carthage-space-sciences/slant/prev/D_R4.jpg

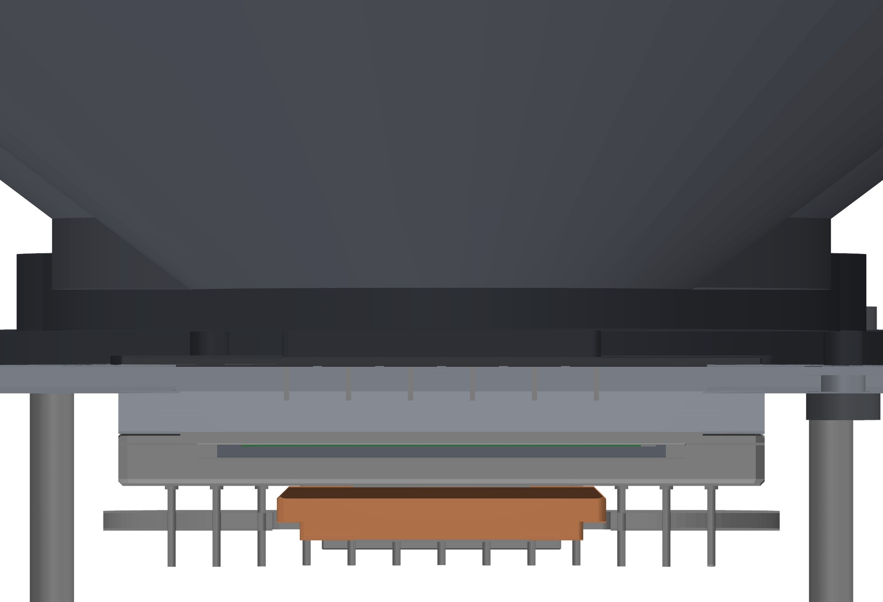
prev/D_R4.jpg
