carthage-space-sciences/slant/prev/M07.jpg

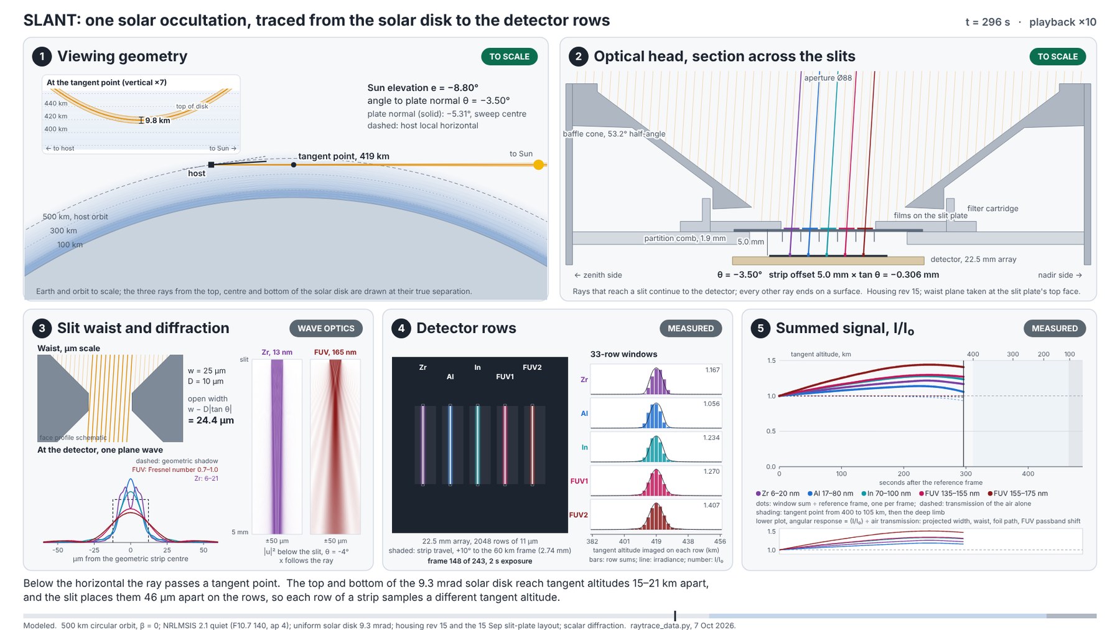
prev/M07.jpg
