carthage-space-sciences/slant/files/D_H03/SLANT-H03.pdf

## VIEW FROM OUTSIDE

## FEATURE TABLE

S1 | dia 2.80 thru (M2.5 clearance) H 76.68 V 4.01 (centre, from datum)
S2 | dia 2.80 thru (M2.5 clearance) H 76.68 V 101.49 (centre, from datum)

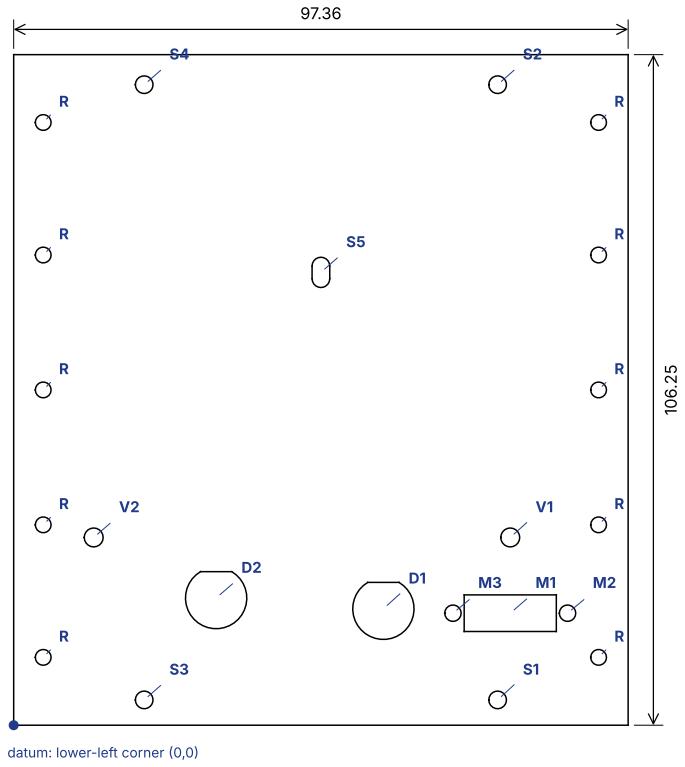
[picture p7: figure]
datum: lower-left corner (0,0)

S3 | dia 2.80 thru (M2.5 clearance) H 20.68 V 4.01 (centre, from datum)
S4 | dia 2.80 thru (M2.5 clearance) H 20.68 V 101.49 (centre, from datum)
S5 | Slot 2.80 wide x 4.80 long, vertical (bulkhead clip screw, +-1.0 travel); centre given H 48.68 V 71.75 (centre, from datum)
D1 | D-hole: dia 9.72 +-0.06, flat 9.04 +-0.05 from opposite side, flat toward the top edge (power receptacle, Glenair Series 801, shell 5) H 58.58 V 18.45 (centre, from datum)
D2 | D-hole: same as D1 (JTAG port) H 32.08 V 20.15 (centre, from datum)
M1 | Rectangle 14.60 x 5.80, corners R0.5 max (micro-D 15), long side horizontal H 78.68 V 17.75 (centre, from datum)
M2 | dia 2.60 thru (jackpost) H 87.76 V 17.75 (centre, from datum)
M3 | dia 2.60 thru (jackpost) H 69.60 V 17.75 (centre, from datum)
V1 | dia 3.00 thru (vent) H 78.68 V 29.75 (centre, from datum)
V2 | dia 3.00 thru (vent) H 12.68 V 29.75 (centre, from datum)

R 10x dia 2.50 thru (3/32 blind rivets to the corner angles):
| H 4.68 and 92.68; V 10.75, 31.75, 53.125, 74.5, 95.5
| Sheet 0.050 in (1.27 mm) 6061-T6. Laser, waterjet or router cut acceptable; hole positions +-0.1.

## NOTES

Units: millimetres. Third-angle projection. Tolerances unless stated: features and hole positions +-0.1; outline +-0.2.

Threads: ISO metric coarse, 6H. Holes marked INSERT are tapped for stainless free-running helical coil inserts,

length 1.5D, supplied and installed by the shop; drill and tap to the insert maker's data. Inserts flush to 0.25 below. Every drilled and tapped hole runs through to an open volume (venting). Break sharp edges 0.1-0.3; deburr all holes.

Finish: as machined for this unit. Please also quote: clear anodize MIL-A-8625 Type II Class 1, with the H01 host face

and the panel/angle faces under rivets masked and conversion coated MIL-DTL-5541 Type II Class 3 (electrical bonding).

Assembly is by Carthage: fasteners locked and torqued per the SLANT assembly procedure (to be issued).

Fit-check unit built to the flight layout. Material certs appreciated; no inspection report required.

Model: the STEP file of the same part number governs any dimension not shown here.

PART | SLANT-H03 panel -X (connectors)
MATERIAL | 6061-T6 sheet, 0.050 in (1.27 mm)
QTY | 1
MASS (model) | 34 g
PROJECT | SLANT 1U housing, assembly rev 16
OWNER | Carthage College, Space Sciences
DRAWN / CHECKED | from model 2026-10-08 / ________
SHEET REV | D
