carthage-space-sciences/slant/files/D_H05/SLANT-H05.pdf

### VIEW FROM OUTSIDE

## FEATURE TABLE

S1 | dia 2.80 thru (M2.5 clearance) H 78.00 V 4.01 (centre, from datum)
S2 | dia 2.80 thru (M2.5 clearance) H 78.00 V 101.49 (centre, from datum)

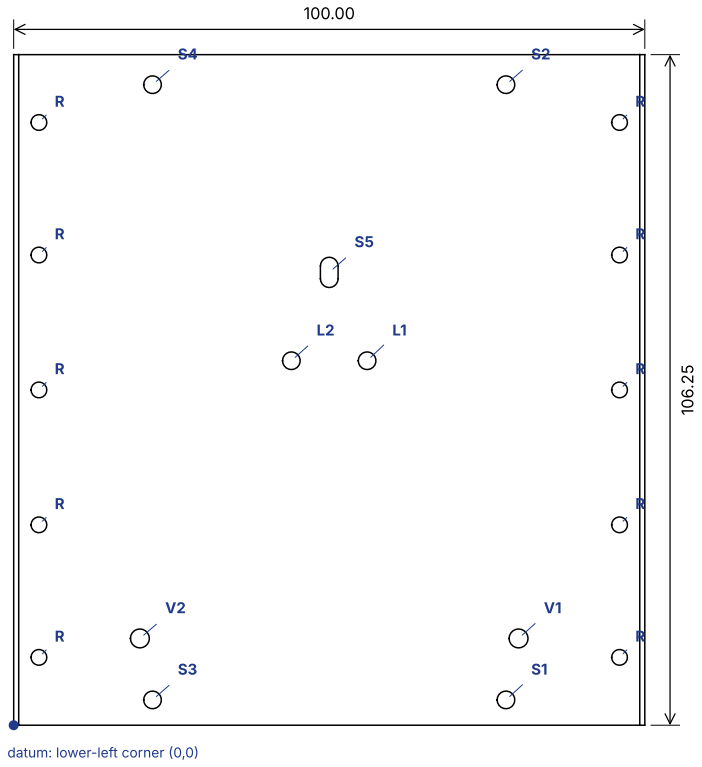
[picture p8: figure]
datum: lower-left corner (0,0)

S3 | dia 2.80 thru (M2.5 clearance) H 22.00 V 4.01 (centre, from datum)
S4 | dia 2.80 thru (M2.5 clearance) H 22.00 V 101.49 (centre, from datum)
S5 | Slot 2.80 wide x 4.80 long, vertical (bulkhead clip screw, +-1.0 travel); centre given H 50.00 V 71.75 (centre, from datum)
L1 | dia 2.80 thru (wall lug screws) H 56.00 V 57.75 (centre, from datum)
L2 | dia 2.80 thru (wall lug screws) H 44.00 V 57.75 (centre, from datum)
V1 | dia 3.00 thru (vent) H 80.00 V 13.75 (centre, from datum)
V2 | dia 3.00 thru (vent) H 20.00 V 13.75 (centre, from datum)

R 10x dia 2.50 thru (3/32 blind rivets to the corner angles):
| H 4.00 and 96.00; V 10.75, 31.75, 53.125, 74.5, 95.5
| Sheet 0.050 in (1.27 mm) 6061-T6. Laser, waterjet or router cut acceptable; hole positions +-0.1.

### NOTES

Units: millimetres. Third-angle projection. Tolerances unless stated: features and hole positions +-0.1; outline +-0.2.

Threads: ISO metric coarse, 6H. Holes marked INSERT are tapped for stainless free-running helical coil inserts,

length 1.5D, supplied and installed by the shop; drill and tap to the insert maker's data. Inserts flush to 0.25 below. Every drilled and tapped hole runs through to an open volume (venting). Break sharp edges 0.1-0.3; deburr all holes.

Finish: as machined for this unit. Please also quote: clear anodize MIL-A-8625 Type II Class 1, with the H01 host face

and the panel/angle faces under rivets masked and conversion coated MIL-DTL-5541 Type II Class 3 (electrical bonding).

Assembly is by Carthage: fasteners locked and torqued per the SLANT assembly procedure (to be issued).

Fit-check unit built to the flight layout. Material certs appreciated; no inspection report required.

Model: the STEP file of the same part number governs any dimension not shown here.
Both vertical end edges on the OUTER face: chamfer 0.8 x 45 deg (clears the corner angle's root radius).
PART | SLANT-H05 panel +Y (lug holes)
MATERIAL | 6061-T6 sheet, 0.050 in (1.27 mm)
QTY | 1
MASS (model) | 36 g
PROJECT | SLANT 1U housing, assembly rev 16
OWNER | Carthage College, Space Sciences
DRAWN / CHECKED | from model 2026-10-08 / ________
SHEET REV | D
