carthage-space-sciences/slant/files/D_H07/SLANT-H07.pdf

LEG A (lies on a +-Y panel) | LEG B (lies on a +-X panel) 106.25

END VIEW

## FEATURE TABLE

A Leg A: 5x dia 2.50 thru, centres 5.59 from the heel (outside corner), V 10.75, 31.75, 53.125, 74.5, 95.5 from the bottom end

B Leg B: 5x dia 2.50 thru, centres 7.59 from the heel,
V 10.75, 31.75, 53.125, 74.5, 95.5 from the bottom end

S Stock: 6061-T6 angle 1/2 x 1/2 x 1/16 in (12.70 x 12.70 x 1.59), cut to 106.25 +0/-0.2,
ends square. Root radius inside the angle 1.0 max. If not stocked, machine from bar.

E Hole pattern is symmetric about mid-length: the part may be installed either end up.

### NOTES

Units: millimetres. Third-angle projection. Tolerances unless stated: features and hole positions +-0.1; outline +-0.2.

Threads: ISO metric coarse, 6H. Holes marked INSERT are tapped for stainless free-running helical coil inserts,

length 1.5D, supplied and installed by the shop; drill and tap to the insert maker's data. Inserts flush to 0.25 below.

Every drilled and tapped hole runs through to an open volume (venting). Break sharp edges 0.1-0.3; deburr all holes. Finish: as machined for this unit. Please also quote: clear anodize MIL-A-8625 Type II Class 1, with the H01 host face

and the panel/angle faces under rivets masked and conversion coated MIL-DTL-5541 Type II Class 3 (electrical bonding). Assembly is by Carthage: fasteners locked and torqued per the SLANT assembly procedure (to be issued).

Fit-check unit built to the flight layout. Material certs appreciated; no inspection report required.

Model: the STEP file of the same part number governs any dimension not shown here.

PART | SLANT-H07 Corner angle
MATERIAL | 6061-T6 angle, 1/2 x 1/2 x 1/16 in
QTY | 3
MASS (model) | 10.6 g
PROJECT | SLANT 1U housing, assembly rev 16
OWNER | Carthage College, Space Sciences
DRAWN / CHECKED | from model 2026-10-08 / ________
SHEET REV | D
