carthage-space-sciences/slant/files/D_SET/SLANT-Housing-revD-Drawings.pdf

TOP VIEW (inner face) | BOTTOM VIEW (host face)

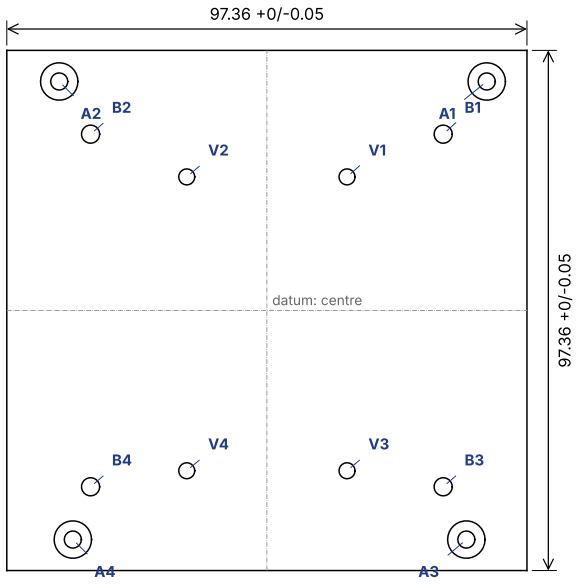
[picture p10: figure]
B1 A1 V1 datum: centre

### FRONT VIEW (from -Y), hidden lines dashed

8.52

## 12.97 +-0.05 (boss tops)

C C

## FEATURE TABLE

A1 | M3x0.5 INSERT thru boss and plate; boss dia 7.0, top 12.97 above host face. X 41.15 Y 42.86 (+-0.05, PC/104 pattern)
A2 | M3x0.5 INSERT thru boss and plate; boss dia 7.0, top 12.97 above host face. X -38.87 Y 42.86 (+-0.05, PC/104 pattern)

POCKET depth 6.02 from host face (web 2.50)

A3 | M3x0.5 INSERT thru boss and plate; boss dia 7.0, top 12.97 above host face. X 37.33 Y -42.88 (+-0.05, PC/104 pattern)
A4 | M3x0.5 INSERT thru boss and plate; boss dia 7.0, top 12.97 above host face. X -36.32 Y -42.88 (+-0.05, PC/104 pattern)
B1 | dia 3.40 thru (M3 host screw). X 33.00 Y 33.00
B2 | dia 3.40 thru (M3 host screw). X -33.00 Y 33.00
B3 | dia 3.40 thru (M3 host screw). X 33.00 Y -33.00
B4 | dia 3.40 thru (M3 host screw). X -33.00 Y -33.00
V1 | dia 3.00 thru web (vents the pocket). X 15.00 Y 25.00
V2 | dia 3.00 thru web (vents the pocket). X -15.00 Y 25.00
V3 | dia 3.00 thru web (vents the pocket). X 15.00 Y -30.00
V4 | dia 3.00 thru web (vents the pocket). X -15.00 Y -30.00

C 8x M2.5x0.45 INSERT into the four edges, 2 per edge at +-28.0 from
| centre, 4.26 above host face, 6.5 deep (breaks into pocket)

P Underside pocket, depth 6.02, R3.0 corners. Leaves: perimeter band 6.0 wide; 4x pads 14 sq at B1-B4; 4x round pads dia 9.0 under A1-A4.

F Host face (bottom) flat within 0.05. Inner face flat within 0.05 (carries the converter thermal block).

R Pocket inside corners: where a round pad meets a square pad or the band, R1.30 (the shape a dia 2.6 cutter leaves; the 2.68 channels between pads and band stay open). Corners between the pocket walls and the web underside: R1.5 max.

### NOTES

Units: millimetres. Third-angle projection. Tolerances unless stated: features and hole positions +-0.1; outline +-0.2.

Threads: ISO metric coarse, 6H. Holes marked INSERT are tapped for stainless free-running helical coil inserts,

length 1.5D, supplied and installed by the shop; drill and tap to the insert maker's data. Inserts flush to 0.25 below. Every drilled and tapped hole runs through to an open volume (venting). Break sharp edges 0.1-0.3; deburr all holes.

Finish: as machined for this unit. Please also quote: clear anodize MIL-A-8625 Type II Class 1, with the H01 host face
and the panel/angle faces under rivets masked and conversion coated MIL-DTL-5541 Type II Class 3 (electrical bonding).

Assembly is by Carthage: fasteners locked and torqued per the SLANT assembly procedure (to be issued).

Fit-check unit built to the flight layout. Material certs appreciated; no inspection report required.

Model: the STEP file of the same part number governs any dimension not shown here.

Bottom face meets the host bracket; inner face carries the board stack and the converter block.

PART | SLANT-H01 Base plate
MATERIAL | 6061-T6 plate, 5/8 in stock
QTY | 1
MASS (model) | 113 g
PROJECT | SLANT 1U housing, assembly rev 16
OWNER | Carthage College, Space Sciences
DRAWN / CHECKED | from model 2026-10-08 / ________
SHEET REV | D

TOP VIEW (outer face = aperture plane) | BOTTOM VIEW

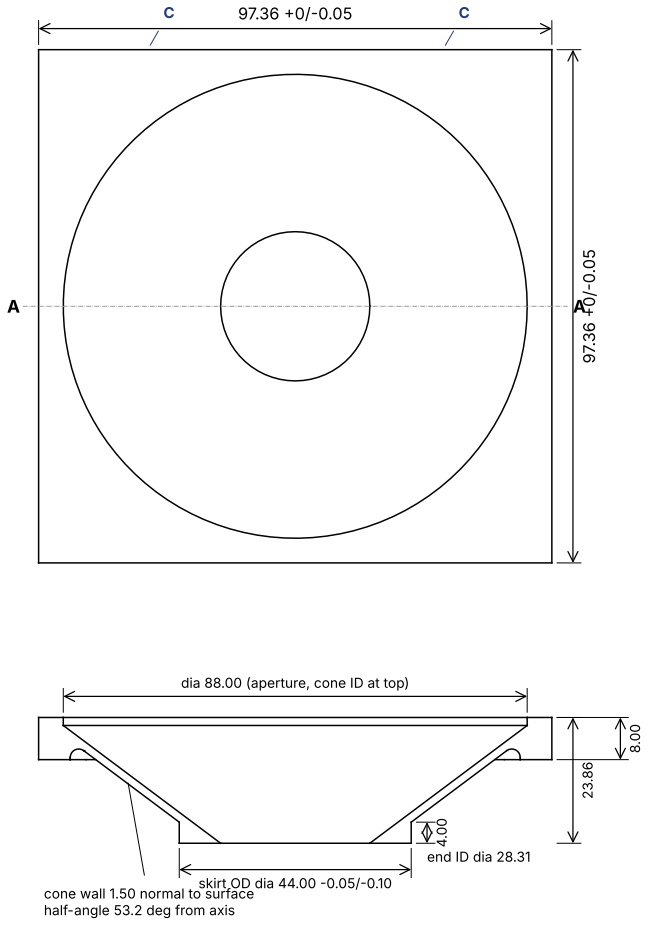
[picture p11: figure]
dia 88.00 (aperture, cone ID at top); skirt OD dia 44.00 -0.05/-0.10; end ID dia 28.31; half-angle 53.2 deg from axis

### SECTION A-A (through the axis, seen from -Y)

cone wall 1.50 normal to surface

underside pocket: square 85.36, R3.0,

to 1.52 below the outer face

A Aperture and cone ID: dia 88.00 +-0.10 at the plane 1.52 below the outer face, straight through the 1.52 web; the cone ID narrows at 53.19 deg half-angle to dia 28.31 at the skirt end face. Concentric with outline within 0.1.

W Cone wall 1.50 +-0.10 measured normal to the surface (OD is the ID offset 2.50 radially).

K Skirt at the small end: cylindrical OD dia 44.00 -0.05/-0.10, concentric with the cone ID within 0.05, running 4.00 up from the end face to where it meets the cone OD. End face flat and square to the axis within 0.05, 23.86 +-0.05 below the outer face. The skirt runs inside the H09 collar with 0.5 radial clearance and must not touch it.

P Underside pocket around the cone: square 85.36 with R3.0 corners, 6.48 deep from the inner rim face, leaving a 6.0 rim and a 1.52 web.

C 8x M2.5x0.45 INSERT into the four edges, 2 per edge at +-28.0 from centre, 4.76 below the outer face, thru the rim into the pocket

F Outer face flat within 0.05 (aperture plane). CONE ID FINISH: after turning, bead blast or etch to a matte texture of 0.1 rad rms facet slope or more; turning marks alone do not satisfy this. Black anodize or low-outgassing black coating follows for flight; as-blasted is acceptable for this unit.

M Suggested process: mill square, pocket corners and edge holes; turn cone ID from the aperture side, and the cone OD, skirt OD and end face from below, in a 4-jaw chuck. 3D-contoured cone OD also acceptable.

R Inside corners: R1.6 fillet along the four junctions of the cone OD with the flat pocket walls, blended into the web. Other pocket corners R1.5 max (R3.0 vertical corners as drawn). Where the skirt OD meets the cone OD: tool nose R1.0 max.

### NOTES

Units: millimetres. Third-angle projection. Tolerances unless stated: features and hole positions +-0.1; outline +-0.2.

Threads: ISO metric coarse, 6H. Holes marked INSERT are tapped for stainless free-running helical coil inserts,

length 1.5D, supplied and installed by the shop; drill and tap to the insert maker's data. Inserts flush to 0.25 below. Every drilled and tapped hole runs through to an open volume (venting). Break sharp edges 0.1-0.3; deburr all holes.

Finish: as machined for this unit. Please also quote: clear anodize MIL-A-8625 Type II Class 1, with the H01 host face
and the panel/angle faces under rivets masked and conversion coated MIL-DTL-5541 Type II Class 3 (electrical bonding).

Assembly is by Carthage: fasteners locked and torqued per the SLANT assembly procedure (to be issued).

Fit-check unit built to the flight layout. Material certs appreciated; no inspection report required.

Model: the STEP file of the same part number governs any dimension not shown here.

The cone is optical: no dents or tool marks on its inside surface. Protect it in packing.

PART | SLANT-H02 Top plate with integral baffle
MATERIAL | 6061-T6 plate, 1 in stock (finished 23.86)
QTY | 1
MASS (model) | 84 g
PROJECT | SLANT 1U housing, assembly rev 16
OWNER | Carthage College, Space Sciences

### VIEW FROM OUTSIDE

S1 | dia 2.80 thru (M2.5 clearance) H 76.68 V 4.01 (centre, from datum)
S2 | dia 2.80 thru (M2.5 clearance) H 76.68 V 101.49 (centre, from datum)

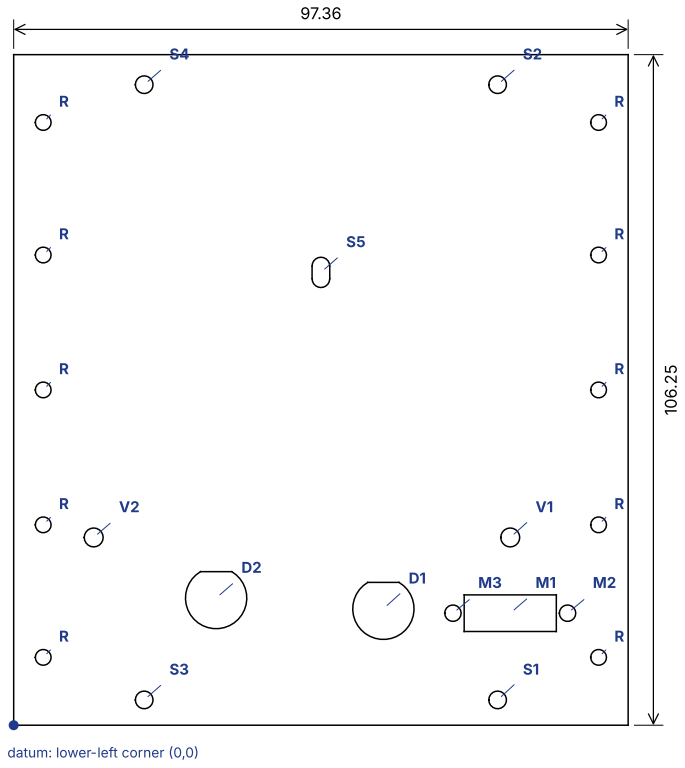
[picture p12: figure]
datum: lower-left corner (0,0)

S3 | dia 2.80 thru (M2.5 clearance) H 20.68 V 4.01 (centre, from datum)
S4 | dia 2.80 thru (M2.5 clearance) H 20.68 V 101.49 (centre, from datum)
S5 | Slot 2.80 wide x 4.80 long, vertical (bulkhead clip screw, +-1.0 travel); centre given H 48.68 V 71.75 (centre, from datum)
D1 | D-hole: dia 9.72 +-0.06, flat 9.04 +-0.05 from opposite side, flat toward the top edge (power receptacle, Glenair Series 801, shell 5) H 58.58 V 18.45 (centre, from datum)
D2 | D-hole: same as D1 (JTAG port) H 32.08 V 20.15 (centre, from datum)
M1 | Rectangle 14.60 x 5.80, corners R0.5 max (micro-D 15), long side horizontal H 78.68 V 17.75 (centre, from datum)
M2 | dia 2.60 thru (jackpost) H 87.76 V 17.75 (centre, from datum)
M3 | dia 2.60 thru (jackpost) H 69.60 V 17.75 (centre, from datum)
V1 | dia 3.00 thru (vent) H 78.68 V 29.75 (centre, from datum)
V2 | dia 3.00 thru (vent) H 12.68 V 29.75 (centre, from datum)

R 10x dia 2.50 thru (3/32 blind rivets to the corner angles):
| H 4.68 and 92.68; V 10.75, 31.75, 53.125, 74.5, 95.5
| Sheet 0.050 in (1.27 mm) 6061-T6. Laser, waterjet or router cut acceptable; hole positions +-0.1.

### NOTES

Units: millimetres. Third-angle projection. Tolerances unless stated: features and hole positions +-0.1; outline +-0.2.

Threads: ISO metric coarse, 6H. Holes marked INSERT are tapped for stainless free-running helical coil inserts,

length 1.5D, supplied and installed by the shop; drill and tap to the insert maker's data. Inserts flush to 0.25 below. Every drilled and tapped hole runs through to an open volume (venting). Break sharp edges 0.1-0.3; deburr all holes.

Finish: as machined for this unit. Please also quote: clear anodize MIL-A-8625 Type II Class 1, with the H01 host face
and the panel/angle faces under rivets masked and conversion coated MIL-DTL-5541 Type II Class 3 (electrical bonding).

Assembly is by Carthage: fasteners locked and torqued per the SLANT assembly procedure (to be issued).

Fit-check unit built to the flight layout. Material certs appreciated; no inspection report required.

Model: the STEP file of the same part number governs any dimension not shown here.

PART | SLANT-H03 panel -X (connectors)
MATERIAL | 6061-T6 sheet, 0.050 in (1.27 mm)
QTY | 1
MASS (model) | 34 g
PROJECT | SLANT 1U housing, assembly rev 16
OWNER | Carthage College, Space Sciences

### VIEW FROM OUTSIDE

H 20.68 V 4.01 (centre, from datum)

S2 | dia 2.80 thru (M2.5 clearance) H 20.68 V 101.49 (centre, from datum)

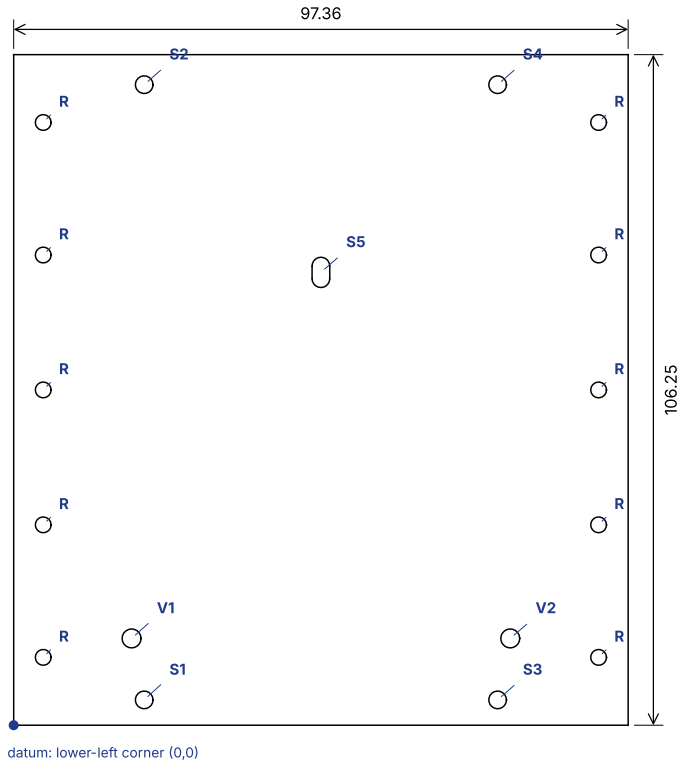
[picture p13: figure]
datum: lower-left corner (0,0)

S3 | dia 2.80 thru (M2.5 clearance) H 76.68 V 4.01 (centre, from datum)
S4 | dia 2.80 thru (M2.5 clearance) H 76.68 V 101.49 (centre, from datum)
S5 | Slot 2.80 wide x 4.80 long, vertical (bulkhead clip screw, +-1.0 travel); centre given H 48.68 V 71.75 (centre, from datum)
V1 | dia 3.00 thru (vent) H 18.68 V 13.75 (centre, from datum)
V2 | dia 3.00 thru (vent) H 78.68 V 13.75 (centre, from datum)

R 10x dia 2.50 thru (3/32 blind rivets to the corner angles):
| H 4.68 and 92.68; V 10.75, 31.75, 53.125, 74.5, 95.5
| Sheet 0.050 in (1.27 mm) 6061-T6. Laser, waterjet or router cut acceptable; hole positions +-0.1.

### NOTES

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

Assembly is by Carthage: fasteners locked and torqued per the SLANT assembly procedure (to be issued).

Fit-check unit built to the flight layout. Material certs appreciated; no inspection report required.

Model: the STEP file of the same part number governs any dimension not shown here.

PART | SLANT-H04 panel +X
MATERIAL | 6061-T6 sheet, 0.050 in (1.27 mm)
QTY | 1
MASS (model) | 35 g
PROJECT | SLANT 1U housing, assembly rev 16
OWNER | Carthage College, Space Sciences

### VIEW FROM OUTSIDE

H 78.00 V 4.01 (centre, from datum)

S2 | dia 2.80 thru (M2.5 clearance) H 78.00 V 101.49 (centre, from datum)

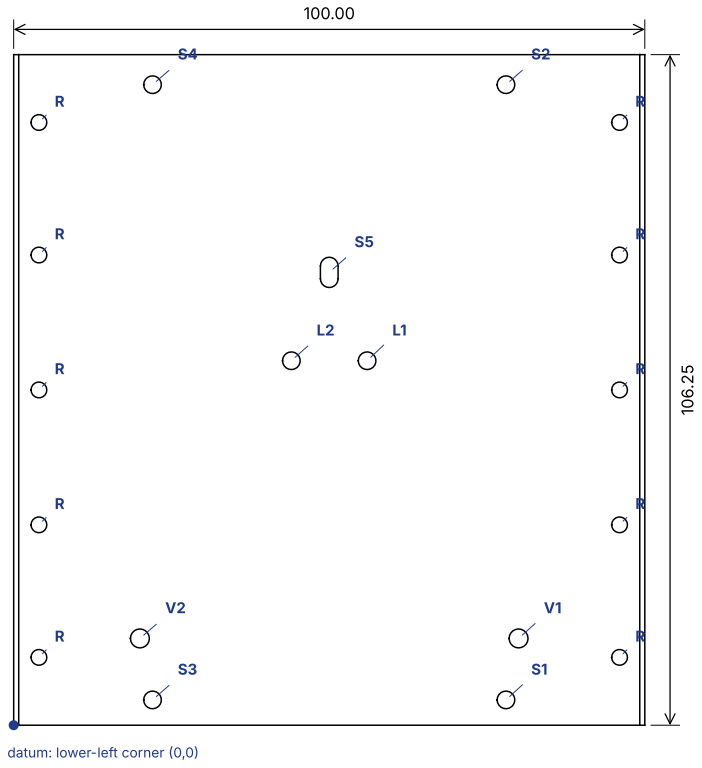
[picture p14: figure]
datum: lower-left corner (0,0)

S3 | dia 2.80 thru (M2.5 clearance) H 22.00 V 4.01 (centre, from datum)
S4 | dia 2.80 thru (M2.5 clearance) H 22.00 V 101.49 (centre, from datum)
S5 | Slot 2.80 wide x 4.80 long, vertical (bulkhead clip screw, +-1.0 travel); centre given H 50.00 V 71.75 (centre, from datum)
L1 | dia 2.80 thru (wall lug screws) H 56.00 V 57.75 (centre, from datum)
L2 | dia 2.80 thru (wall lug screws) H 44.00 V 57.75 (centre, from datum)
V1 | dia 3.00 thru (vent) H 80.00 V 13.75 (centre, from datum)
V2 | dia 3.00 thru (vent) H 20.00 V 13.75 (centre, from datum)

R 10x dia 2.50 thru (3/32 blind rivets to the corner angles):
| H 4.00 and 96.00; V 10.75, 31.75, 53.125, 74.5, 95.5
| Sheet 0.050 in (1.27 mm) 6061-T6. Laser, waterjet or router cut acceptable; hole positions +-0.1.

### NOTES

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

Assembly is by Carthage: fasteners locked and torqued per the SLANT assembly procedure (to be issued).

Fit-check unit built to the flight layout. Material certs appreciated; no inspection report required.

Model: the STEP file of the same part number governs any dimension not shown here.
Both vertical end edges on the OUTER face: chamfer 0.8 x 45 deg (clears the corner angle's root radius).
PART | SLANT-H05 panel +Y (lug holes)
MATERIAL | 6061-T6 sheet, 0.050 in (1.27 mm)
QTY | 1
MASS (model) | 36 g
PROJECT | SLANT 1U housing, assembly rev 16
OWNER | Carthage College, Space Sciences

### VIEW FROM OUTSIDE

H 22.00 V 4.01 (centre, from datum)

S2 | dia 2.80 thru (M2.5 clearance) H 22.00 V 101.49 (centre, from datum)

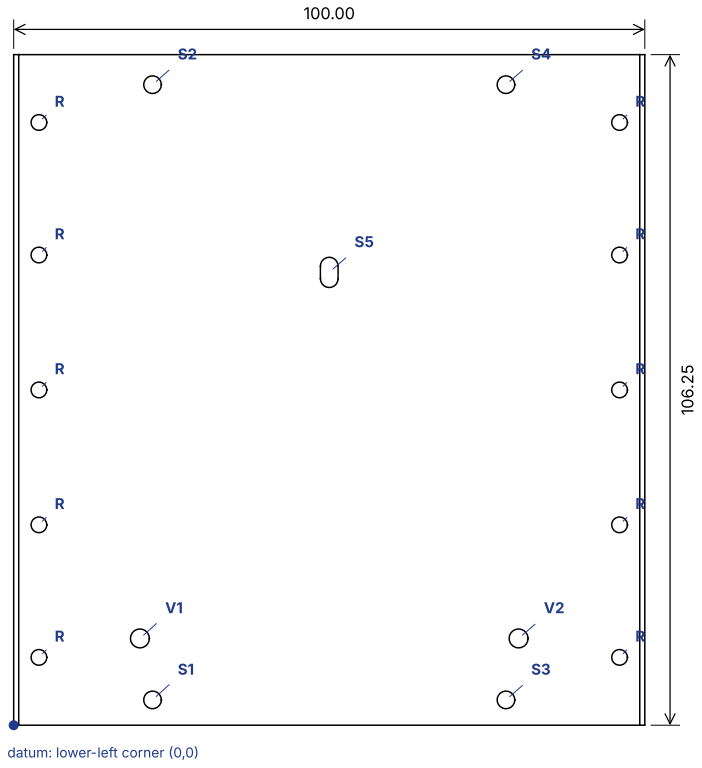
[picture p15: figure]
datum: lower-left corner (0,0)

S3 | dia 2.80 thru (M2.5 clearance) H 78.00 V 4.01 (centre, from datum)
S4 | dia 2.80 thru (M2.5 clearance) H 78.00 V 101.49 (centre, from datum)
S5 | Slot 2.80 wide x 4.80 long, vertical (bulkhead clip screw, +-1.0 travel); centre given H 50.00 V 71.75 (centre, from datum)
V1 | dia 3.00 thru (vent) H 20.00 V 13.75 (centre, from datum)
V2 | dia 3.00 thru (vent) H 80.00 V 13.75 (centre, from datum)

R 10x dia 2.50 thru (3/32 blind rivets to the corner angles):
| H 4.00 and 96.00; V 10.75, 31.75, 53.125, 74.5, 95.5
| Sheet 0.050 in (1.27 mm) 6061-T6. Laser, waterjet or router cut acceptable; hole positions +-0.1.

### NOTES

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

Assembly is by Carthage: fasteners locked and torqued per the SLANT assembly procedure (to be issued).

Fit-check unit built to the flight layout. Material certs appreciated; no inspection report required.

Model: the STEP file of the same part number governs any dimension not shown here.
Both vertical end edges on the OUTER face: chamfer 0.8 x 45 deg (clears the corner angle's root radius).
PART | SLANT-H06 panel -Y
MATERIAL | 6061-T6 sheet, 0.050 in (1.27 mm)
QTY | 1
MASS (model) | 36 g
PROJECT | SLANT 1U housing, assembly rev 16
OWNER | Carthage College, Space Sciences

LEG A (lies on a +-Y panel) | LEG B (lies on a +-X panel) 106.25

END VIEW

A Leg A: 5x dia 2.50 thru, centres 5.59 from the heel (outside corner), V 10.75, 31.75, 53.125, 74.5, 95.5 from the bottom end

B Leg B: 5x dia 2.50 thru, centres 7.59 from the heel,
V 10.75, 31.75, 53.125, 74.5, 95.5 from the bottom end

S Stock: 6061-T6 angle 1/2 x 1/2 x 1/16 in (12.70 x 12.70 x 1.59), cut to 106.25 +0/-0.2,
ends square. Root radius inside the angle 1.0 max. If not stocked, machine from bar.

E Hole pattern is symmetric about mid-length: the part may be installed either end up.

### NOTES

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

Assembly is by Carthage: fasteners locked and torqued per the SLANT assembly procedure (to be issued).

Fit-check unit built to the flight layout. Material certs appreciated; no inspection report required.

Model: the STEP file of the same part number governs any dimension not shown here.

PART | SLANT-H07 Corner angle
MATERIAL | 6061-T6 angle, 1/2 x 1/2 x 1/16 in
QTY | 3
MASS (model) | 10.6 g
PROJECT | SLANT 1U housing, assembly rev 16
OWNER | Carthage College, Space Sciences

LEG A (lies on a +-Y panel) | LEG B (lies on a +-X panel) 106.25

END VIEW

A Leg A: 5x dia 2.50 thru, centres 5.59 from the heel (outside corner), V 10.75, 31.75, 53.125, 74.5, 95.5 from the bottom end

B Leg B: 5x dia 2.50 thru, centres 7.59 from the heel,
V 10.75, 31.75, 53.125, 74.5, 95.5 from the bottom end

S Stock: 6061-T6 angle 1/2 x 1/2 x 1/16 in (12.70 x 12.70 x 1.59), cut to 106.25 +0/-0.2,
ends square. Root radius inside the angle 1.0 max. If not stocked, machine from bar.

E Hole pattern is symmetric about mid-length: the part may be installed either end up.

N Notch in leg B, from the free edge: 4.61 deep, V 13.35 to 22.25
from the bottom end, inside corners R1.5 max (clears the micro-D jackposts).
This end is the BOTTOM: mark it.

### NOTES

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

Assembly is by Carthage: fasteners locked and torqued per the SLANT assembly procedure (to be issued).

Fit-check unit built to the flight layout. Material certs appreciated; no inspection report required.

Model: the STEP file of the same part number governs any dimension not shown here.

PART | SLANT-H08 Corner angle, notched
MATERIAL | 6061-T6 angle, 1/2 x 1/2 x 1/16 in
QTY | 1
MASS (model) | 10.5 g
PROJECT | SLANT 1U housing, assembly rev 16
OWNER | Carthage College, Space Sciences

### TOP VIEW (looking down the baffle axis)

dia 56.40; collar ID dia 45.00 +0.10/0; pocket 36.20 sq

### SECTION A-A (through the axis, seen from -Y)

O Flange dia 56.40, 2.00 thick; lower face is the mounting face, flat within 0.02.

C Collar: ID dia 45.00 +0.10/0, OD dia 48.00, top 6.36 above the mounting face; concentric with the window centre within 0.05.

P Pocket in the mounting face for the slit plate: 36.20 x 36.20, with 4x corner reliefs dia 3.175 (1/8 in tool), centres at X +-17.10 Y
+-17.10, same depth as the pocket, so a square-cornered plate seats. Depth equal to the measured thickness of the slit plate (0.50 nominal), so the plate's lower face is flush with the mounting face within 0.01. Carthage bonds the plate into the pocket.

W Window over the film field: 18.00 x 15.00 thru the flange, corners R0.5 to R1.6 (shop's choice), long side along X. Assumes films 3.0 x 14.0 per slit (1.5 beyond each side of a slit, 2.0 beyond each end); revise when Luxel gives the film margin.

S1 | dia 2.20 thru (M2 screw). X 22.69 Y 13.10
S2 | dia 2.20 thru (M2 screw). X -13.10 Y 22.69
S3 | dia 2.20 thru (M2 screw). X -22.69 Y -13.10
S4 | dia 2.20 thru (M2 screw). X 13.10 Y -22.69
D1 | dia 2.00 +0.012/0 thru (dowel, slip fit). X 6.78 Y 25.31
D2 | dia 2.00 +0.012/0 thru (dowel, slip fit). X -6.78 Y -25.31

F All surfaces visible from the window and the collar bore: matte, then
| black for flight (as the H02 cone). As machined is acceptable for
| this unit.

### NOTES

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

Assembly is by Carthage: fasteners locked and torqued per the SLANT assembly procedure (to be issued).

Fit-check unit built to the flight layout. Material certs appreciated; no inspection report required.

Model: the STEP file of the same part number governs any dimension not shown here.
Mounts to the optical bulkhead with 4 M2 screws into self-clinching nuts and 2 dowels; removable from above.
PART | SLANT-H09 Filter cartridge
MATERIAL | 6061-T6 plate, 3/8 in stock
QTY | 1
MASS (model) | 13.1 g
PROJECT | SLANT 1U housing, assembly rev 16
OWNER | Carthage College, Space Sciences
