carthage-space-sciences/slant/files/D_SP2/SLANT-SP2-revC.pdf

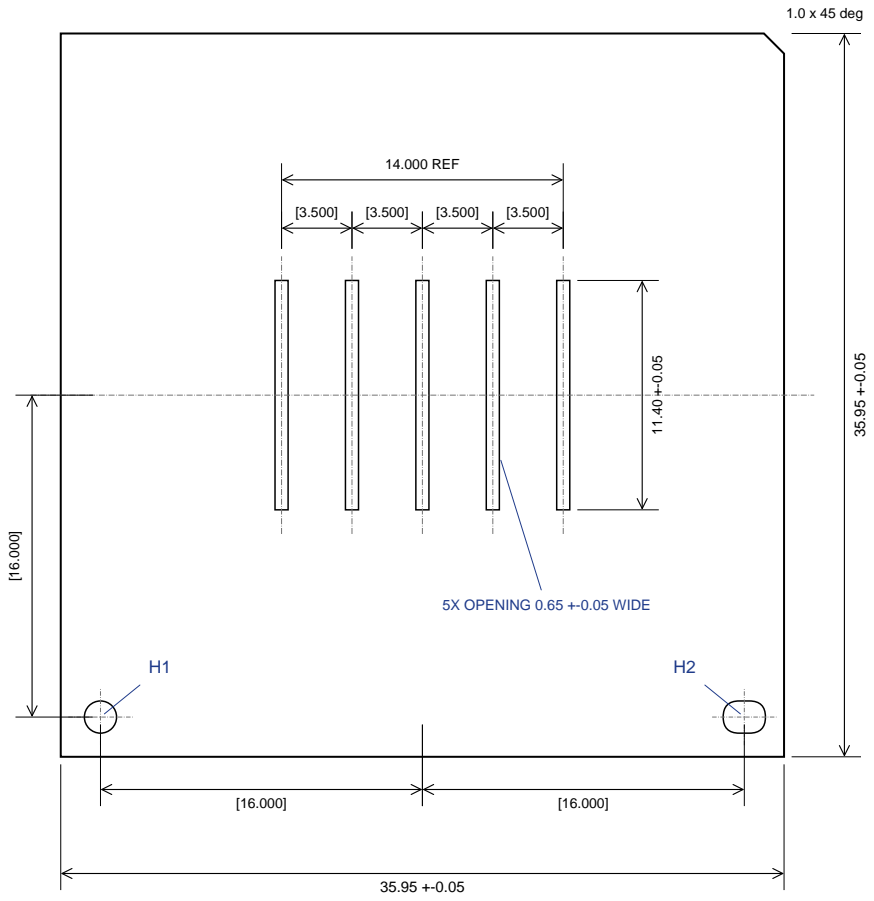
[picture p20: figure]
14.000 REF; 5X OPENING 0.65 +-0.05 WIDE; 1.0 x 45 deg

[ ] = basic, from the pattern center (the mean of the five opening centers).

### SP2 PLAN, VIEW OF FACE F

## FEATURE TABLE

STOCK | 304 stainless 0.254 (0.010 in) +-0.013, annealed.
OUTLINE | 35.95 square +-0.05, centered on the pattern within +-0.05; chamfer 1.0 x 45 deg at +X+Y.
OPENINGS | 5X, through. Width 0.65 +-0.05 at the narrowest point of the section. Length 11.40 +-0.05. Ends: any radius up to full.
POSITION | Centerlines at X = -7.000, -3.500, 0.000, +3.500, +7.000 from the pattern center; Y centered. Each within +-0.010 in X over its full length and +-0.025 in Y.
FACE F | Shown in the plan view.
FACE S | Opposite face.
H1 | Round hole dia 1.60 +-0.05 at X -16.000, Y -16.000, within +-0.025.
H2 | Slot 1.60 +-0.05 x 2.10 +-0.05, long axis along X, at X +16.000, Y -16.000, within +-0.025.
FLATNESS | 0.10, free state.
REPORT | Per part, by serial: width of each opening at 2, 5.7 and 9.4 mm along it; the five centerline positions; flatness.

### NOTES

1. Units: millimeters. Dimensions apply to the finished part at 20 C. Tolerances unless stated: +-0.05.
2. The plan view looks at face F. The 1.0 x 45 deg chamfer at the upper right sets orientation.
3. AISI 304 stainless, by photochemical machining (double-sided etch). The DXF of the same part number is the geometry for the photo-tool; this drawing sets the tolerances. Material certificate requested.
4. No burrs, oxide or etch residue at any aperture edge. Clean and oil-free. No coating, plating or marking on the part; identify each part by serial number on its package.
5. No oils or silicone-bearing materials in handling or packaging. Pack flat, separated by lint-free tissue.
PART | SLANT-SP2 Carrier plate
MATERIAL | AISI 304 stainless, 0.254
QTY | per PO
MASS (model) | 2.52 g
PROJECT | SLANT slit-plate assembly
OWNER | Carthage College, Space Sciences
STATUS | Issued for quote
DRAWN / CHECKED | from parameters 2026-10-28 / ________
SHEET REV | C
