carthage-space-sciences/slant/files/S_p1/SLANT-Visual-p1-2026-11-04.pdf

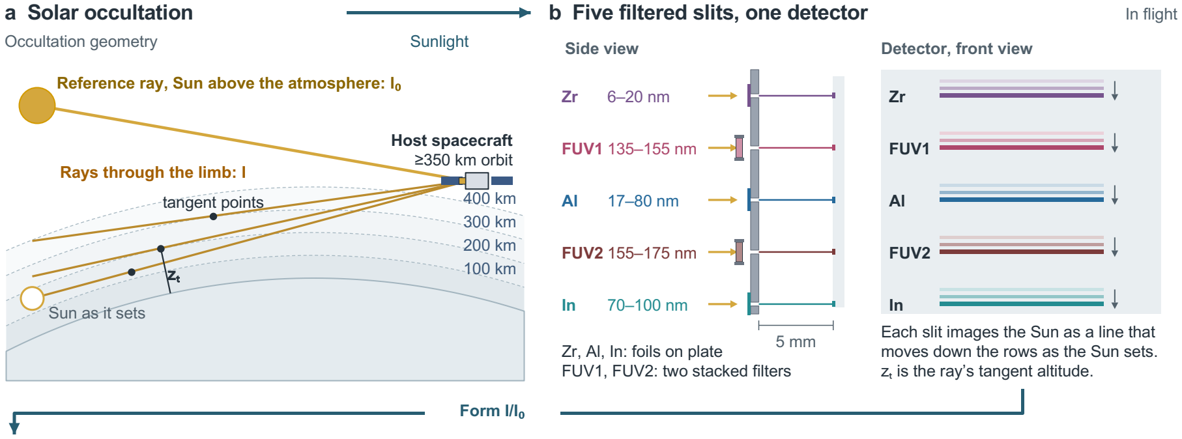
[picture p21: figure]
Sun as it sets; Rays through the limb: I; tangent points; Host spacecraft ≥350 km orbit; Side view; Detector, front view; FUV1 135–155 nm; FUV2 155–175 nm; 5 mm Zr, Al, In: foils on plate; FUV1, FUV2: two stacked filters; FUV1; FUV2; Sunlight; Form I/I₀; Occultation geometry; In flight; Each slit images the Sun as a line that moves down the rows as the Sun sets. zₜ is the ray’s tangent altitude.

Reference ray, Sun above the atmosphere: I₀

# How SLANT measures thermospheric composition

SLANT: Solar Limb Absorption of Neutrals in the Thermosphere

a Solar occultation | b Five filtered slits, one detector
c Transmission I/I₀ | d Slant columns

## e Profiles n(z), T(z)

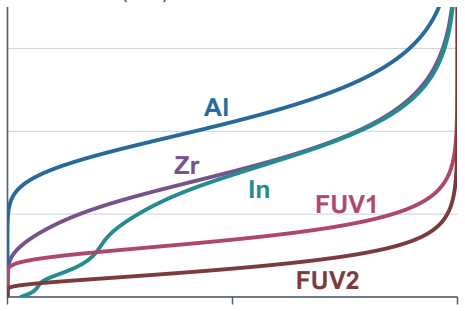
[picture p22: figure]

0 | 1000

T

T (K)

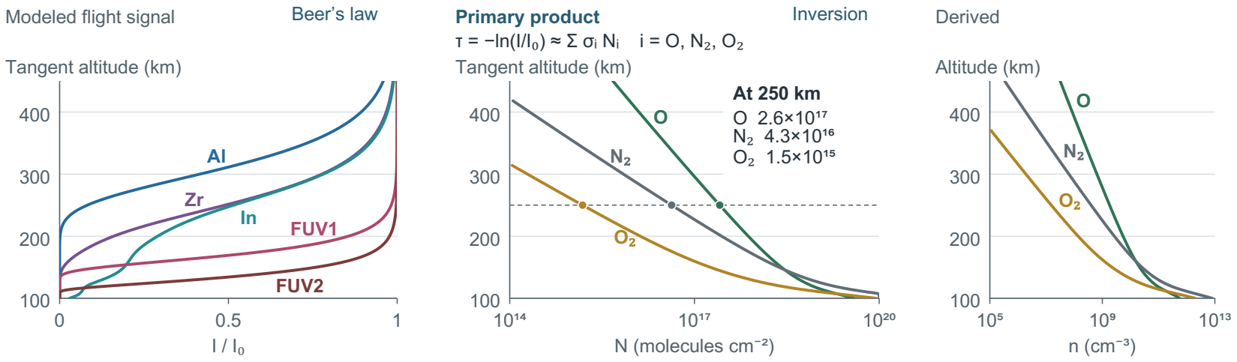
[picture p23: figure]
Primary product; Derived; N (molecules cm⁻²); Tangent altitude (km); Altitude (km); FUV1; FUV2; Beer’s law; Inversion; Modeled flight signal

Figure 1. I/I₀ gives optical depth; Beer’s law converts it to O, N₂ and O₂ slant columns, the primary product.
Inversion gives density and temperature. Curves in (c–e) model a quiet NRLMSIS 2.1 atmosphere; Zr and In use measured filter curves.
