carthage-space-sciences/slant/files/T_A5/SLANT-Bench-A5-Optical-Depth-2026-10-18.csv

calibrated_optical_depth | measured_error | limit_low | limit_high
0.6 | 0.0038119632699485455 | -0.02 | 0.02
0.8 | -0.002962109775879841 | -0.02 | 0.02
1.01 | -0.0009225700955409544 | -0.02 | 0.02
1.22 | 0.009593010251767155 | -0.02 | 0.02
1.42 | 0.000550571896416903 | -0.02 | 0.02
1.63 | 0.004558350279137868 | -0.02 | 0.02
1.84 | 0.006224331464080449 | -0.02 | 0.02
2.04 | -0.002152399575844222 | -0.02 | 0.02
2.25 | 0.0008288445338998122 | -0.02 | 0.02
