carthage-space-sciences/slant/files/D_R5/top-plate-baffle.png

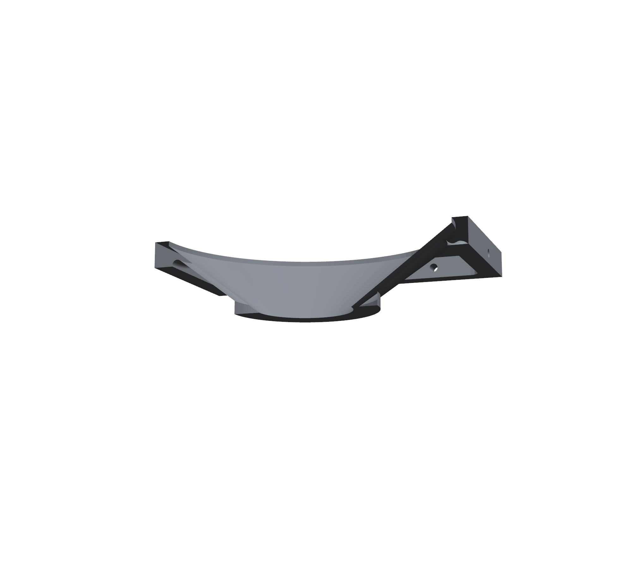
files/D_R5/top-plate-baffle.png
