carthage-space-sciences/slant/files/T_BENCH/bench-1-light-source.jpg

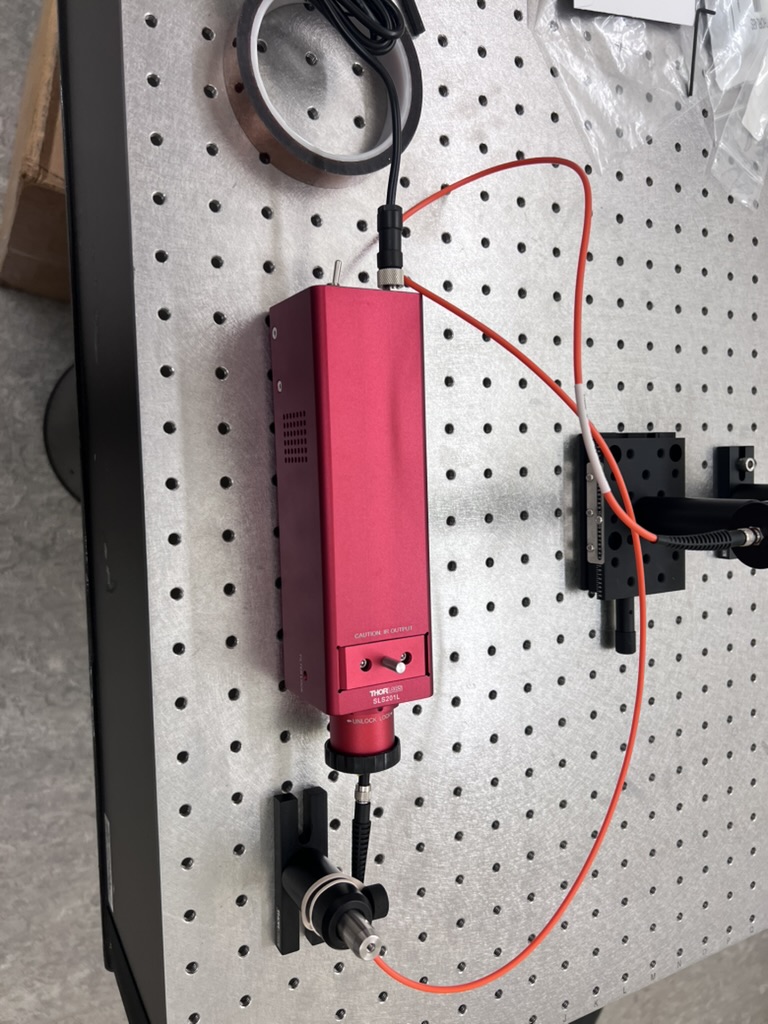
files/T_BENCH/bench-1-light-source.jpg
