carthage-space-sciences/slant/files/T_BENCH/bench-2-diffusers-pinhole-filter.jpg

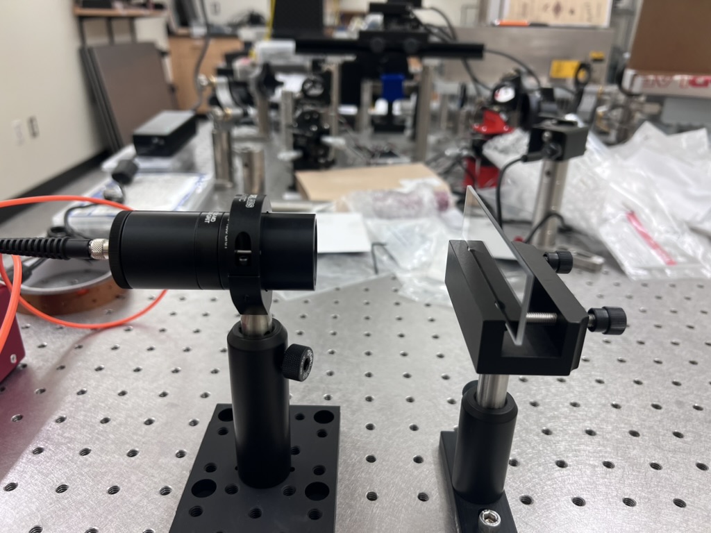
files/T_BENCH/bench-2-diffusers-pinhole-filter.jpg
