carthage-space-sciences/slant/files/T_BENCH/bench-3-camera-slit-baffle.jpg

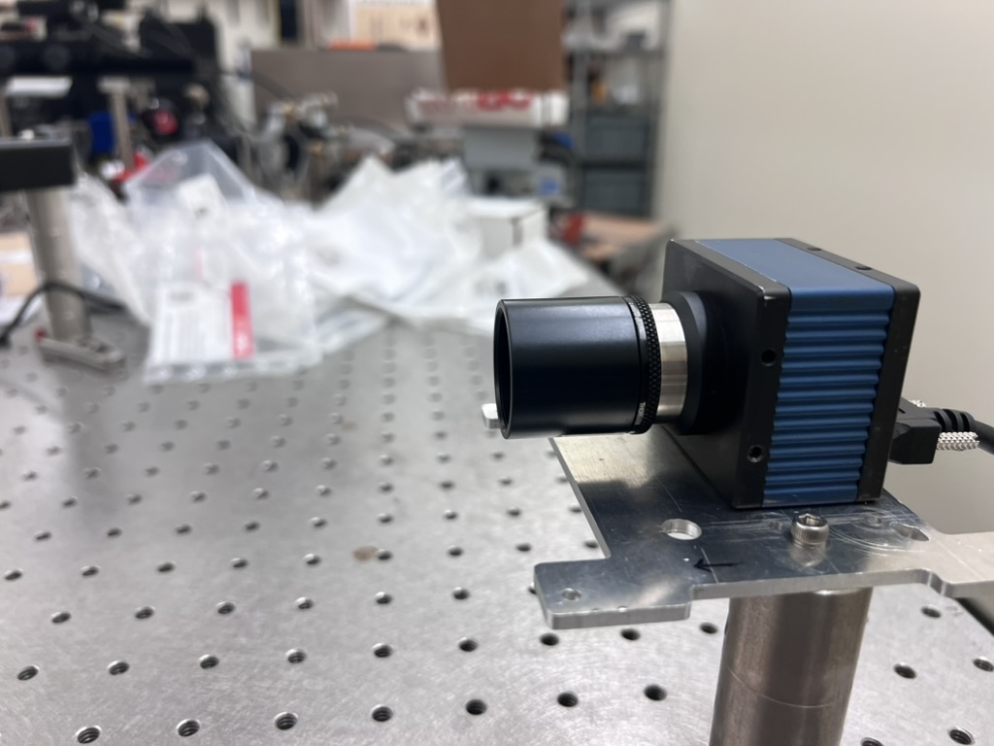
files/T_BENCH/bench-3-camera-slit-baffle.jpg
