carthage-space-sciences/slant/files/T_BENCH/SLANT-Bench-Photo-2026-10-15.png

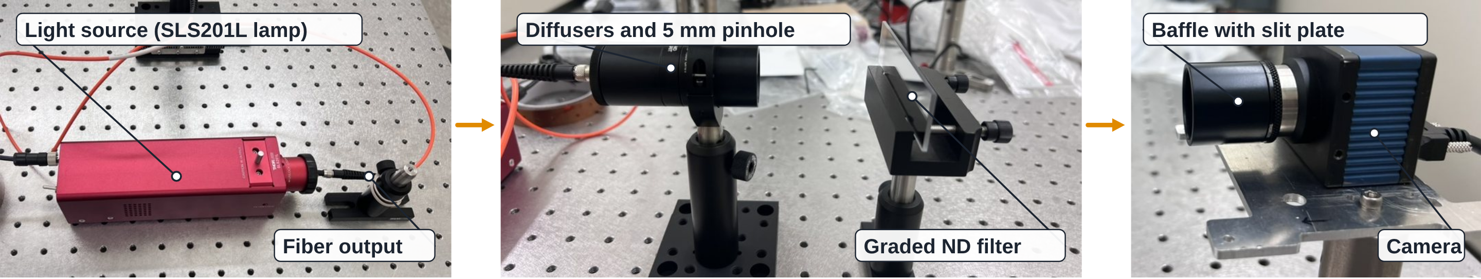
files/T_BENCH/SLANT-Bench-Photo-2026-10-15.png
