carthage-space-sciences/slant/prev/C_AVG.jpg

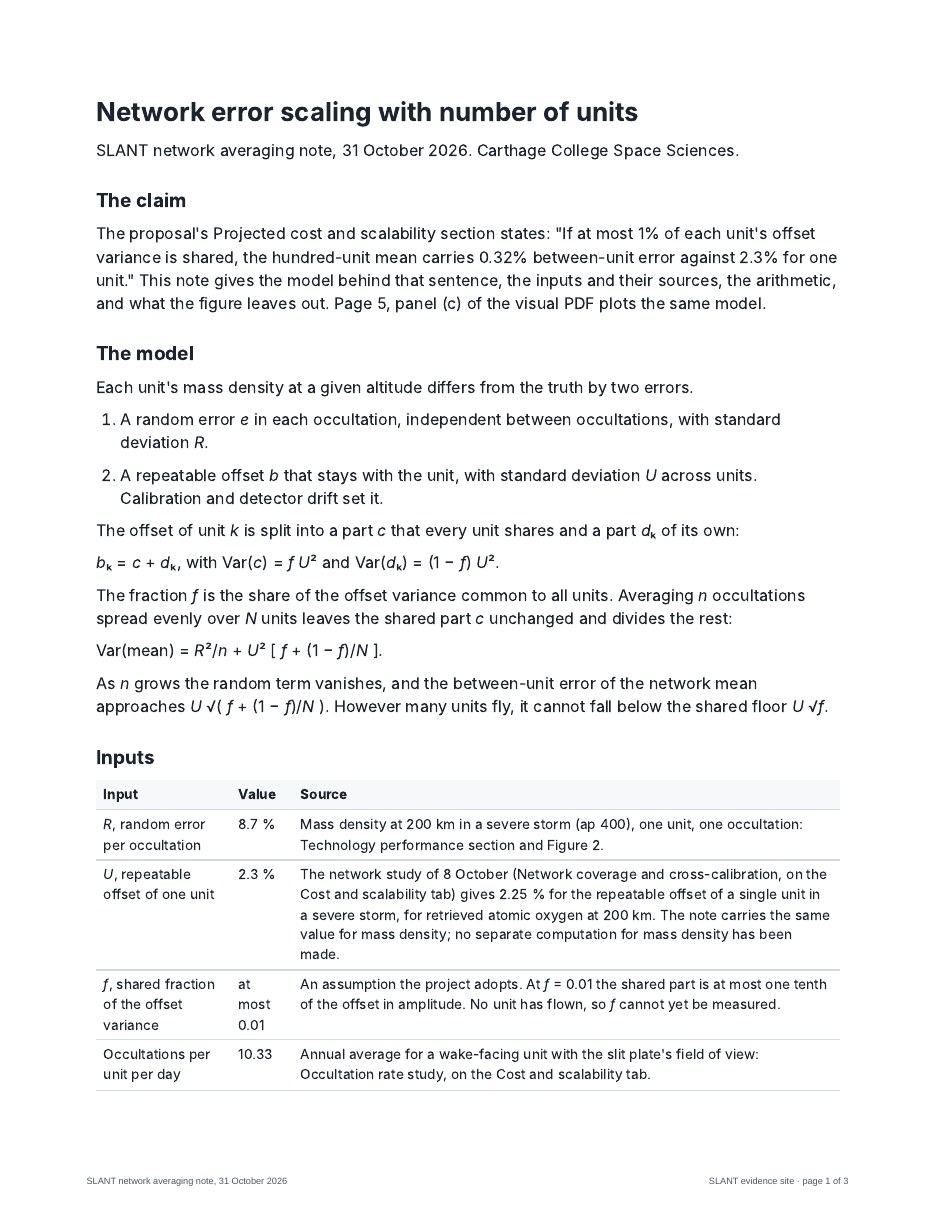
prev/C_AVG.jpg
