carthage-space-sciences/slant/prev/C_NET.jpg

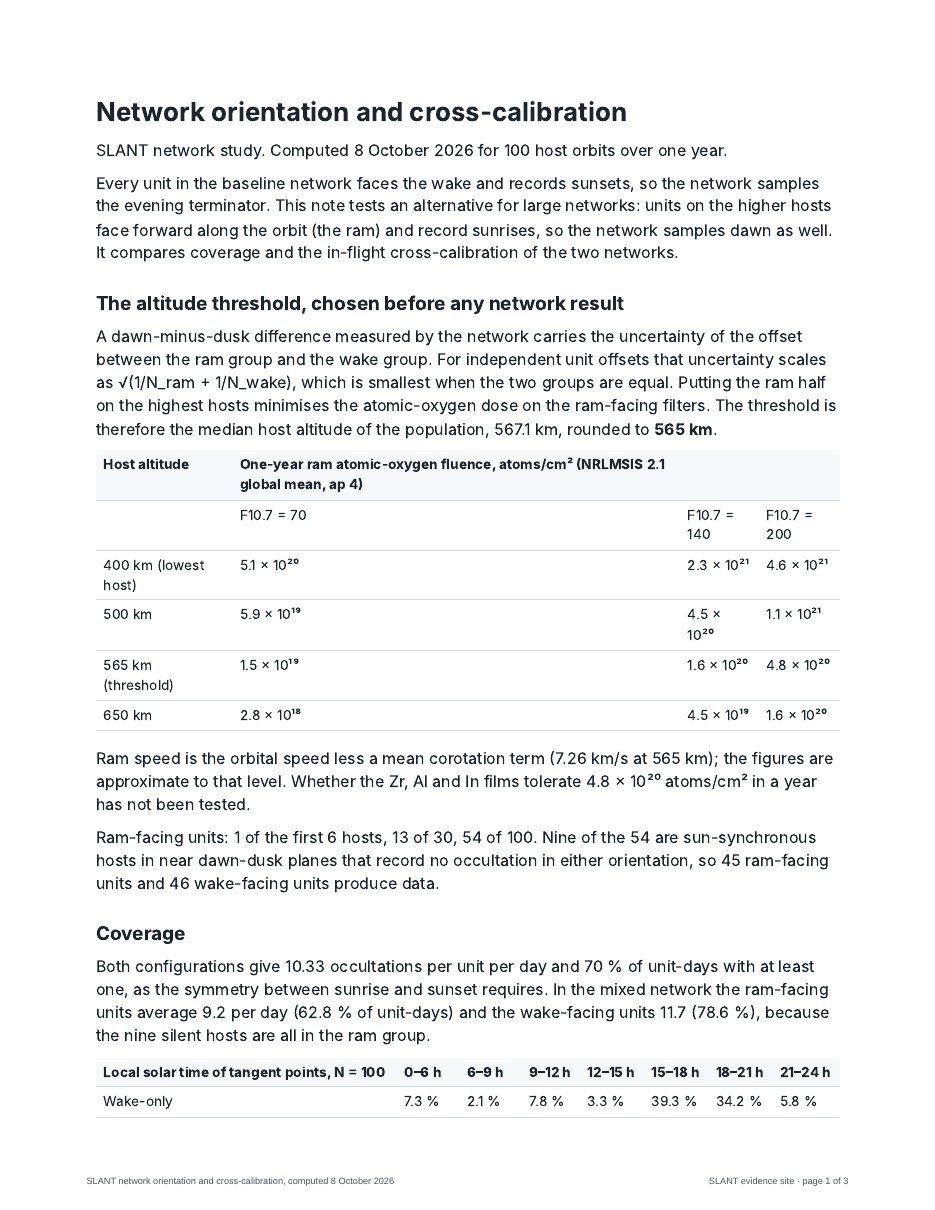
prev/C_NET.jpg
