carthage-space-sciences/slant/prev/C_RATE.jpg

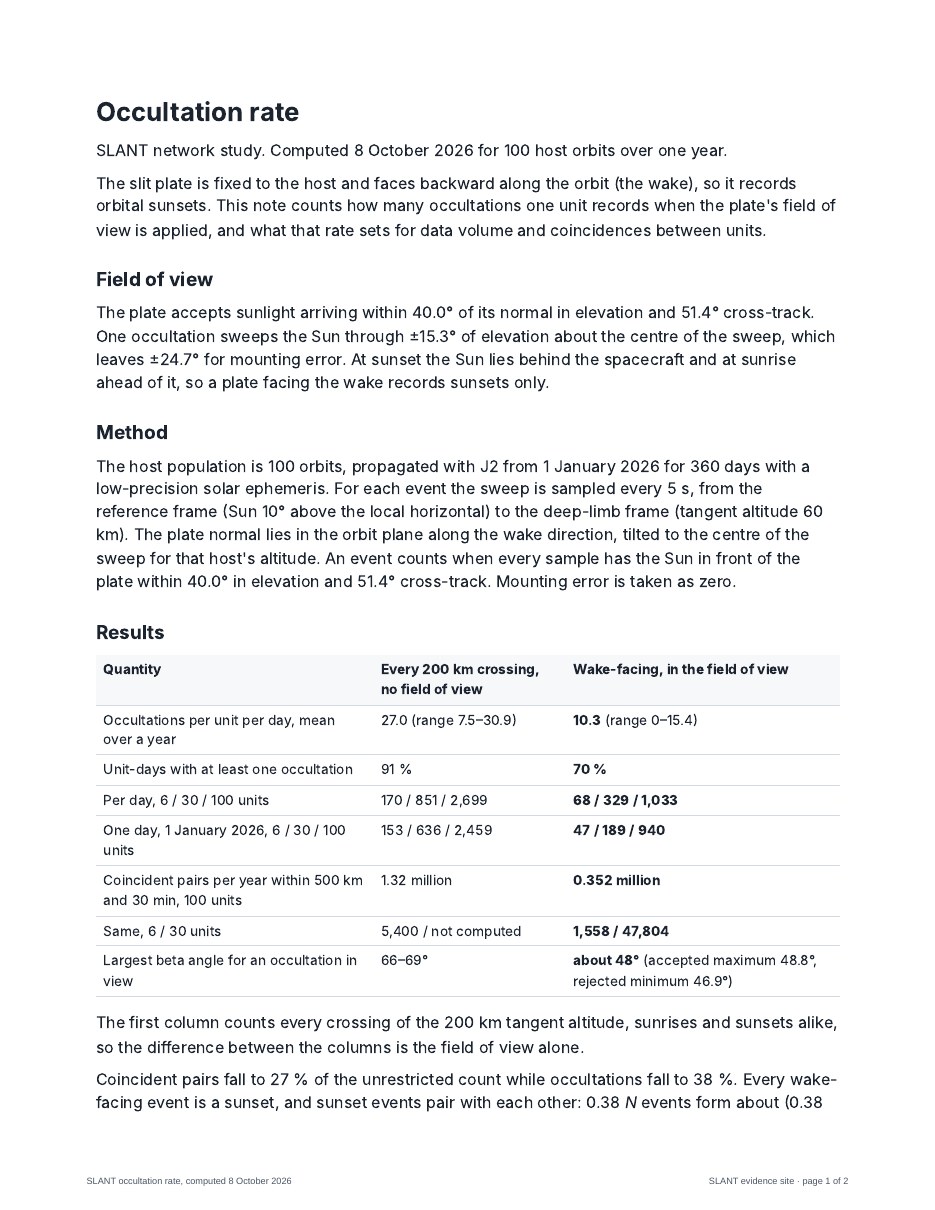
prev/C_RATE.jpg
