carthage-space-sciences/slant/prev/D_3D.jpg

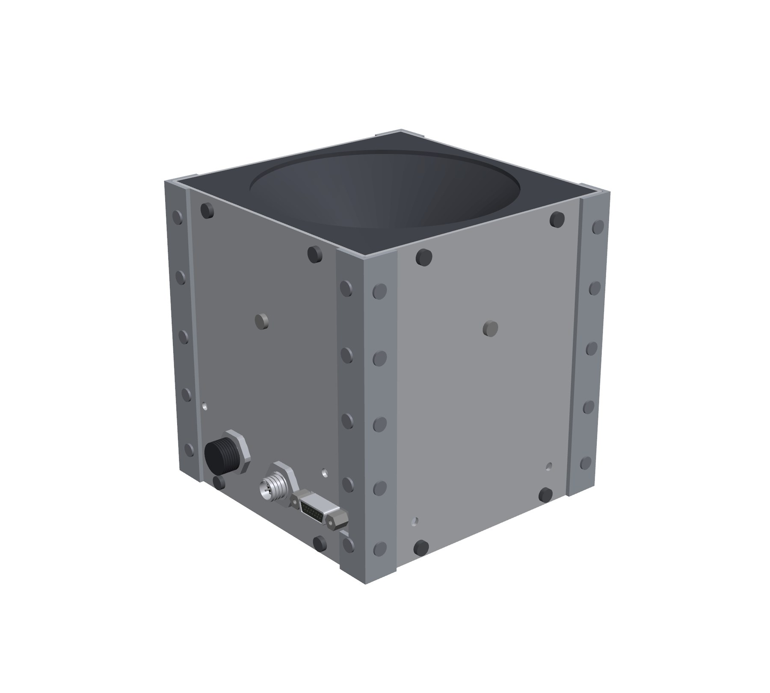
prev/D_3D.jpg
