carthage-space-sciences/slant/prev/D_ASM.jpg

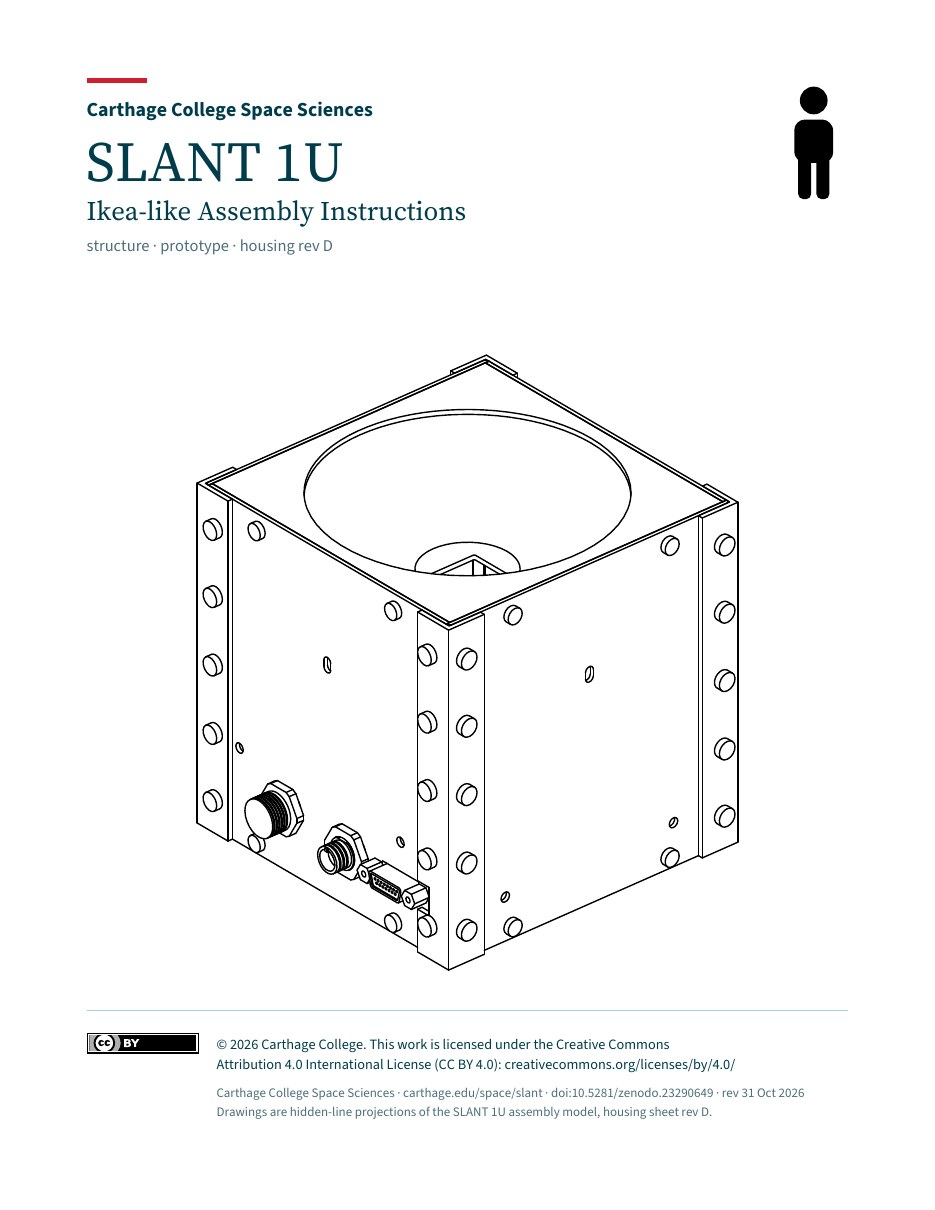
prev/D_ASM.jpg
