carthage-space-sciences/slant/prev/D_H01.jpg

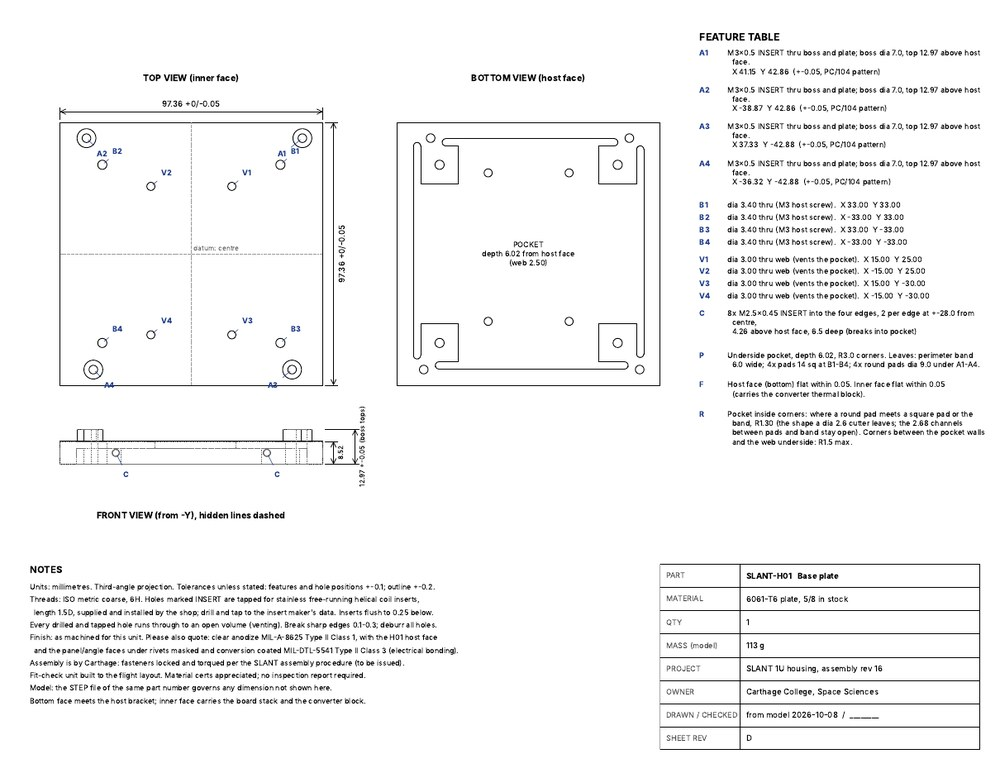
prev/D_H01.jpg
