carthage-space-sciences/slant/prev/D_H02.jpg

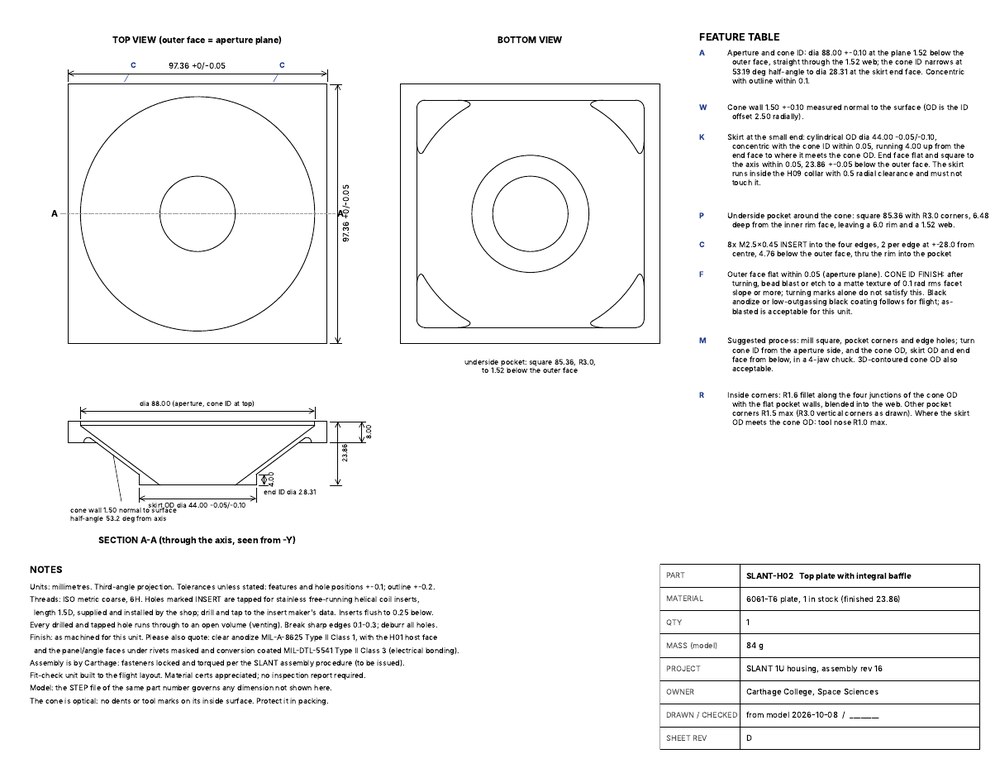
prev/D_H02.jpg
