carthage-space-sciences/slant/prev/D_H03.jpg

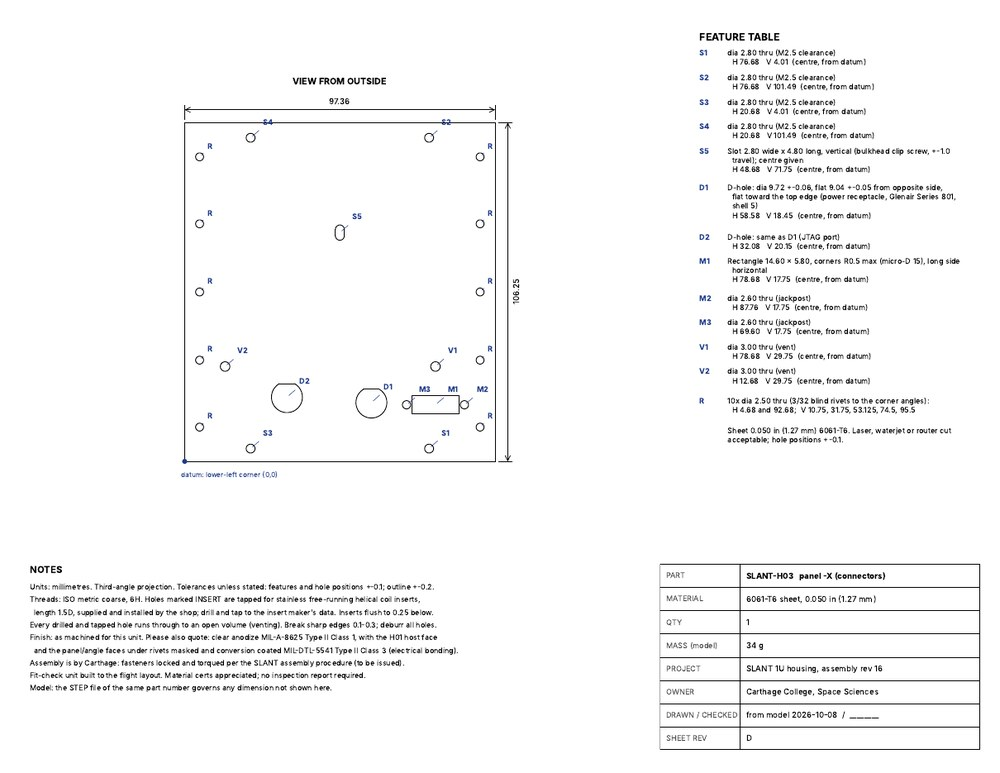
prev/D_H03.jpg
