carthage-space-sciences/slant/prev/D_H04.jpg

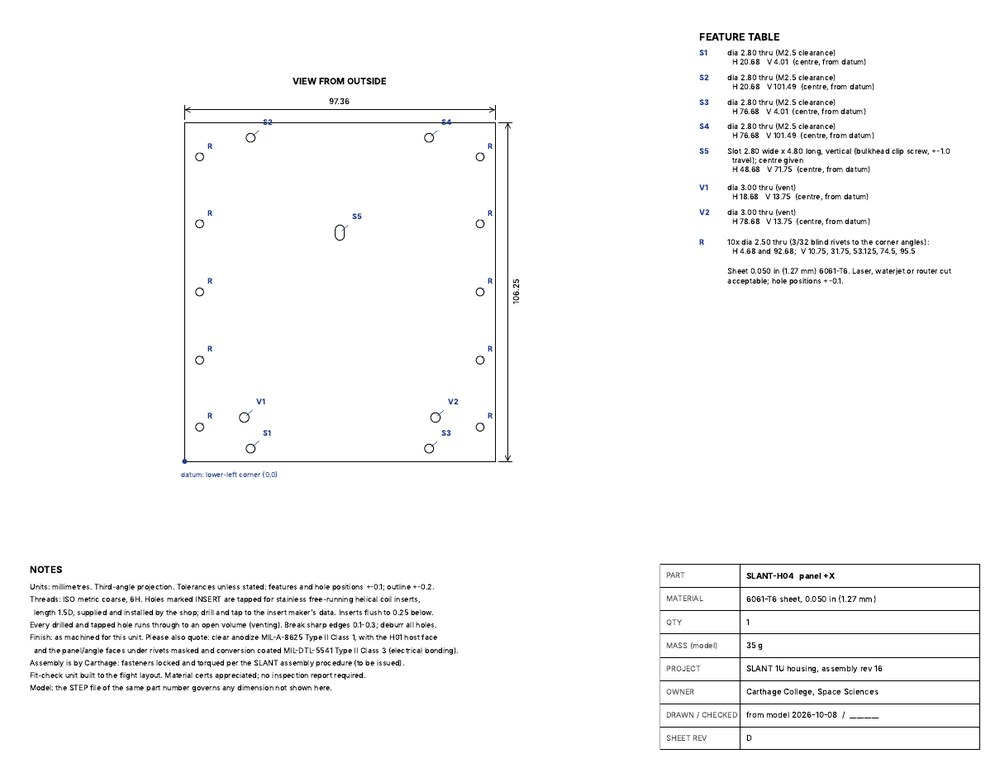
prev/D_H04.jpg
