carthage-space-sciences/slant/prev/D_H07.jpg

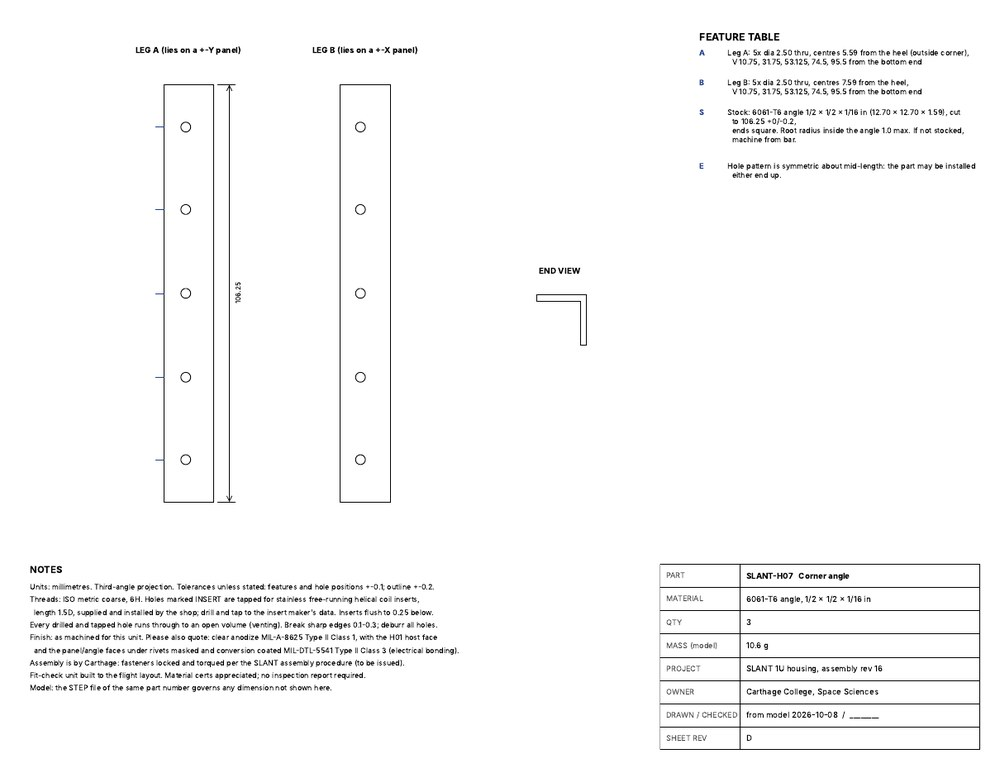
prev/D_H07.jpg
