carthage-space-sciences/slant/prev/D_H09.jpg

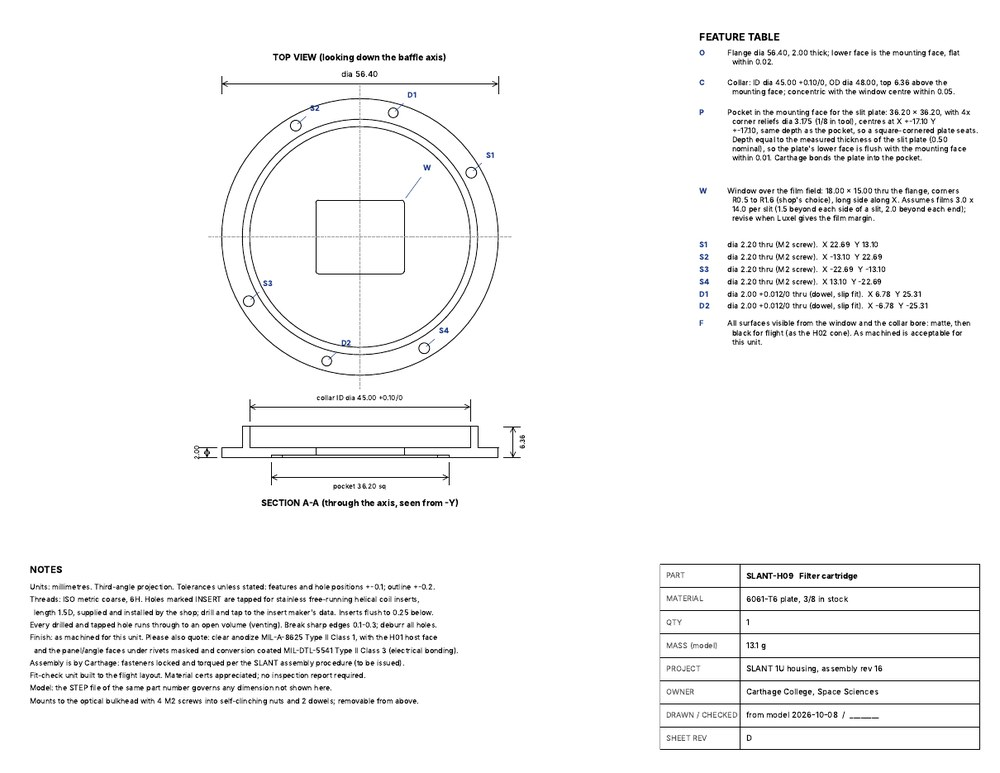
prev/D_H09.jpg
