carthage-space-sciences/slant/prev/D_P1.jpg

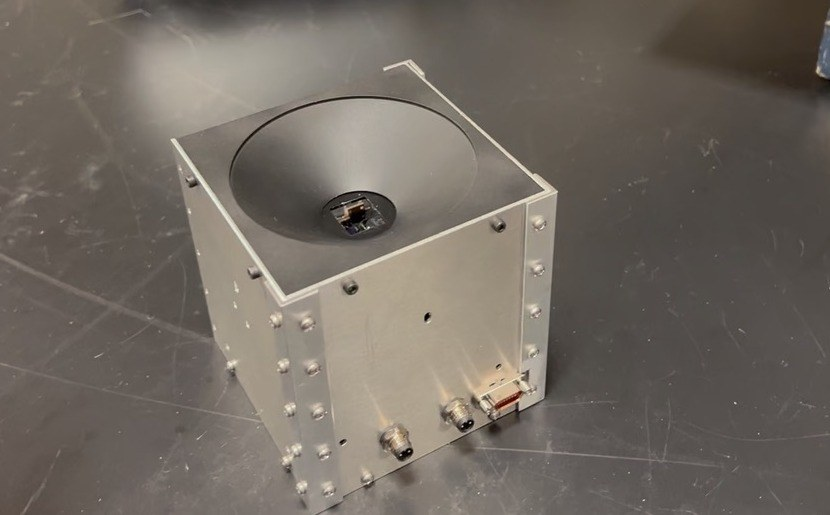
prev/D_P1.jpg
