carthage-space-sciences/slant/prev/D_P2.jpg

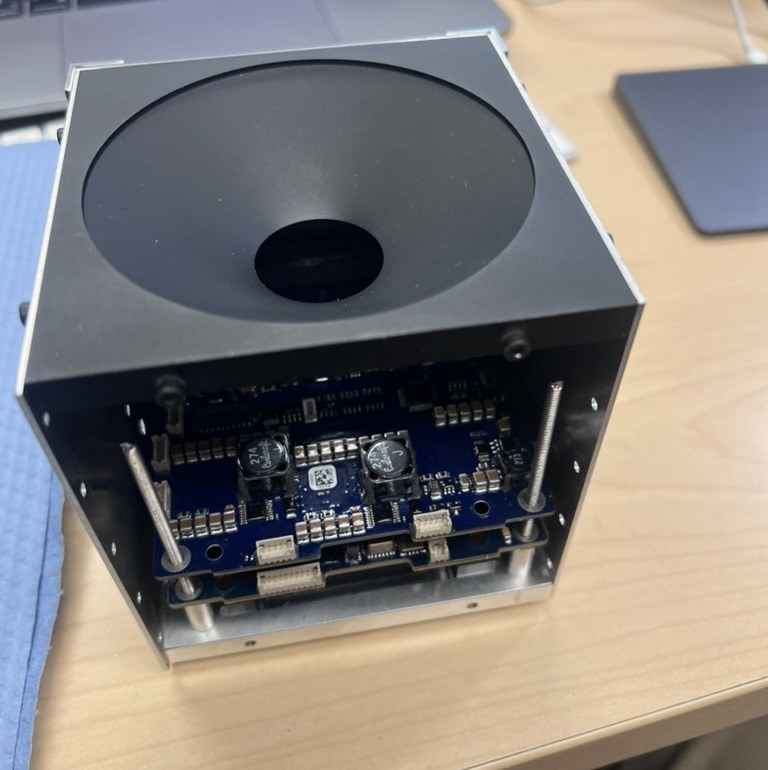
prev/D_P2.jpg
