carthage-space-sciences/slant/prev/D_P3.jpg

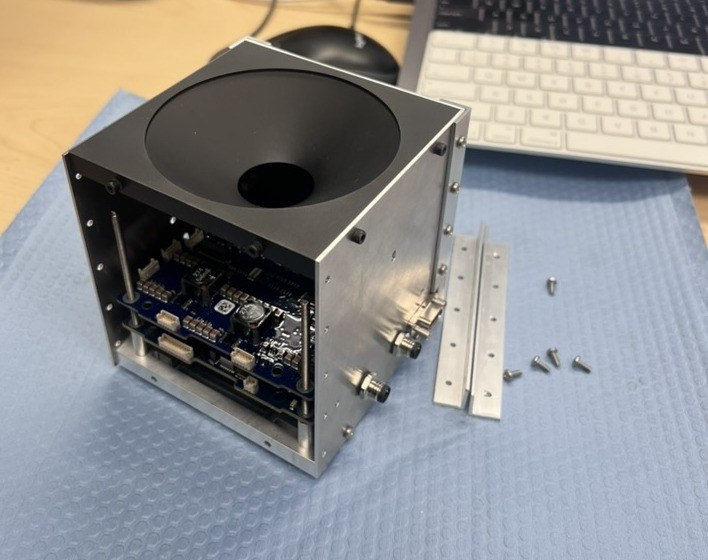
prev/D_P3.jpg
