carthage-space-sciences/slant/prev/D_R2.jpg

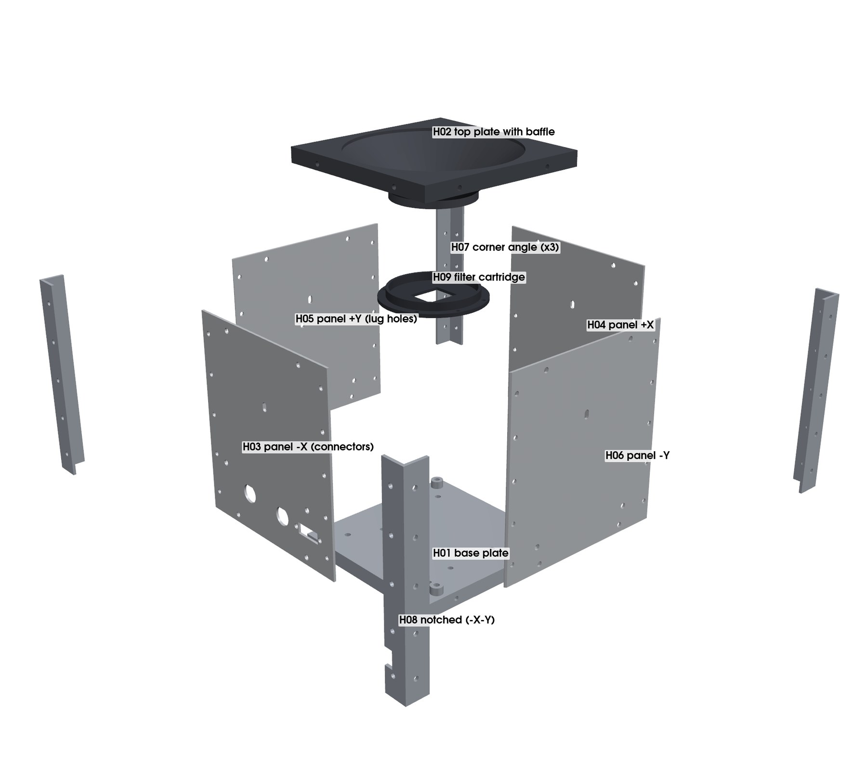
prev/D_R2.jpg
