carthage-space-sciences/slant/prev/D_R3.jpg

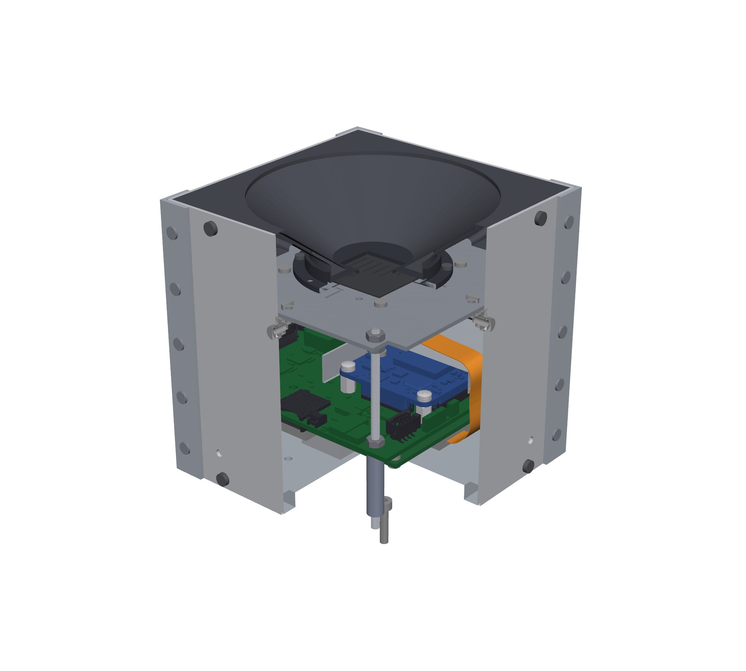
prev/D_R3.jpg
