carthage-space-sciences/slant/prev/D_SP2.jpg

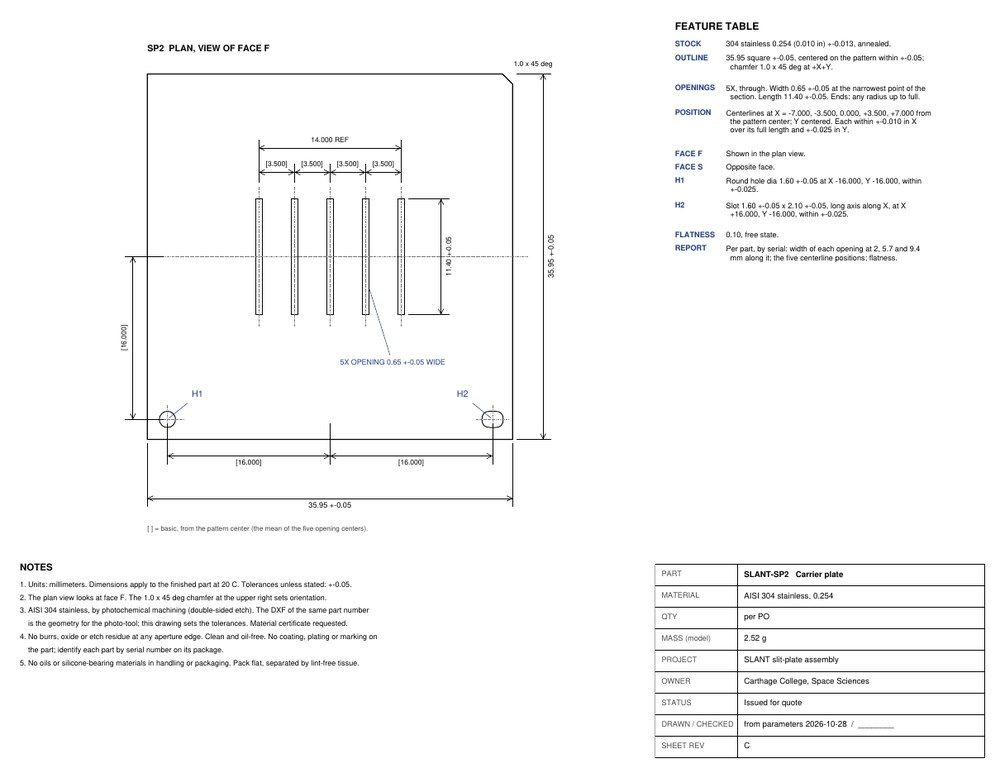
prev/D_SP2.jpg
