carthage-space-sciences/slant/prev/D_SP.jpg

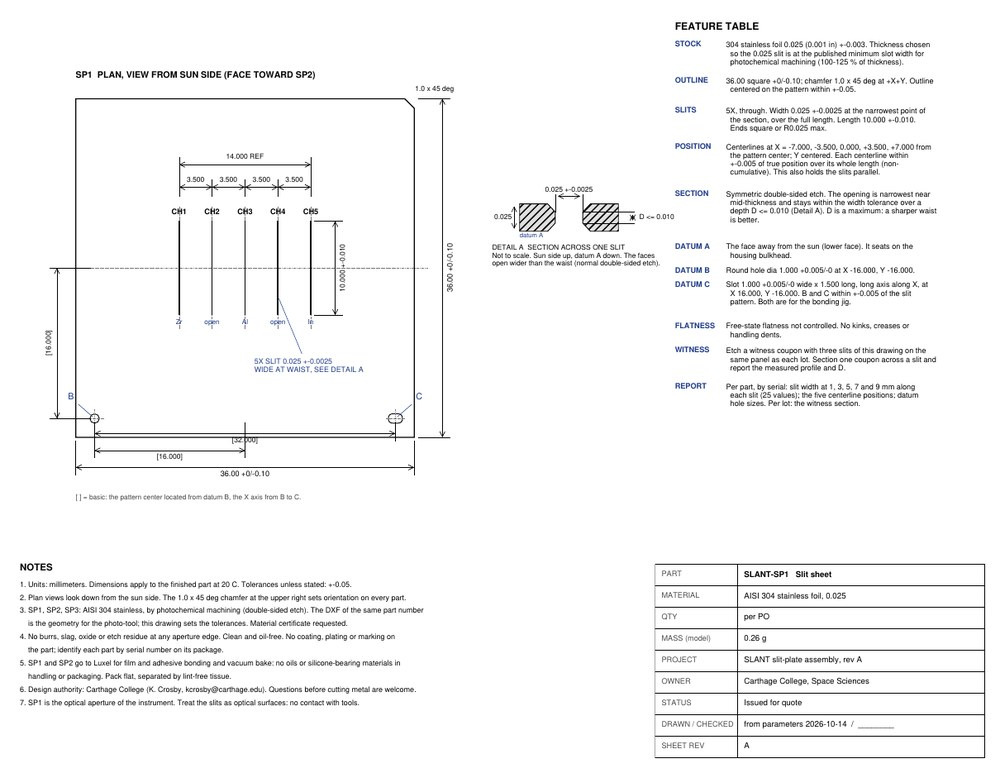
prev/D_SP.jpg
