carthage-space-sciences/slant/prev/D_TT.jpg

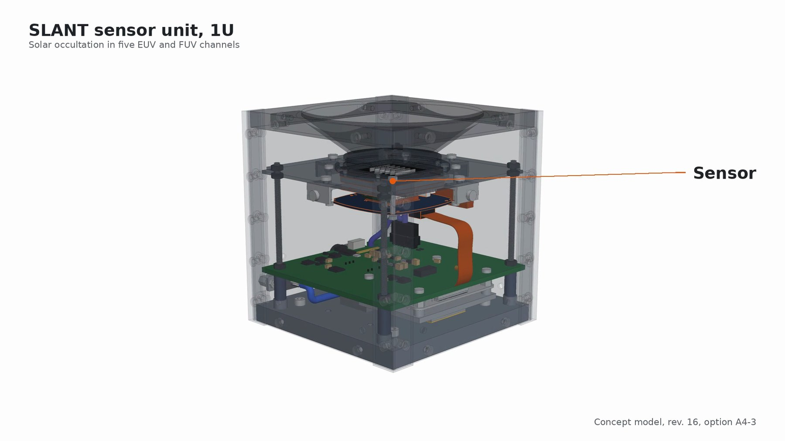
prev/D_TT.jpg
