carthage-space-sciences/slant/prev/H_CANOP.jpg

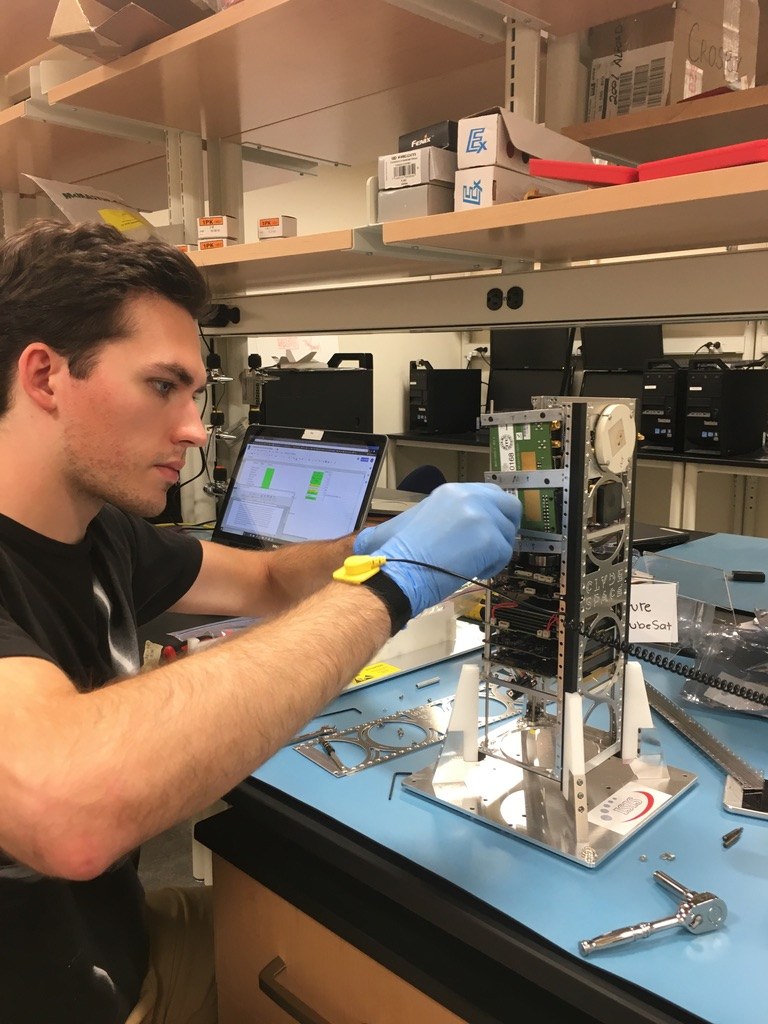
prev/H_CANOP.jpg
