carthage-space-sciences/slant/prev/H_MUTT.jpg

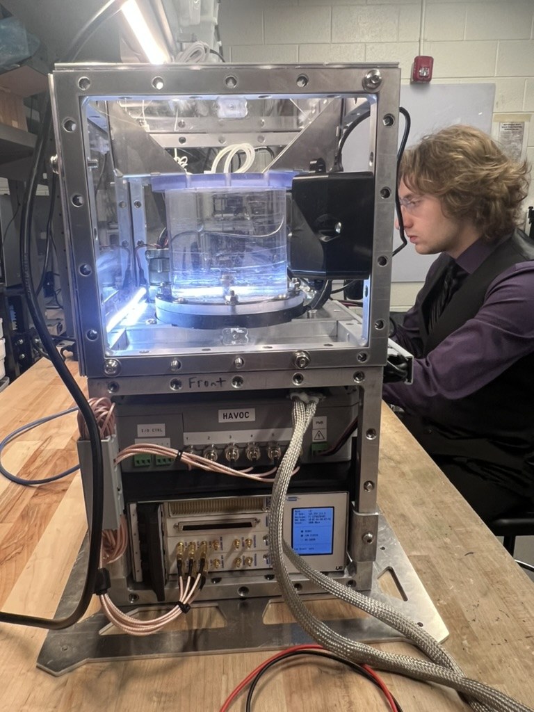
prev/H_MUTT.jpg
