carthage-space-sciences/slant/prev/H_UPI.jpg

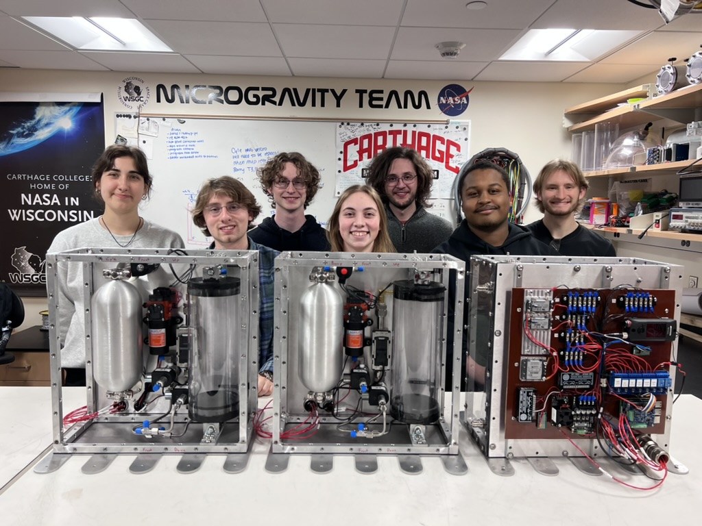
prev/H_UPI.jpg
