carthage-space-sciences/slant/prev/M01.jpg

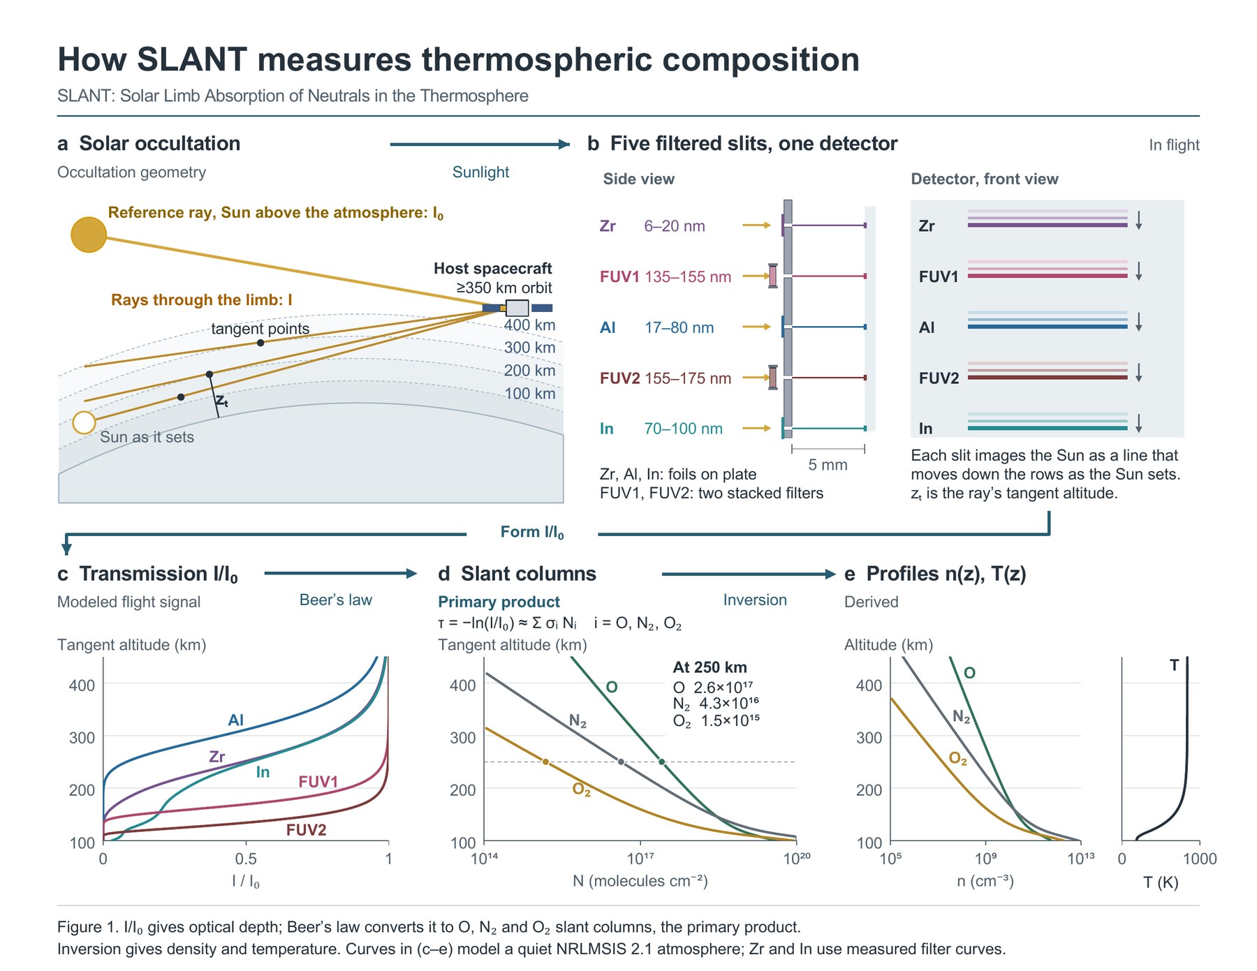
prev/M01.jpg
