carthage-space-sciences/slant/prev/M02.jpg

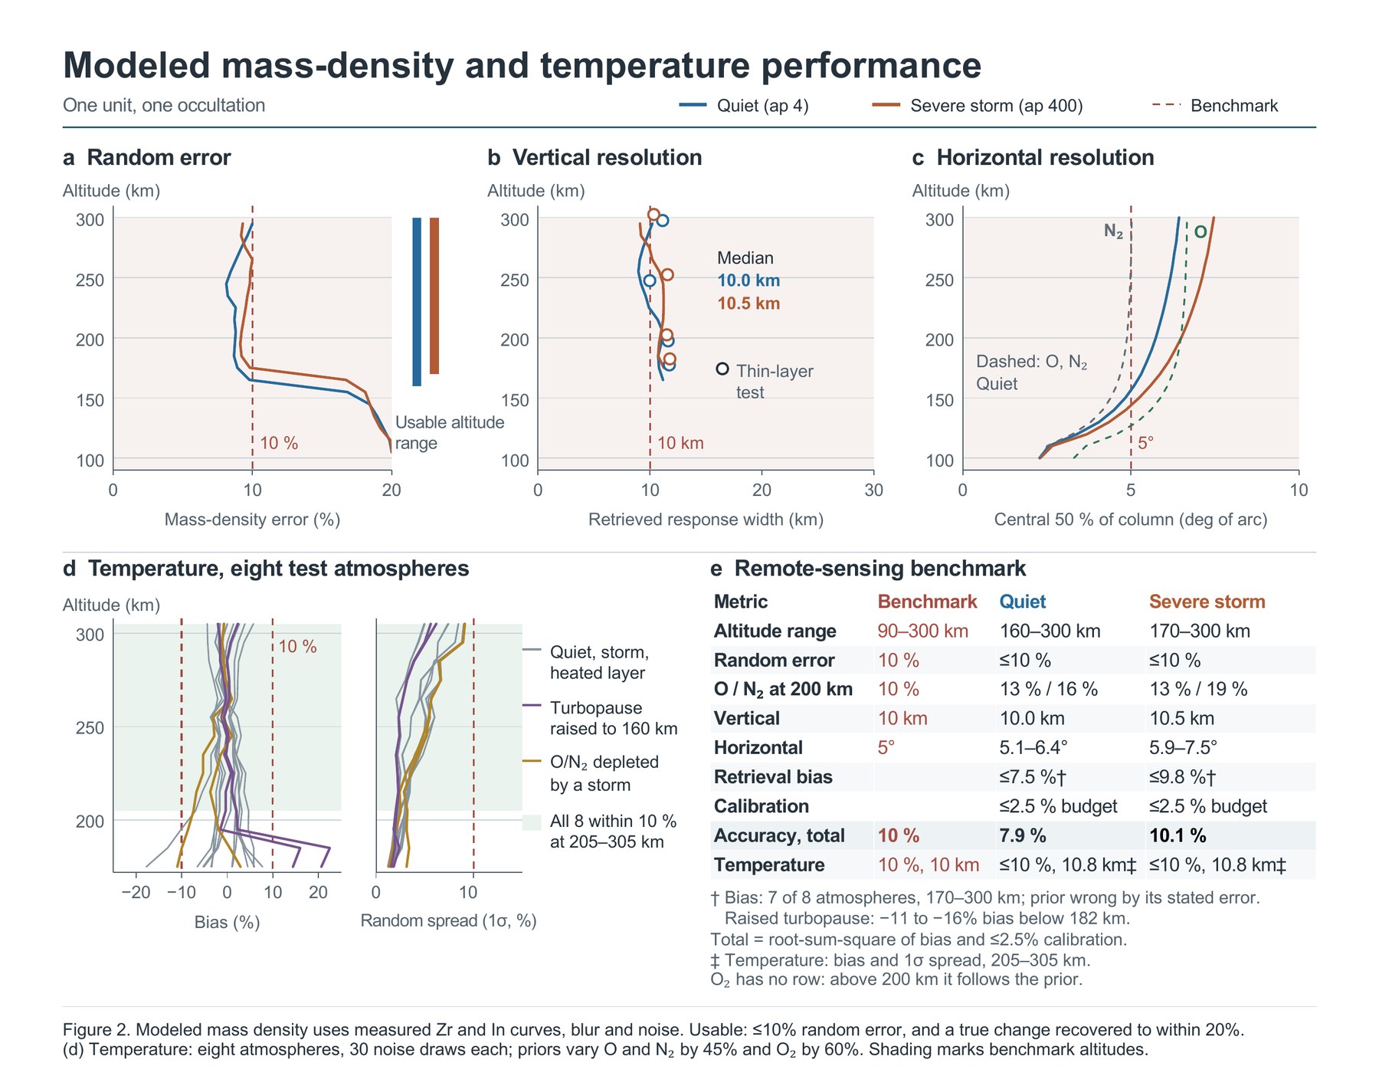
prev/M02.jpg
