carthage-space-sciences/slant/prev/M03.jpg

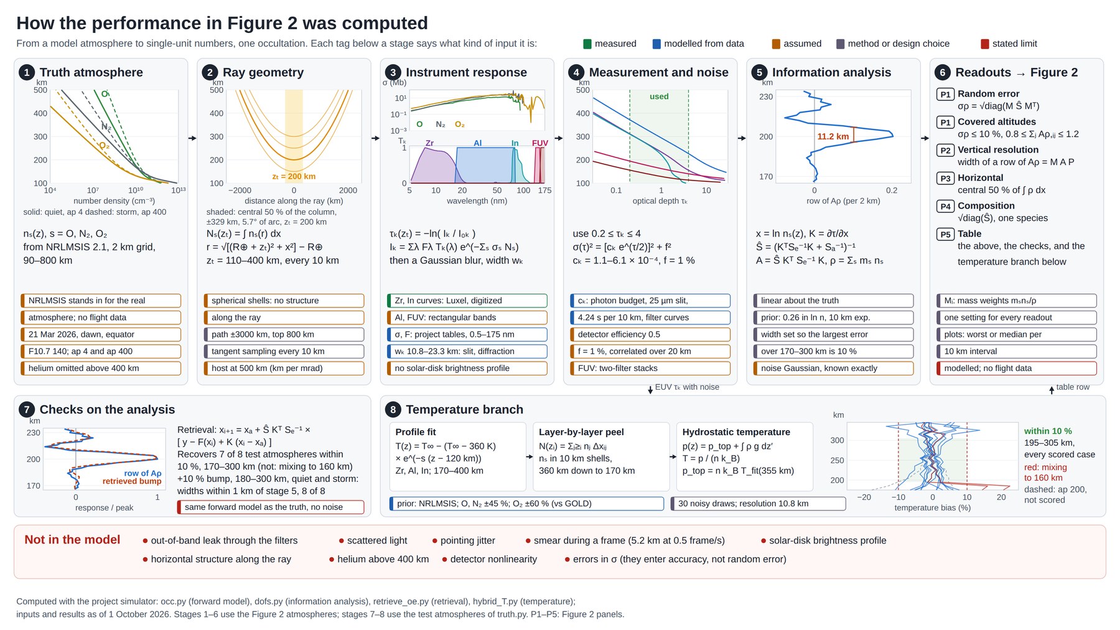
prev/M03.jpg
