carthage-space-sciences/slant/prev/M05.jpg

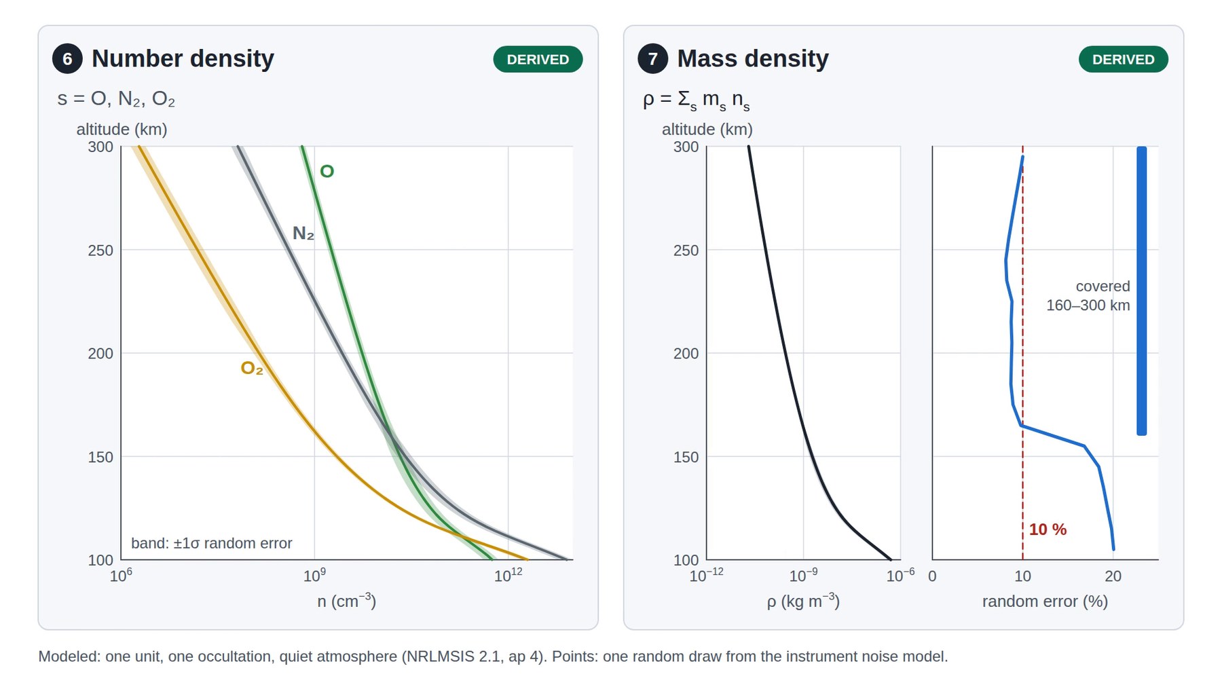
prev/M05.jpg
