carthage-space-sciences/slant/prev/M06.jpg

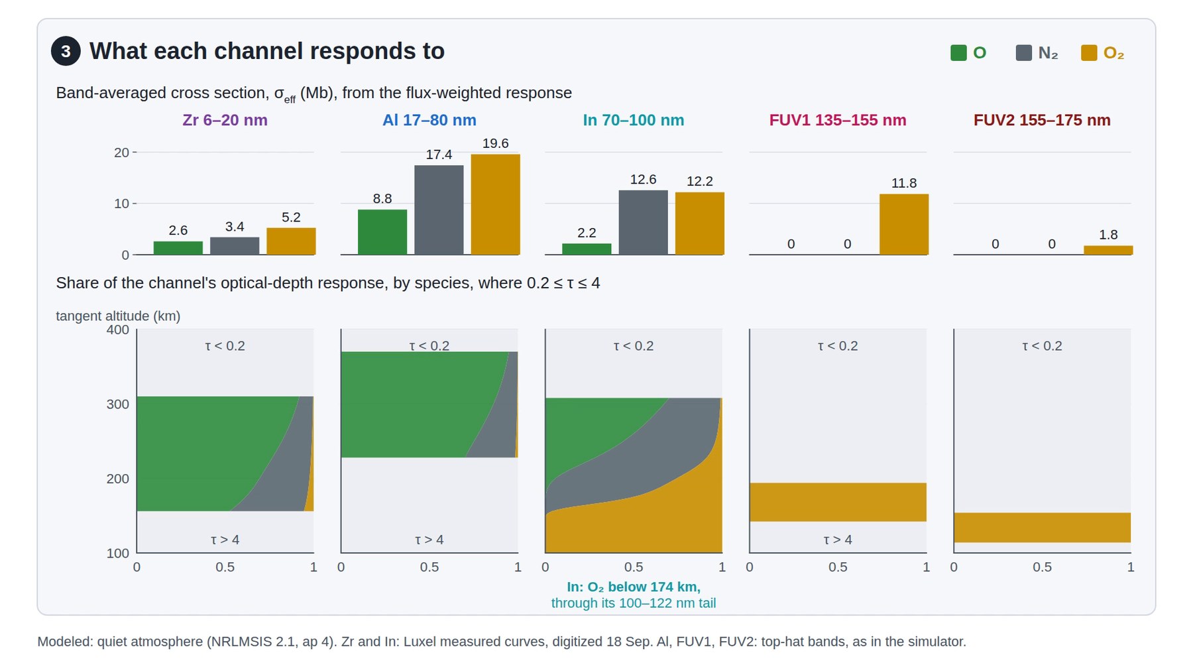
prev/M06.jpg
