carthage-space-sciences/slant/prev/S_p3.jpg

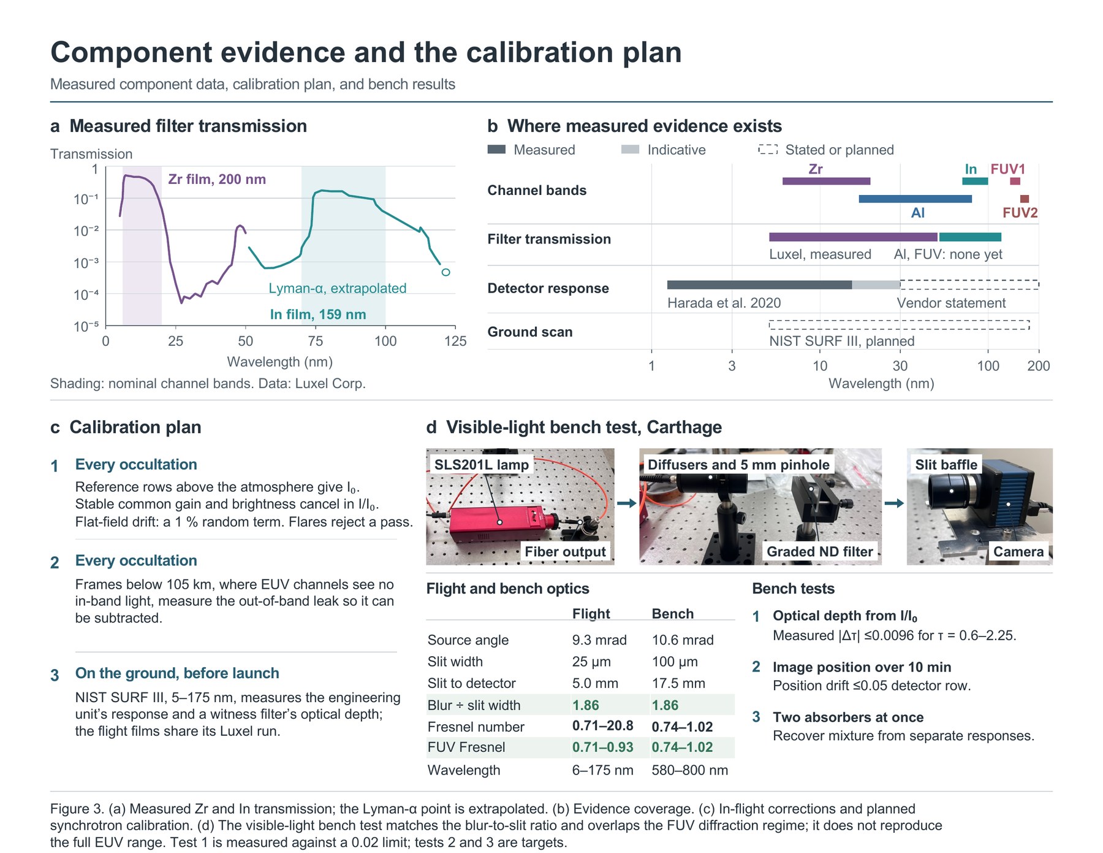
prev/S_p3.jpg
