carthage-space-sciences/slant/prev/S_p4.jpg

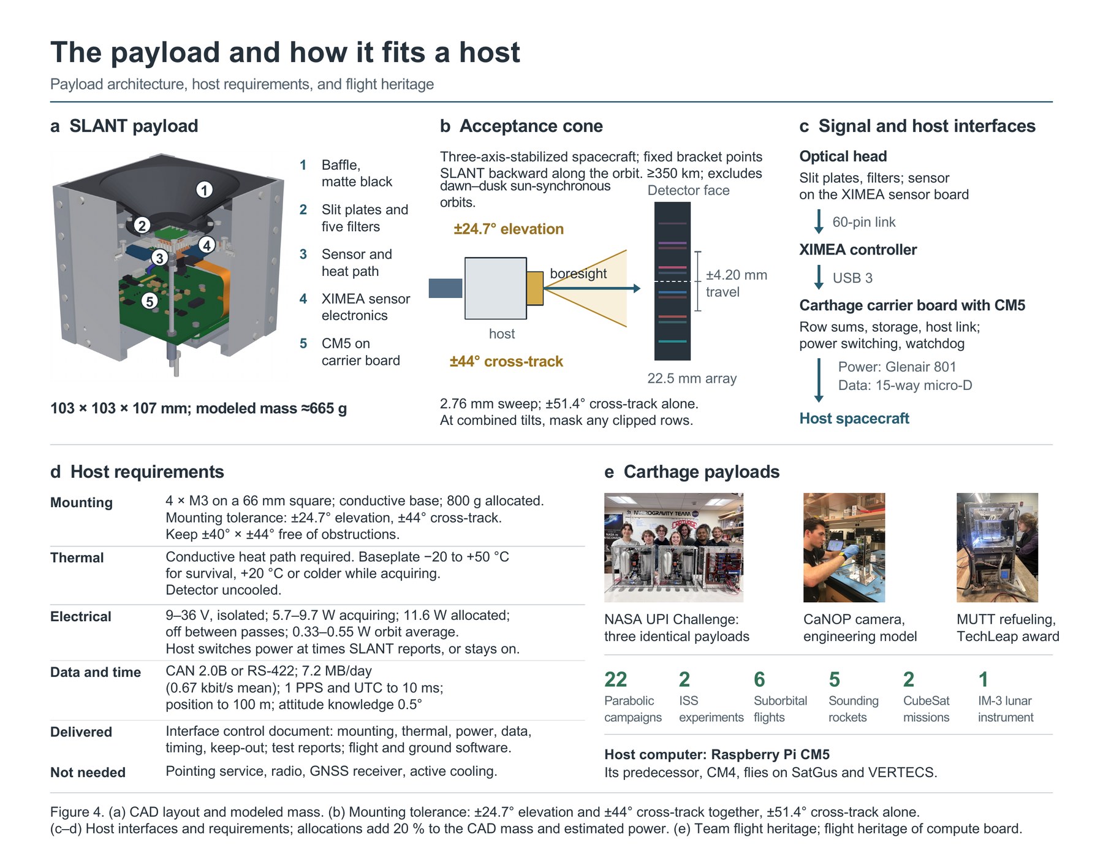
prev/S_p4.jpg
