carthage-space-sciences/slant/prev/S_p5.jpg

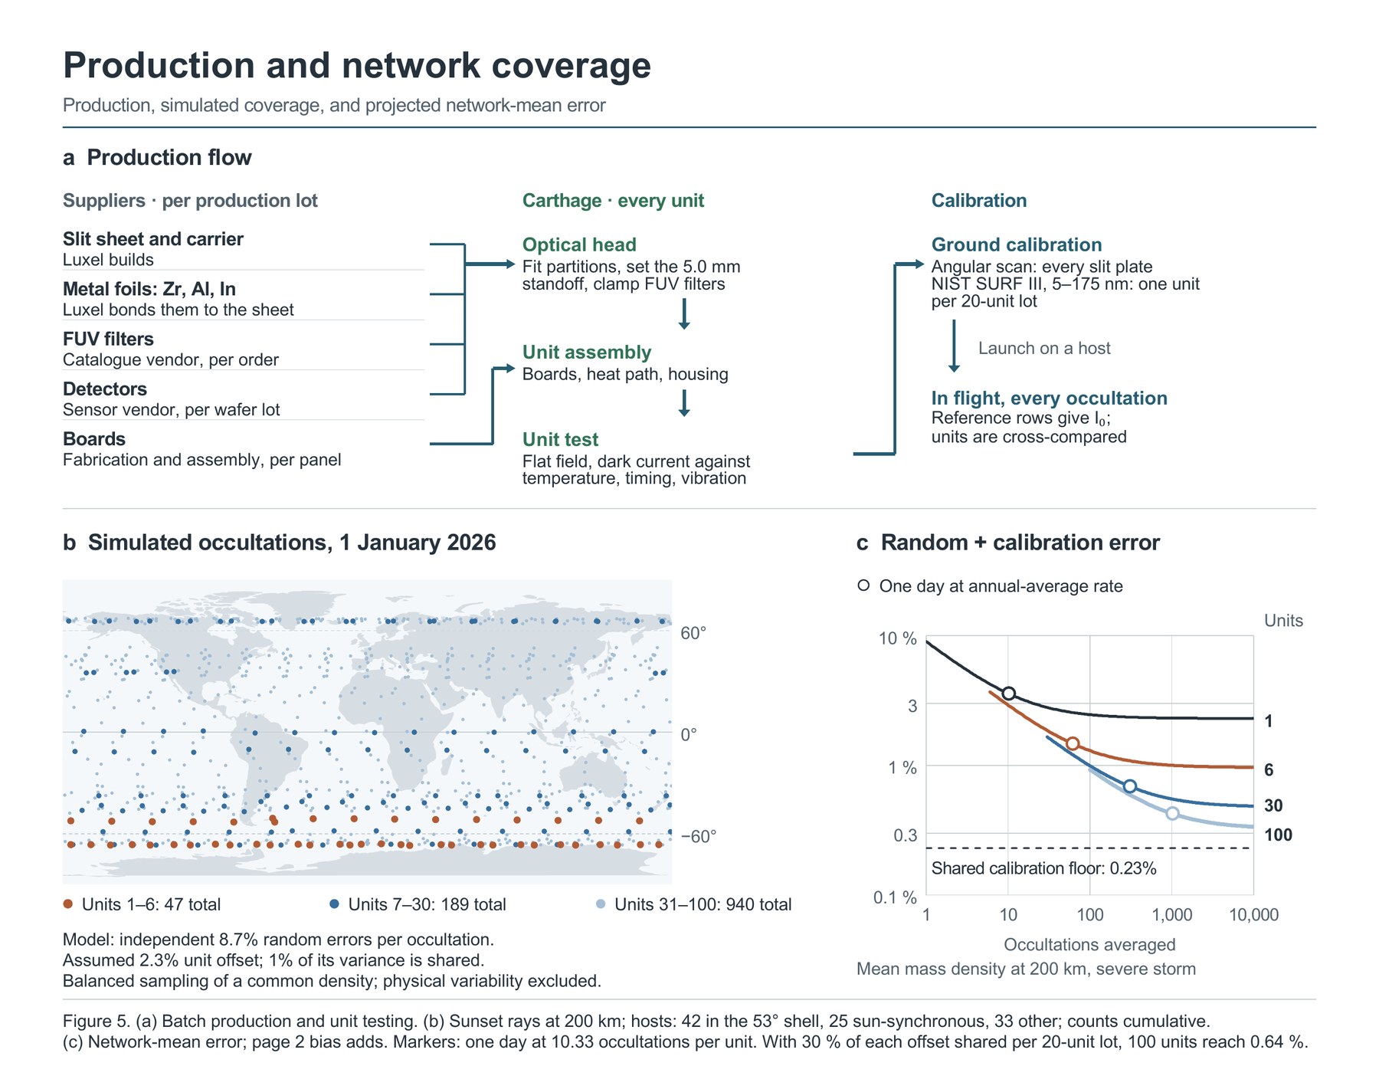
prev/S_p5.jpg
