carthage-space-sciences/slant/prev/T_PHOTO.jpg

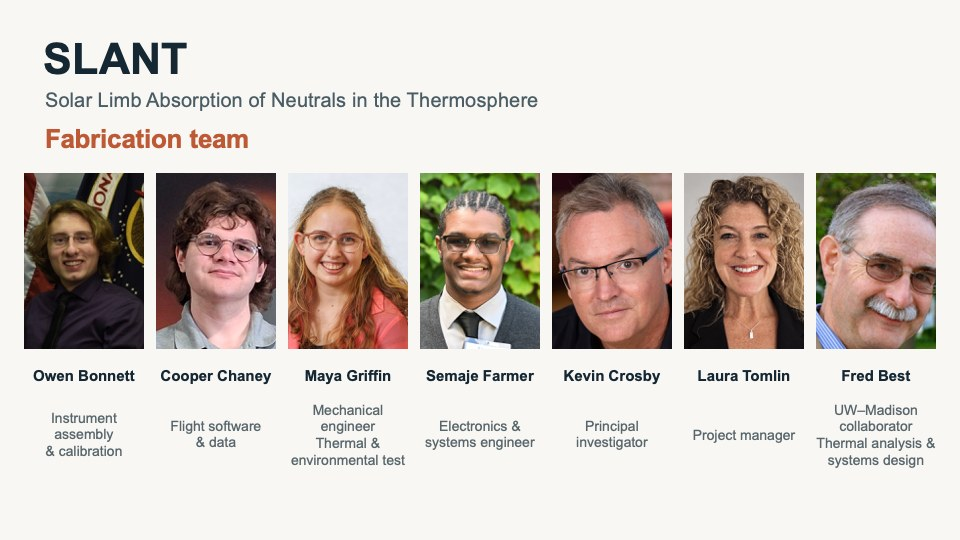
prev/T_PHOTO.jpg
