carthage-space-sciences/slant/prev/T_u01.jpg

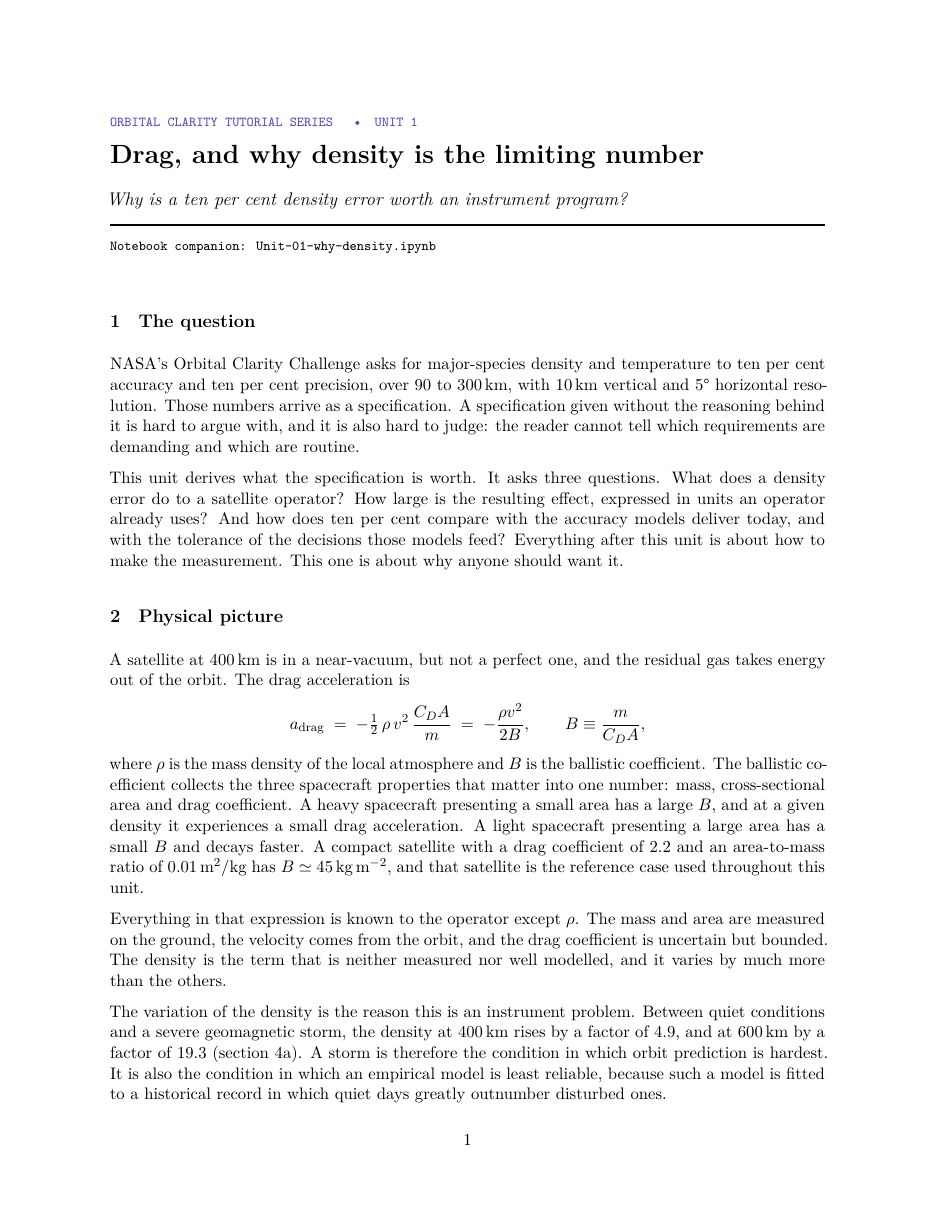
prev/T_u01.jpg
