carthage-space-sciences/slant/prev/T_u02.jpg

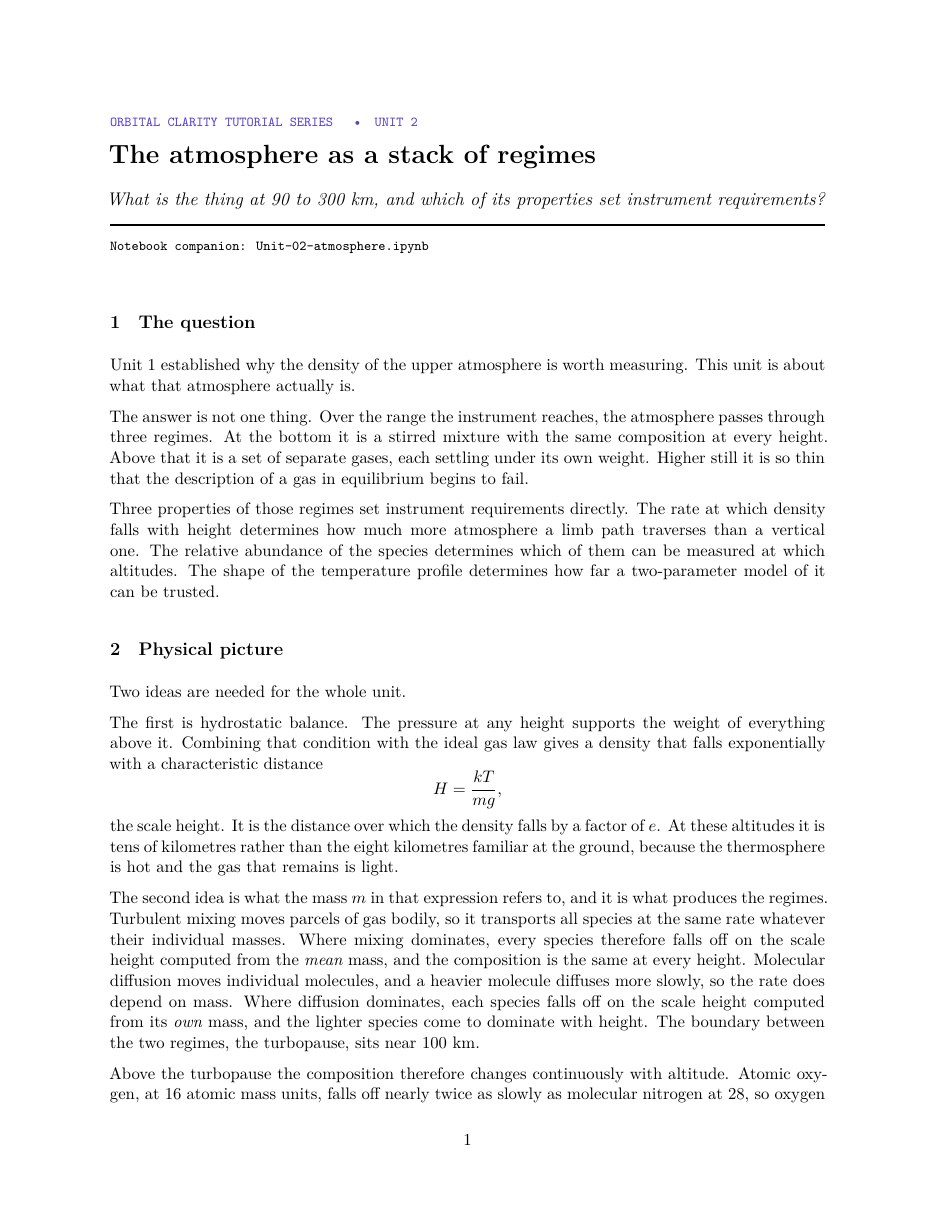
prev/T_u02.jpg
