carthage-space-sciences/slant/prev/T_u03.jpg

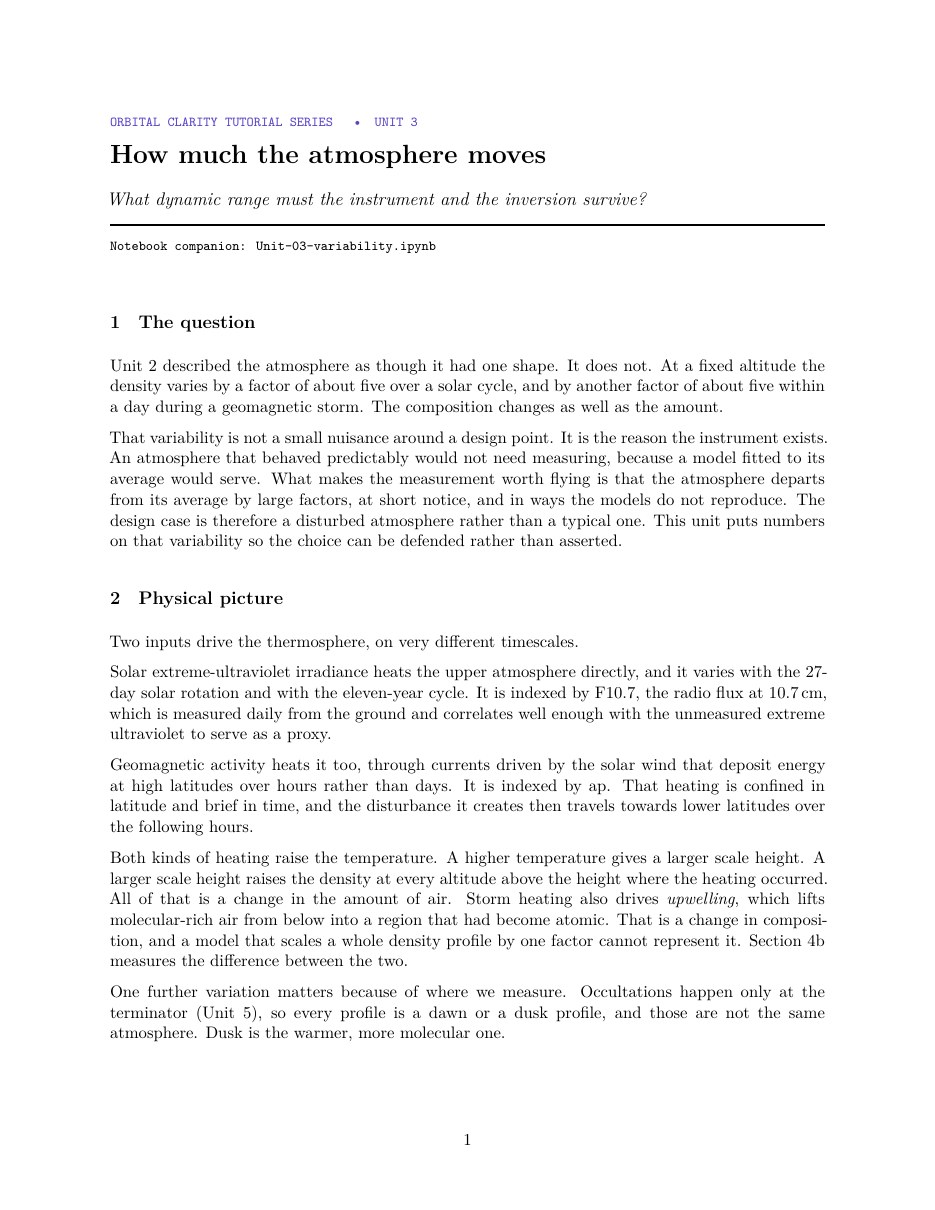
prev/T_u03.jpg
