carthage-space-sciences/slant/prev/T_u04.jpg

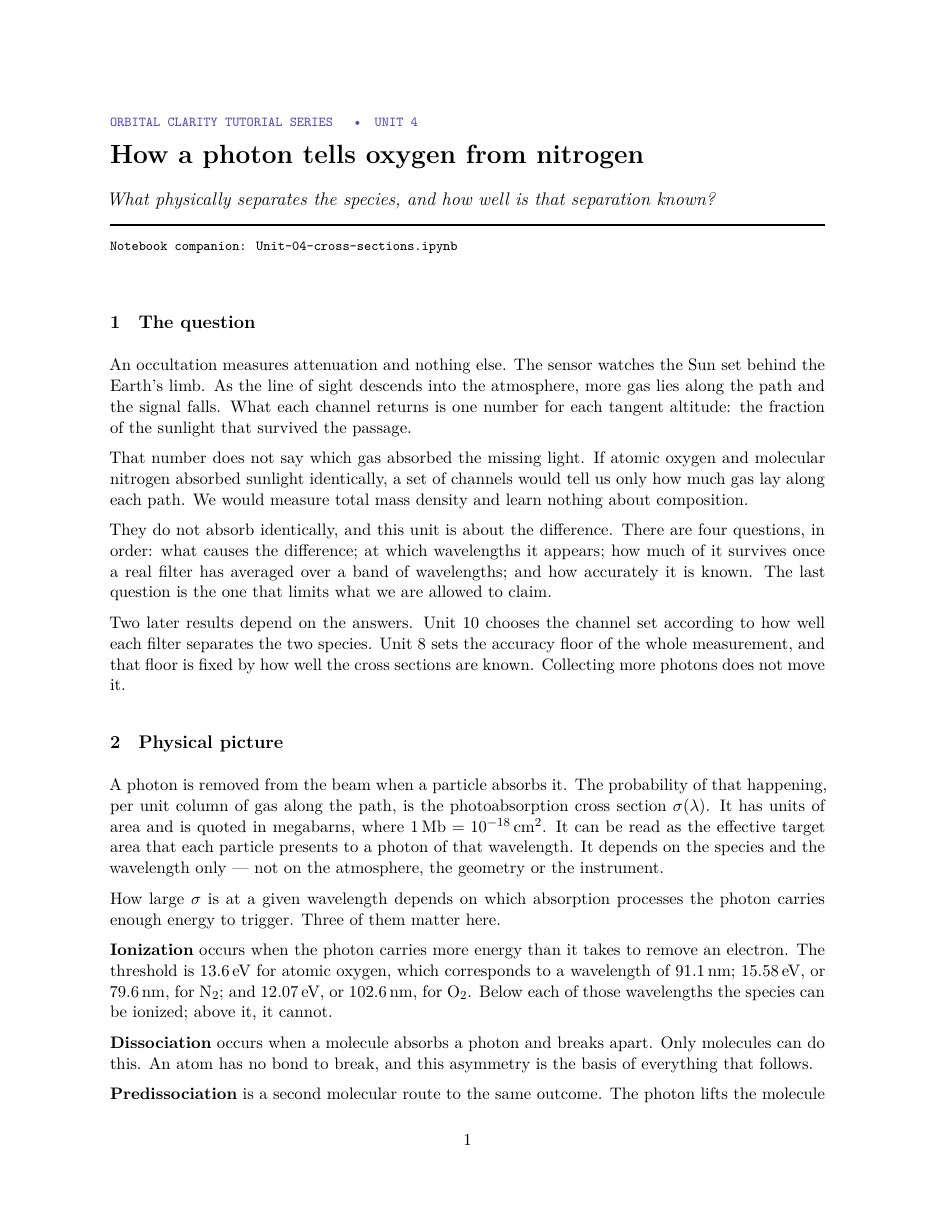
prev/T_u04.jpg
