carthage-space-sciences/slant/prev/T_u05.jpg

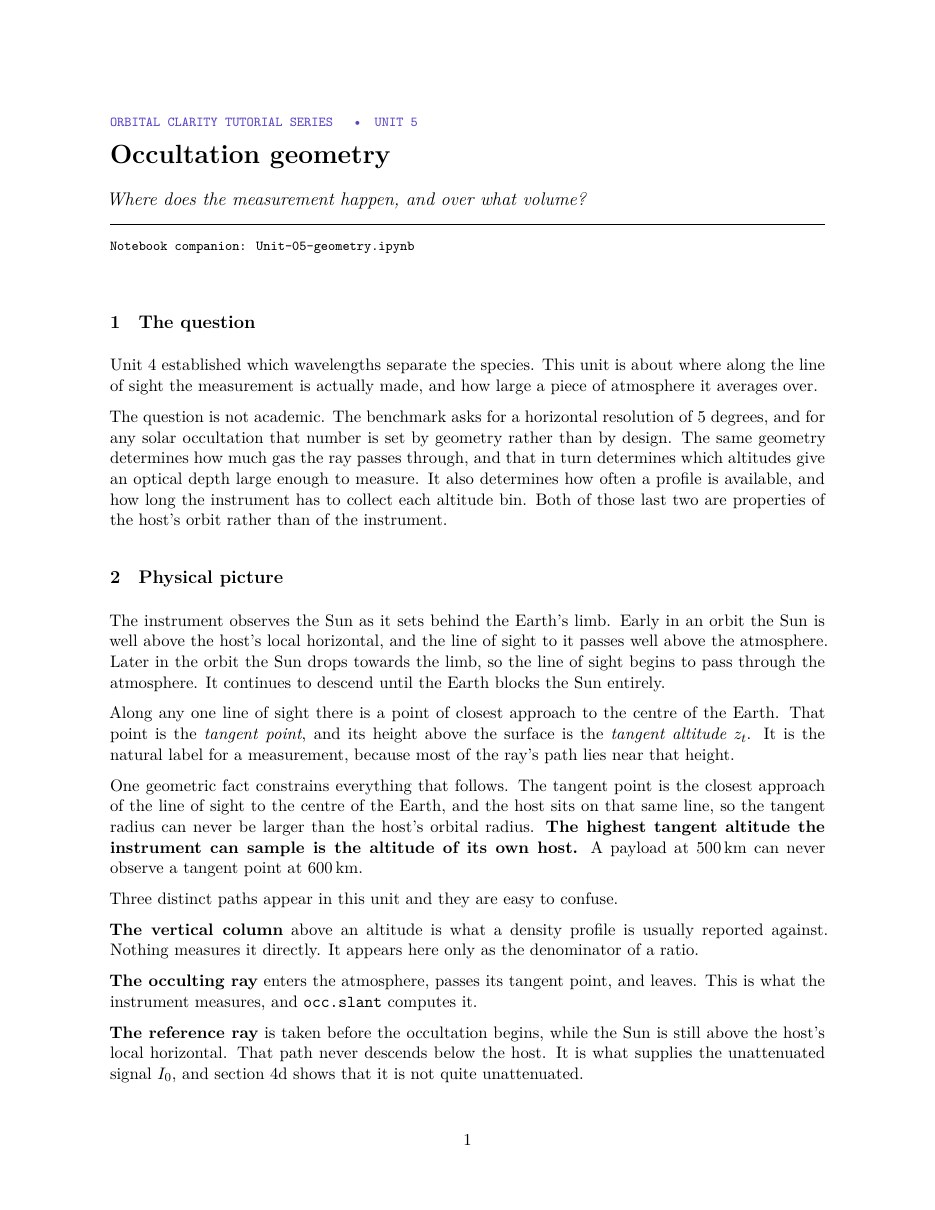
prev/T_u05.jpg
