carthage-space-sciences/slant/prev/T_u06.jpg

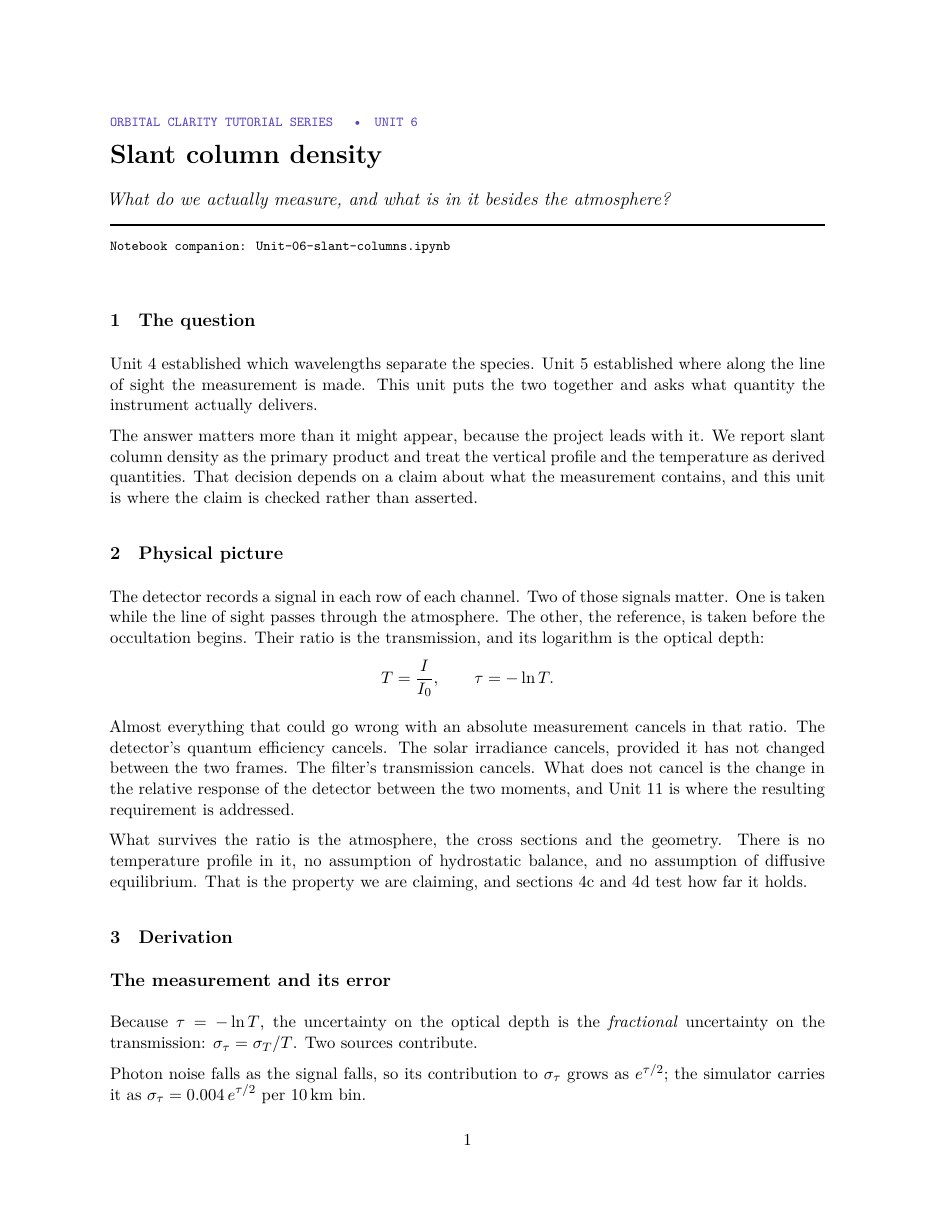
prev/T_u06.jpg
