carthage-space-sciences/slant/prev/T_u07.jpg

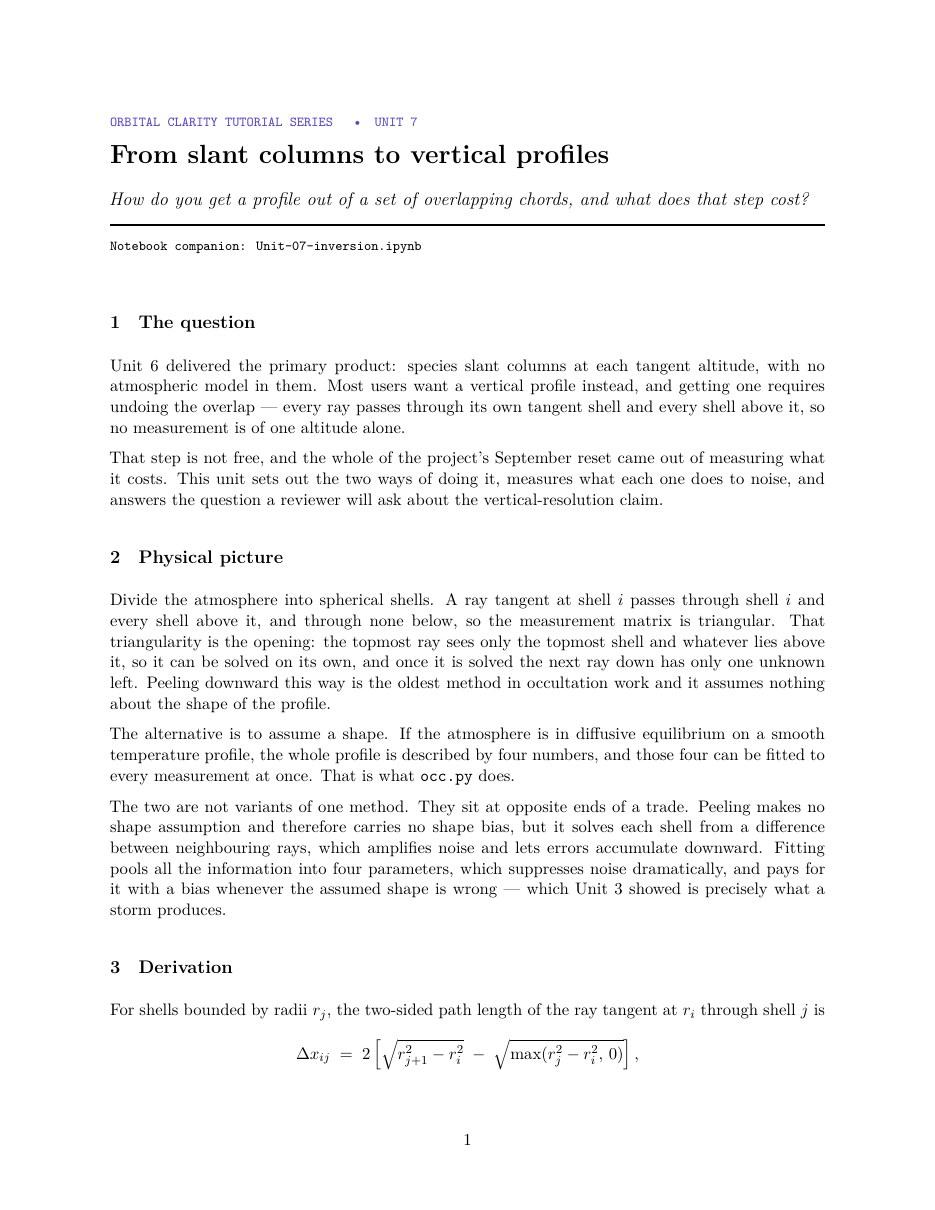
prev/T_u07.jpg
