carthage-space-sciences/slant/prev/T_u08.jpg

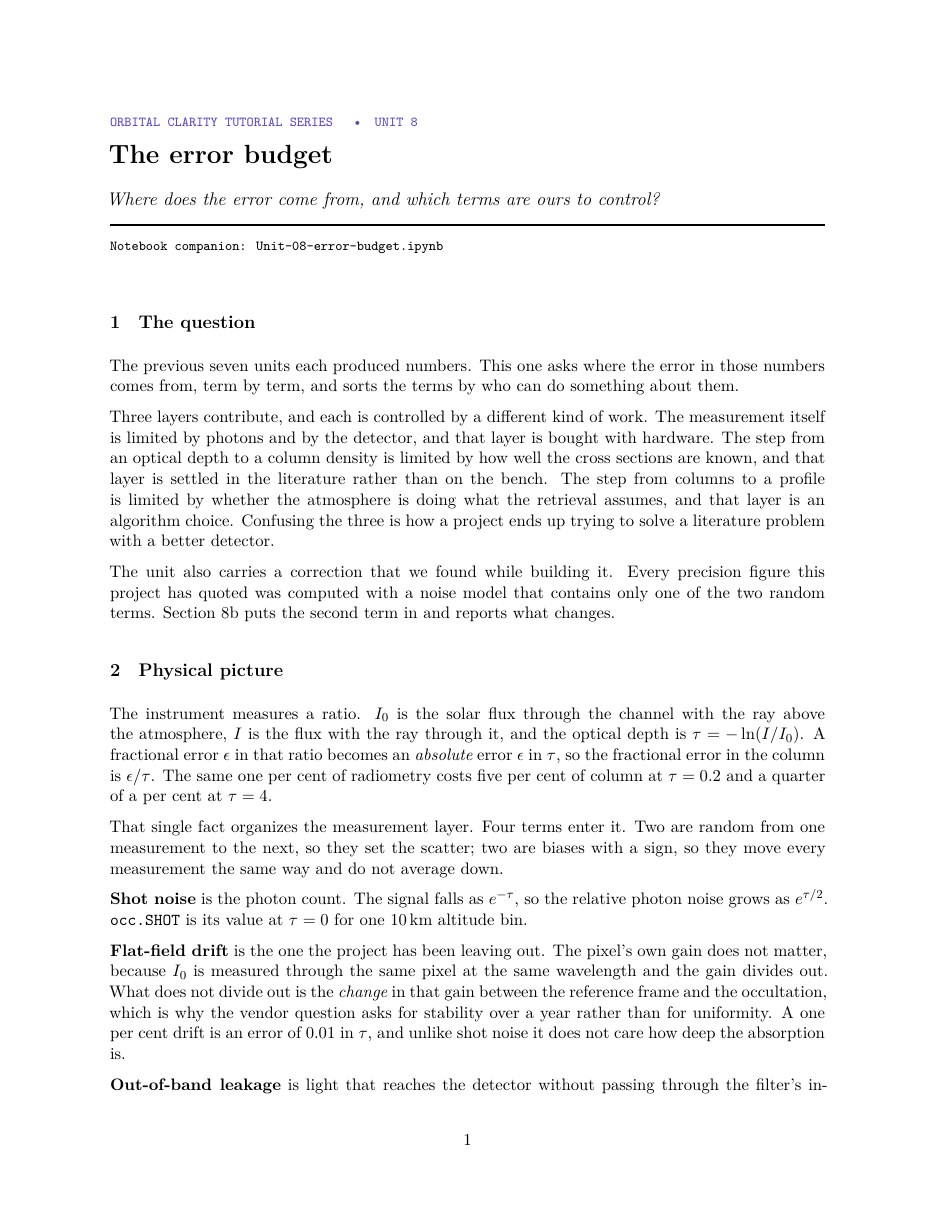
prev/T_u08.jpg
