carthage-space-sciences/slant/prev/T_u10.jpg

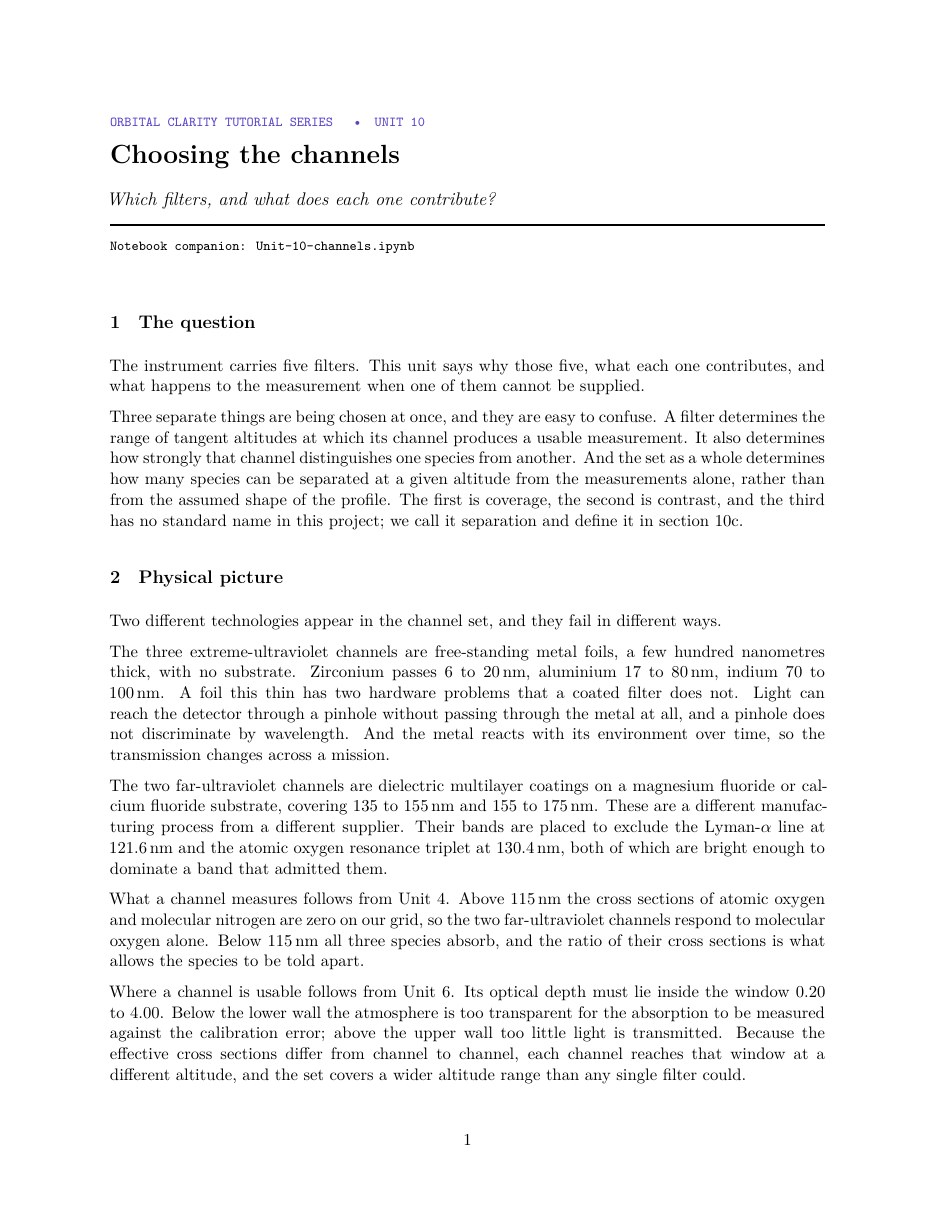
prev/T_u10.jpg
