carthage-space-sciences/slant/files/D_SP/SLANT-SPA-assembly-revA.step

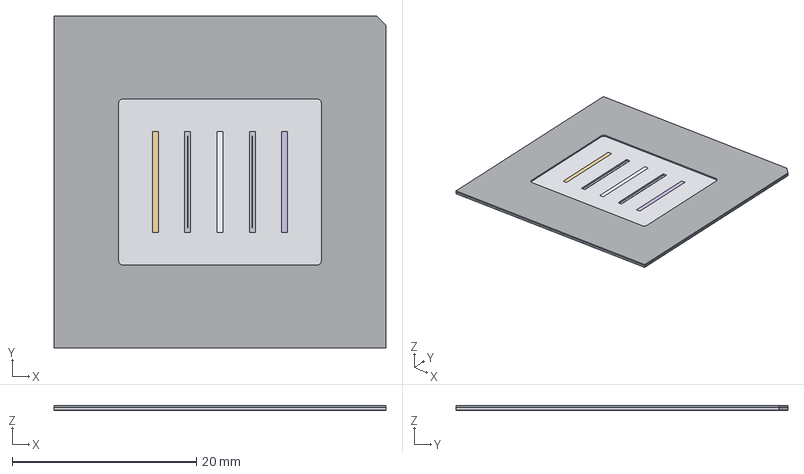
[picture p93: CAD file, 2026-11-05]
files/D_SP/SLANT-SPA-assembly-revA.step
36.0 x 36.0 x 0.497 mm
SP1 slit sheet
SP2 carrier
CH1 Zr film
CH3 Al film
CH5 In film
SP3 shim (Carthage)
