carthage-space-sciences/slant/files/D_ASM/SLANT-bulkhead-standin-2026-10-29.stl

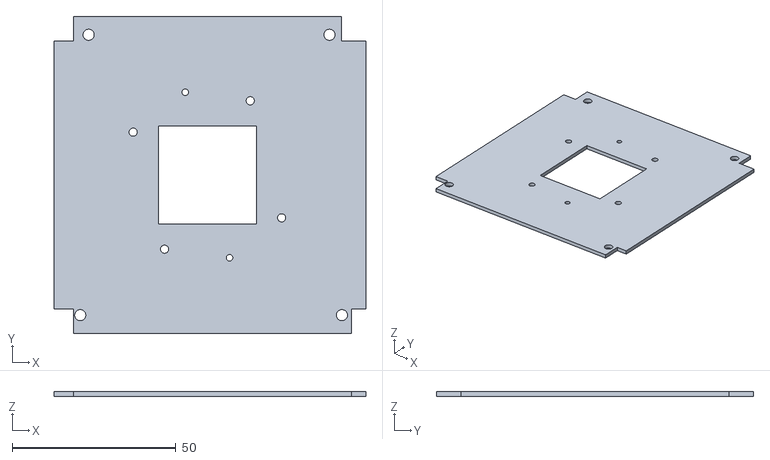
[picture p94: CAD file, 2026-11-05]
files/D_ASM/SLANT-bulkhead-standin-2026-10-29.stl
95.4 x 97.0 x 1.50
