carthage-space-sciences/slant/files/D_H01/SLANT-H01.step

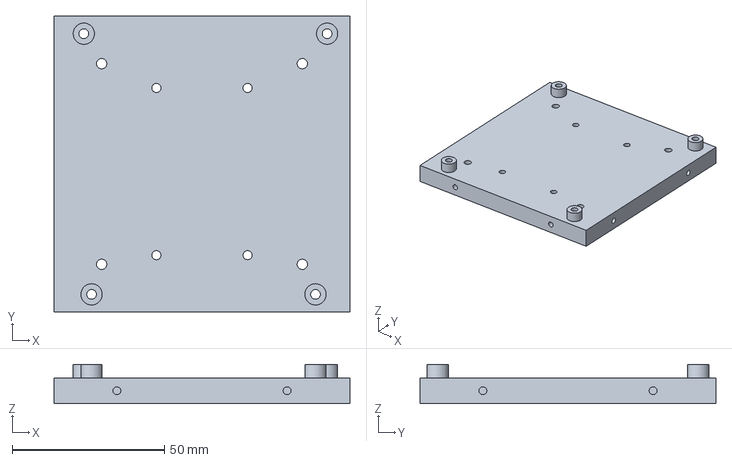
[picture p95: CAD file, 2026-11-05]
files/D_H01/SLANT-H01.step
97.4 x 97.4 x 13.0 mm
