carthage-space-sciences/slant/files/D_H02/SLANT-H02.step

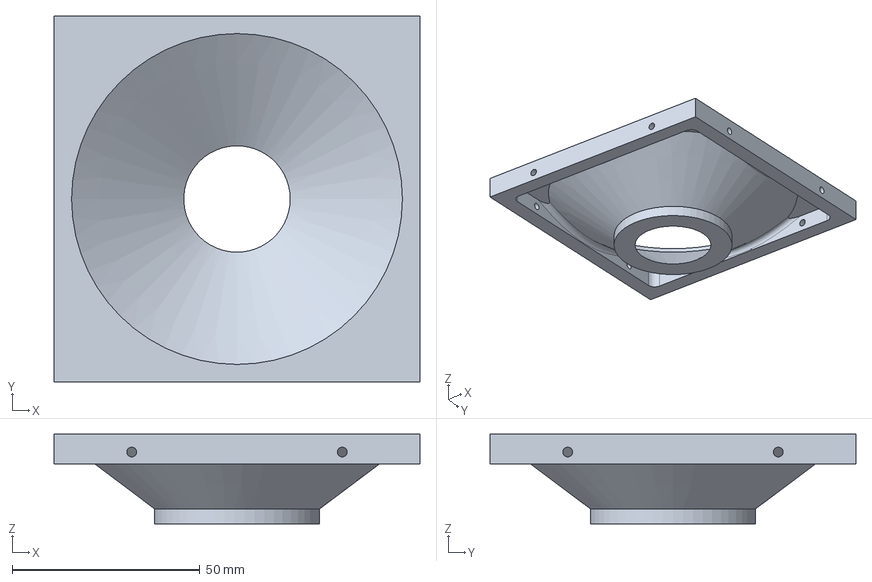
[picture p96: CAD file, 2026-11-05]
files/D_H02/SLANT-H02.step
97.4 x 97.4 x 23.9 mm
