carthage-space-sciences/slant/files/D_H03/SLANT-H03.step

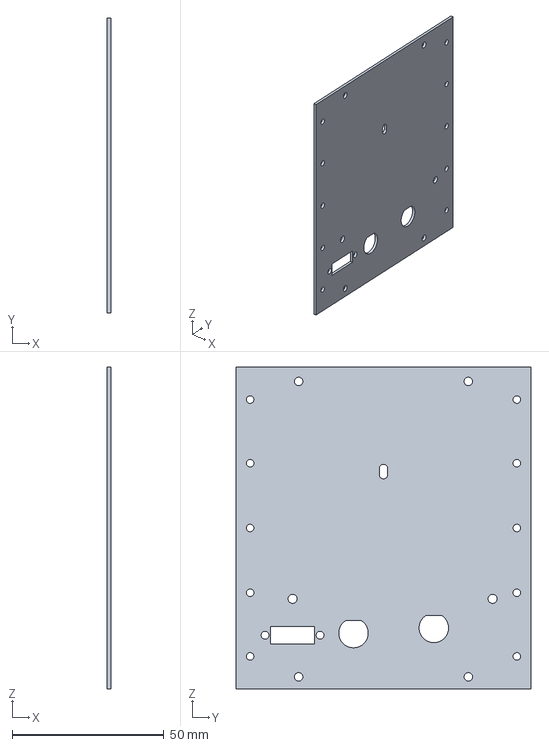
[picture p97: CAD file, 2026-11-05]
files/D_H03/SLANT-H03.step
1.27 x 97.4 x 106.2 mm
