carthage-space-sciences/slant/files/D_H05/SLANT-H05.step

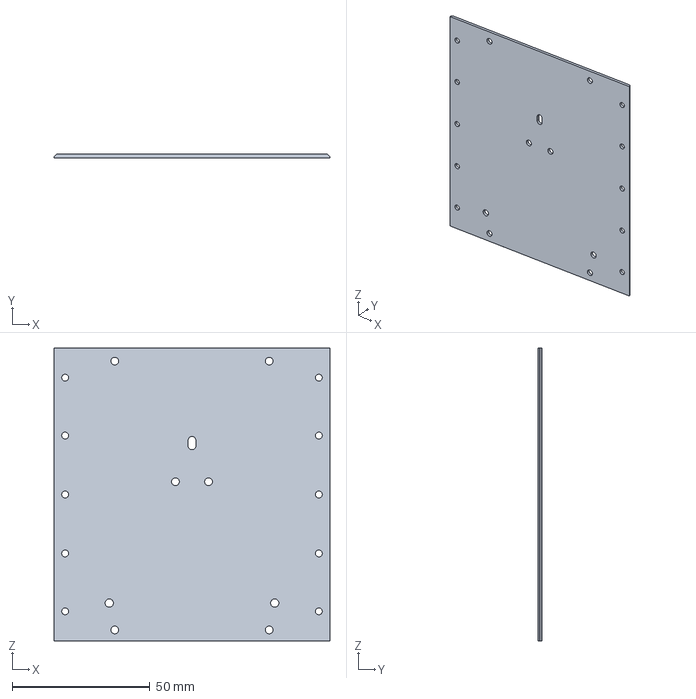
[picture p98: CAD file, 2026-11-05]
files/D_H05/SLANT-H05.step
100.0 x 1.27 x 106.2 mm
