carthage-space-sciences/slant/files/D_H07/SLANT-H07.step

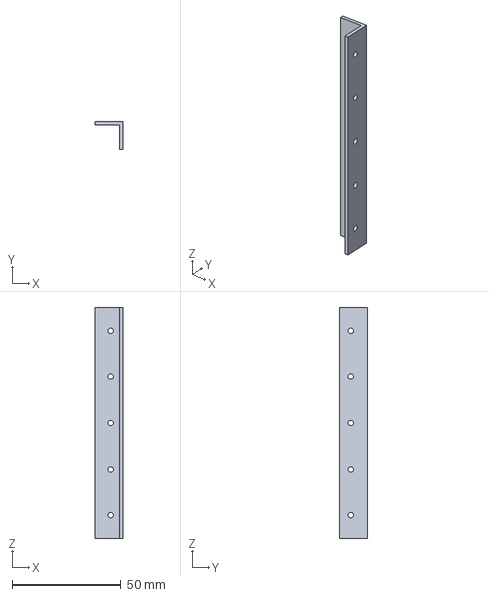
[picture p99: CAD file, 2026-11-05]
files/D_H07/SLANT-H07.step
12.7 x 12.7 x 106.2 mm
