carthage-space-sciences/slant/files/D_H08/SLANT-H08.step

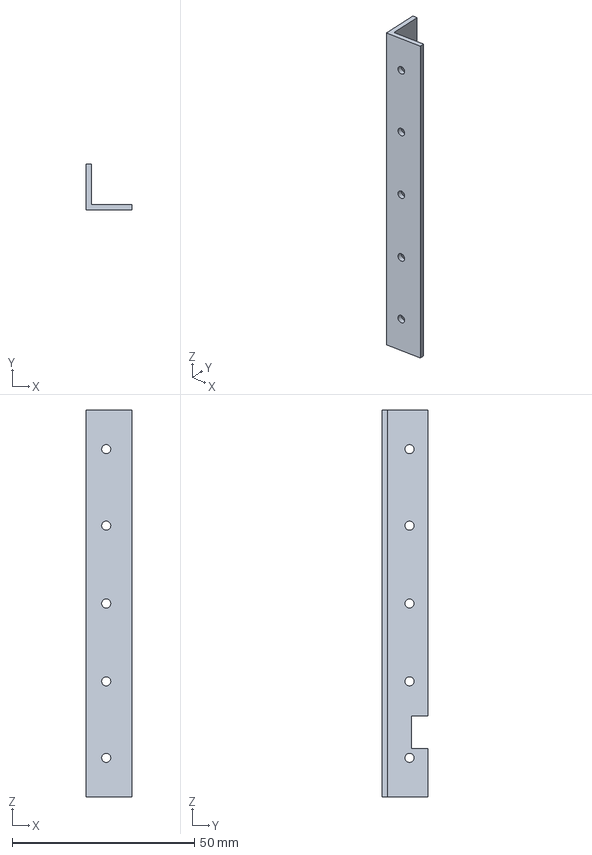
[picture p100: CAD file, 2026-11-05]
files/D_H08/SLANT-H08.step
12.7 x 12.7 x 106.2 mm
