carthage-space-sciences/slant/files/D_H09/SLANT-H09.step

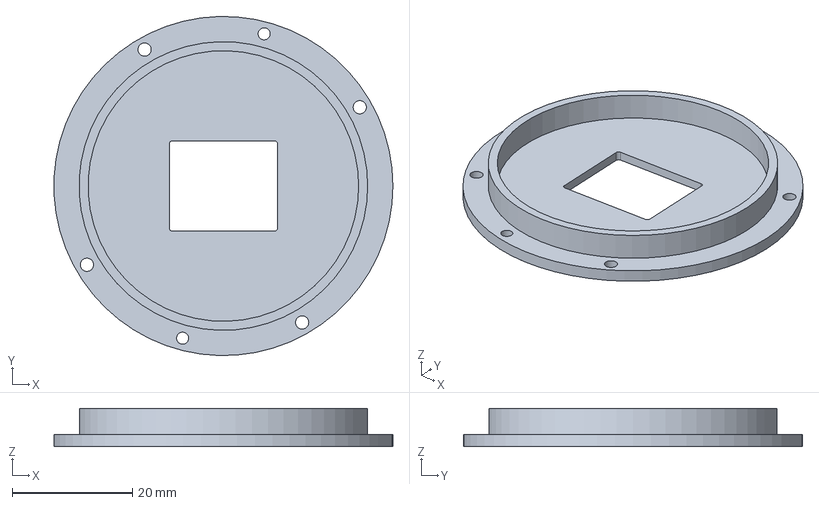
[picture p101: CAD file, 2026-11-05]
files/D_H09/SLANT-H09.step
56.4 x 56.4 x 6.36 mm
