carthage-space-sciences/slant/files/D_SP2/SLANT-SP2-carrier-revC.step

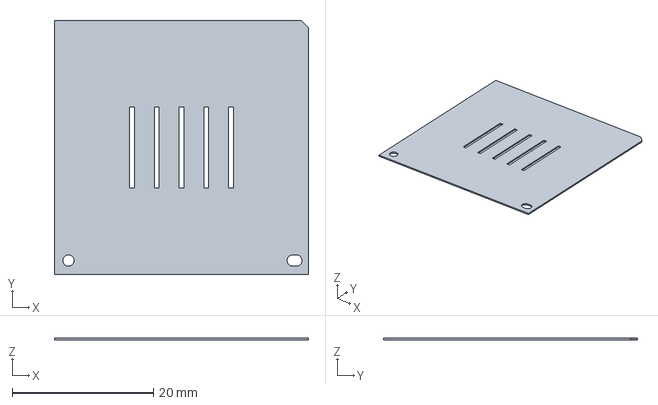
[picture p102: CAD file, 2026-11-05]
files/D_SP2/SLANT-SP2-carrier-revC.step
36.0 x 36.0 x 0.254 mm
