carthage-space-sciences/slant/(list of files, cad)

Other CAD files:
files/D_H04/SLANT-H04.step
files/D_H06/SLANT-H06.step
files/D_ASM/SLANT-bulkhead-standin-2026-10-29.dxf
files/D_SP2/SLANT-SP2-carrier-revC.dxf
