carthage-space-sciences/slant/files/T_DRAW/SLANT-Bench-Assembly-Drawings-2026-10-08.pdf

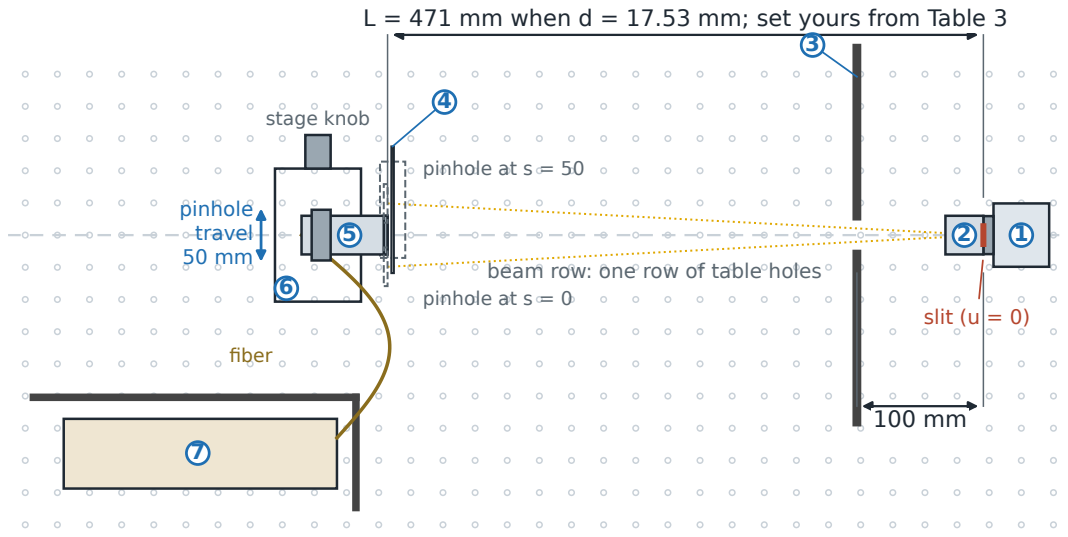
[picture p103: page 1]
slit (u = 0); pinhole at s = 0; pinhole at s = 50; stage knob; pinhole travel 50 mm; fiber

L = 471 mm when d = 17.53 mm; set yours from Table 3

beam row: one row of table holes

### Camera end

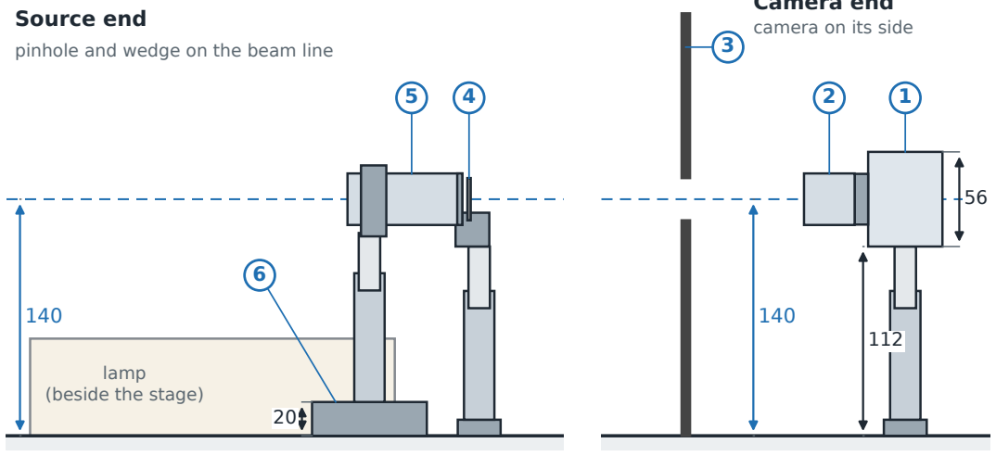
[picture p104: figure]
lamp (beside the stage); Source end; pinhole and wedge on the beam line; camera on its side

Side views, to scale. Heights in mm above the table. Blue dashes: the beam at 140 mm. Camera height 56 mm is the manual's drawing; measure yours.

light

SM1RR
retaining ring

S100LK slit

engraved face toward the light
SM1L10 hood

slit sits here, on the stop at the hood's threaded end

SM1A9 adapter

stays empty msCAM, lens removed

filter behind the C-mount ring: never remove it

Looking into the hood from the source side: the camera lies on its side and the
slit stands vertical, along the camera's 2,048-pixel direction. Step A1 finds which side to lay the camera on.

Exploded view, not to scale. The slit goes inside the hood, at its far (threaded) end; the SM1A9 stays empty.

camera front panel

m1 = how far the
C-mount holder
face stands out
from the panel

m1

camera front panel

m4

m5

m4 = hood face to panel. m5 = depth from the hood face down to the slit's engraved face. Slit-to-sensor distance d = 17.53 + m4 − m5 − m1 (mm)

Step A3: before fitting the adapter | Step A6: adapter, hood and slit fitted

s = 0, brightest

s = 25

s = 50, faintest
about 340 rows
over the full
50 mm of travel

each strip about 30 to 40 rows tall (half-brightness edge to edge)

What the viewer should show (full sensor). Counts assume 5.5 µm pixels on a 2,048 × 1,088 sensor; Step E measures them. The strip may move up or down as s rises; either is correct. Brightness may also step where the strip crosses a color band.

strip about 1,800 of the 2,048 columns long
