carthage-space-sciences/slant/files/D_ASM/SLANT-1U-Assembly-Instructions-2026-10-31.pdf

## Carthage College Space Sciences

# SLANT 1U

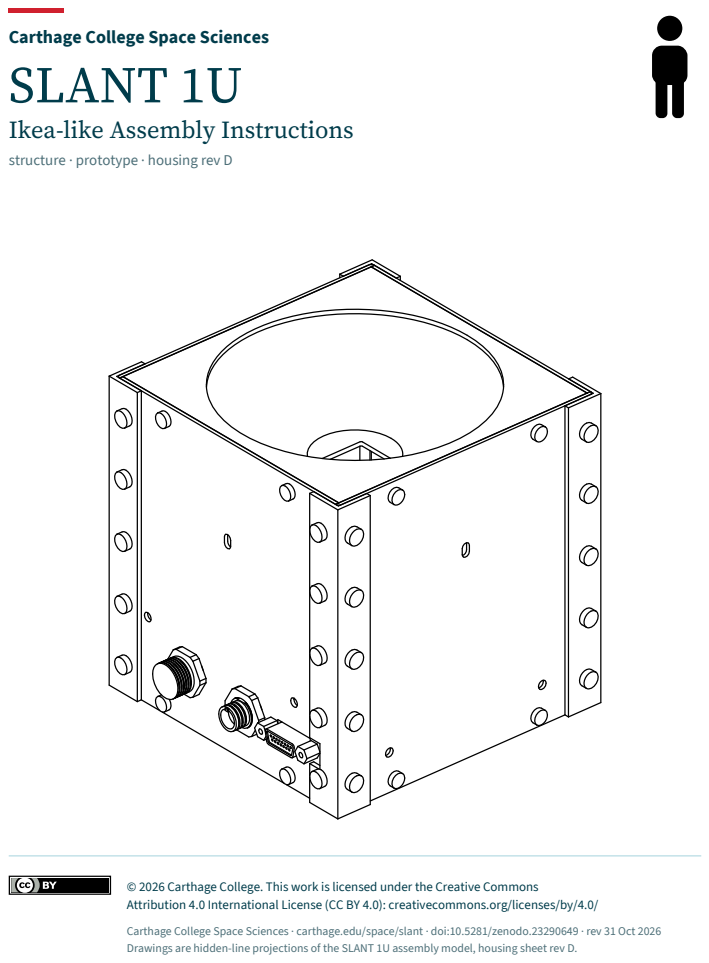
[picture p105: page 1]

Ikea-like Assembly Instructions

structure · prototype · housing rev D

© 2026 Carthage College. This work is licensed under the Creative Commons
Attribution 4.0 International License (CC BY 4.0): creativecommons.org/licenses/by/4.0/
Carthage College Space Sciences · carthage.edu/space/slant · doi:10.5281/zenodo.23290649 · rev 31 Oct 2026
Drawings are hiddenline projections of the SLANT 1U assembly model, housing sheet rev D.

## IPA

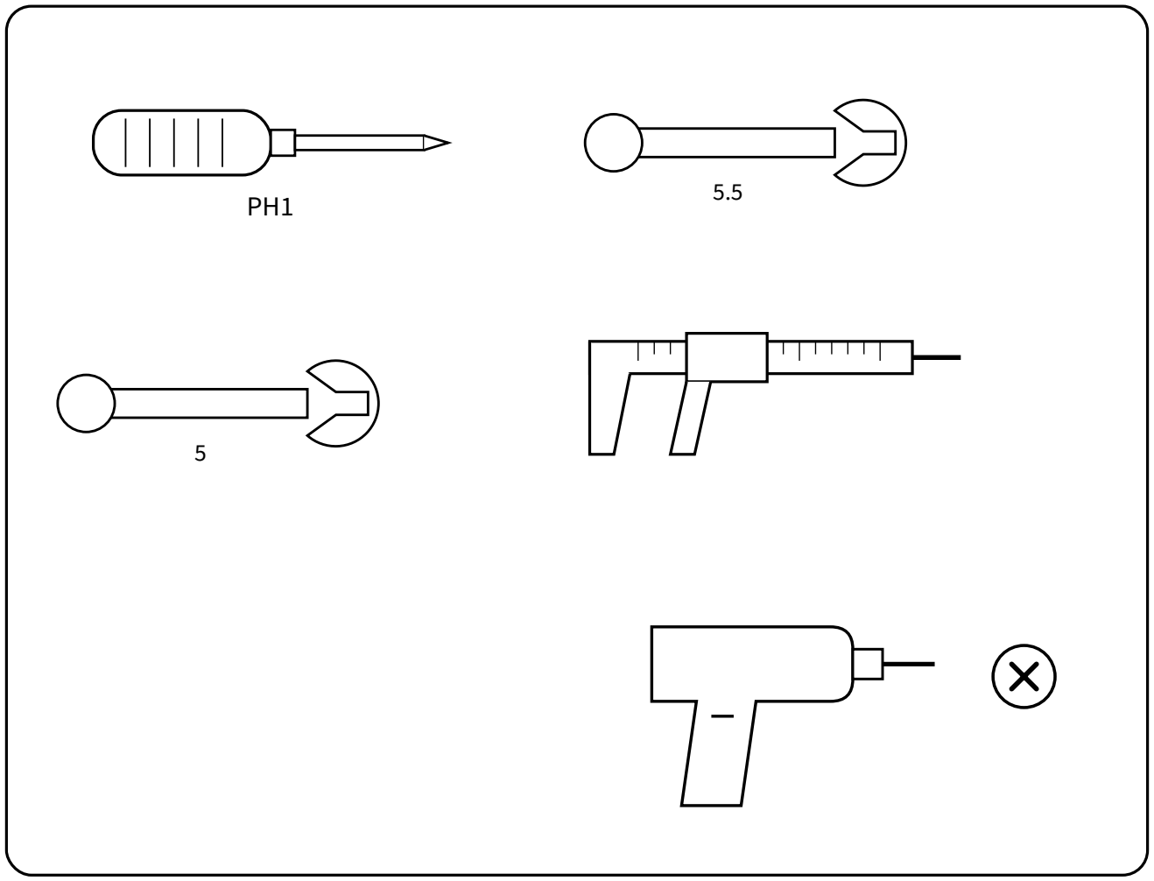
[picture p106: figure]

Carthage College Space Sciences SLANT 1U · Ikea-like Assembly Instructions · rev 31 Oct 2026
© 2026 Carthage College · CC BY 4.0 · carthage.edu/space/slant · doi:10.5281/zenodo.23290649

2 / 20

B

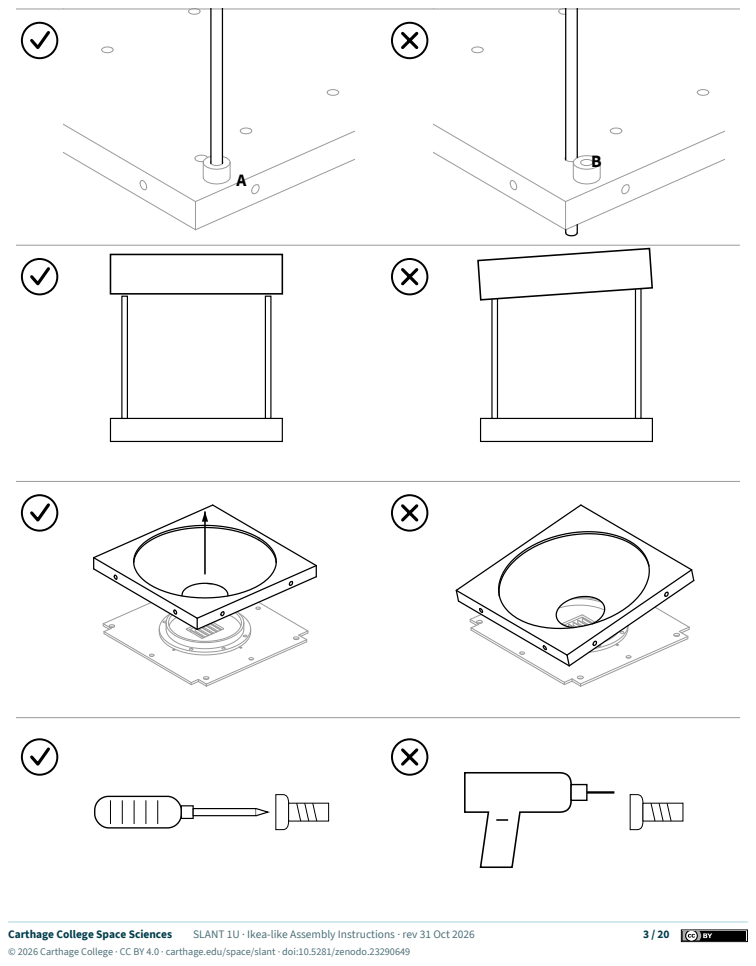
[picture p107: page 3]

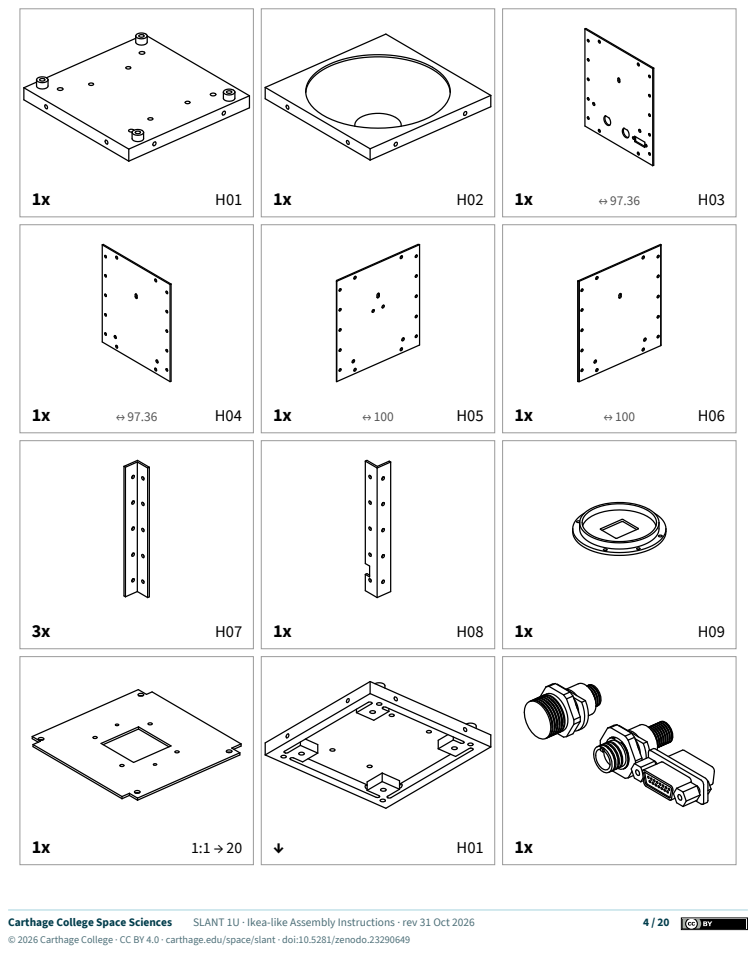
[picture p108: page 4]

4x R → 2

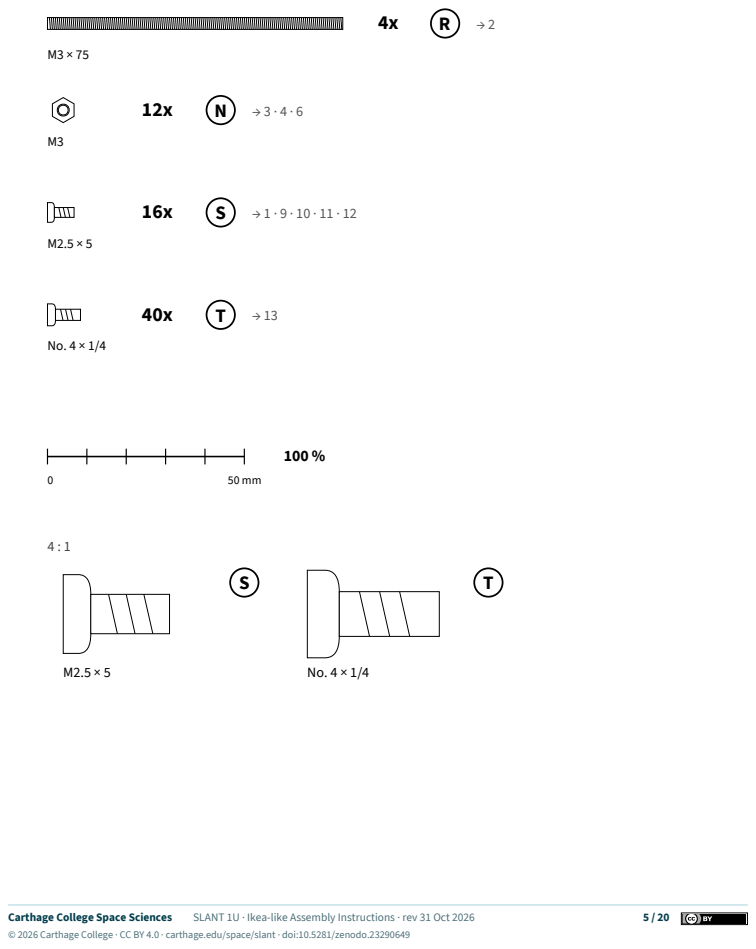
[picture p109: page 5]

1
S

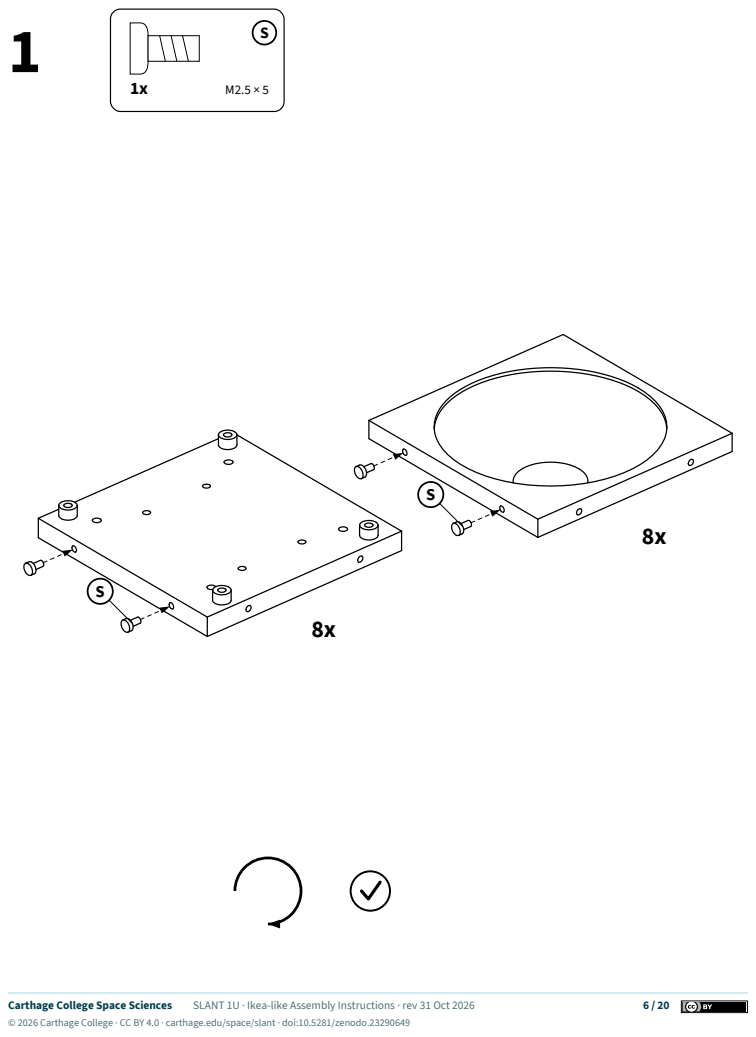
[picture p110: page 6]

2
R

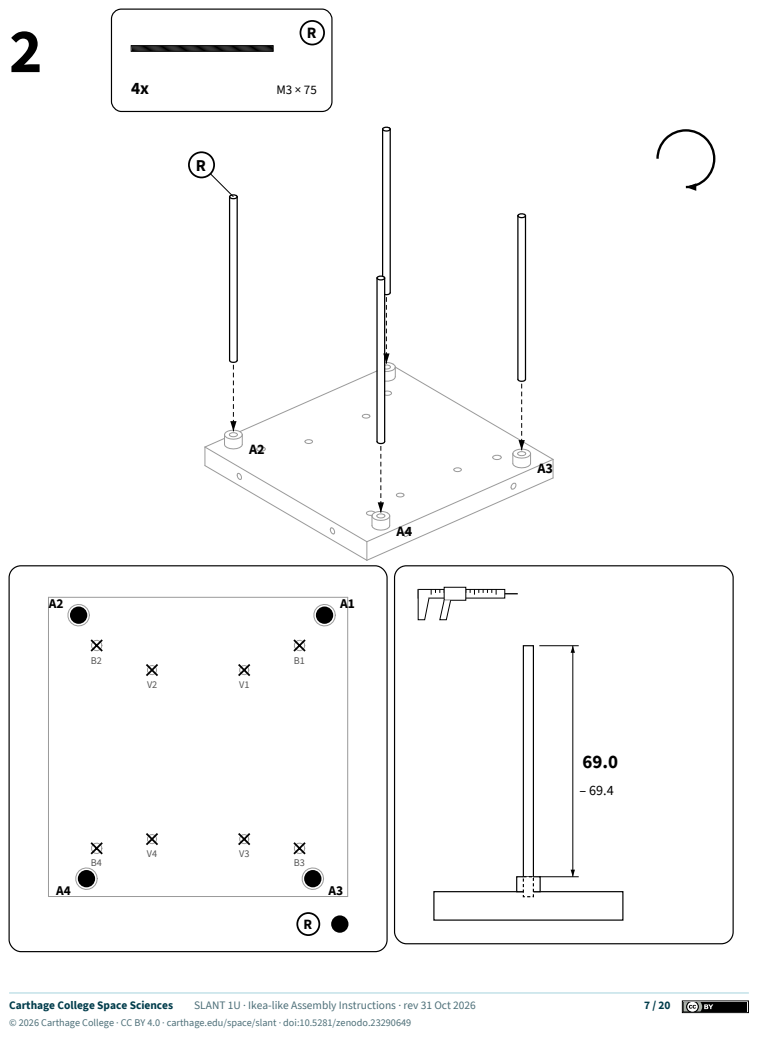
[picture p111: page 7]

3
N

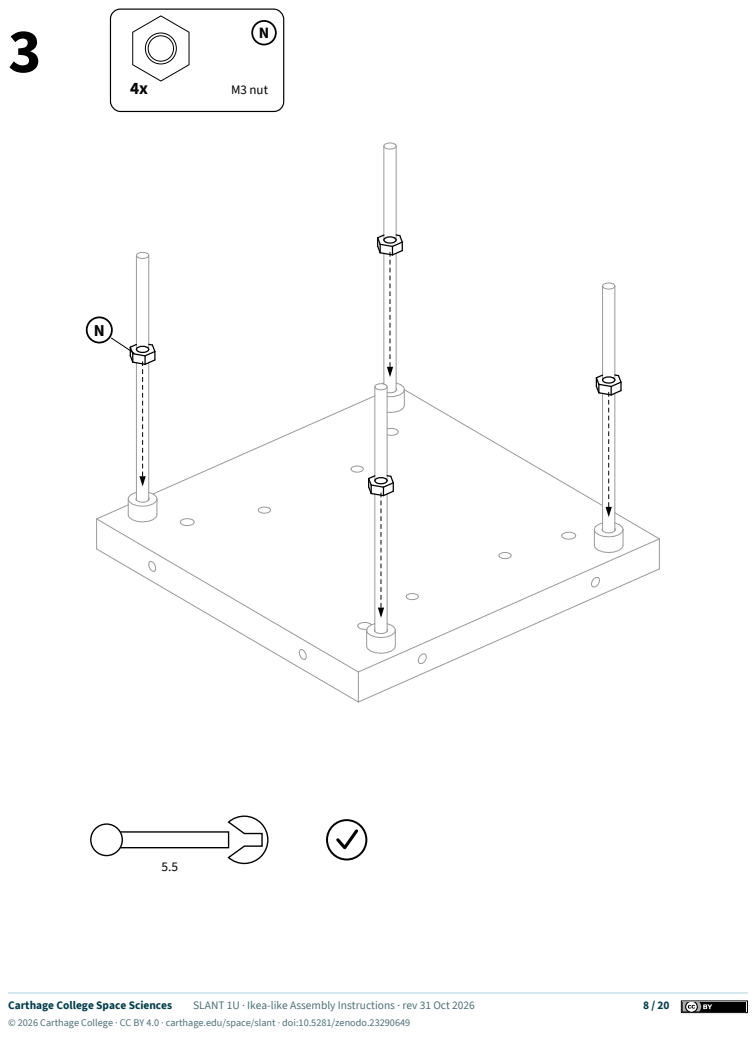
[picture p112: page 8]
M3 nut

4
N

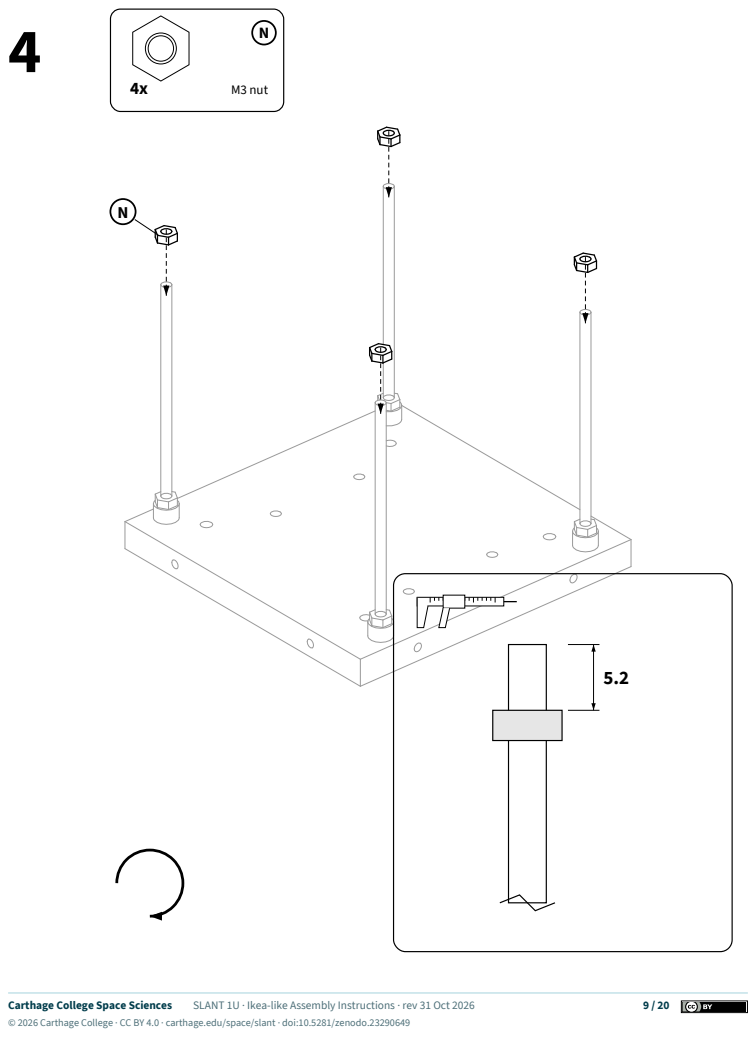
[picture p113: page 9]
M3 nut

5

1:1 → 20

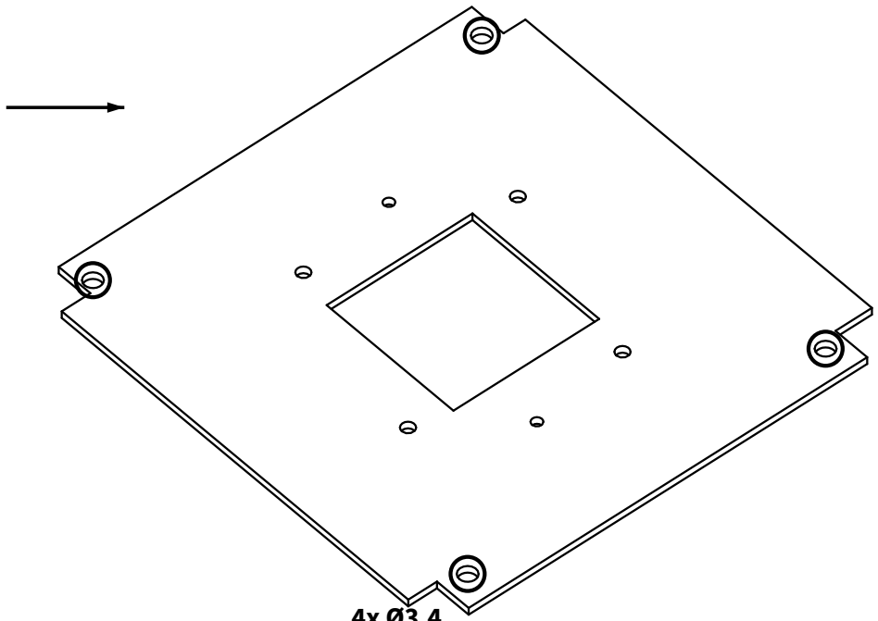
[picture p114: figure]

4x Ø3.4

## 1.5 mm

10 / 20

6
N

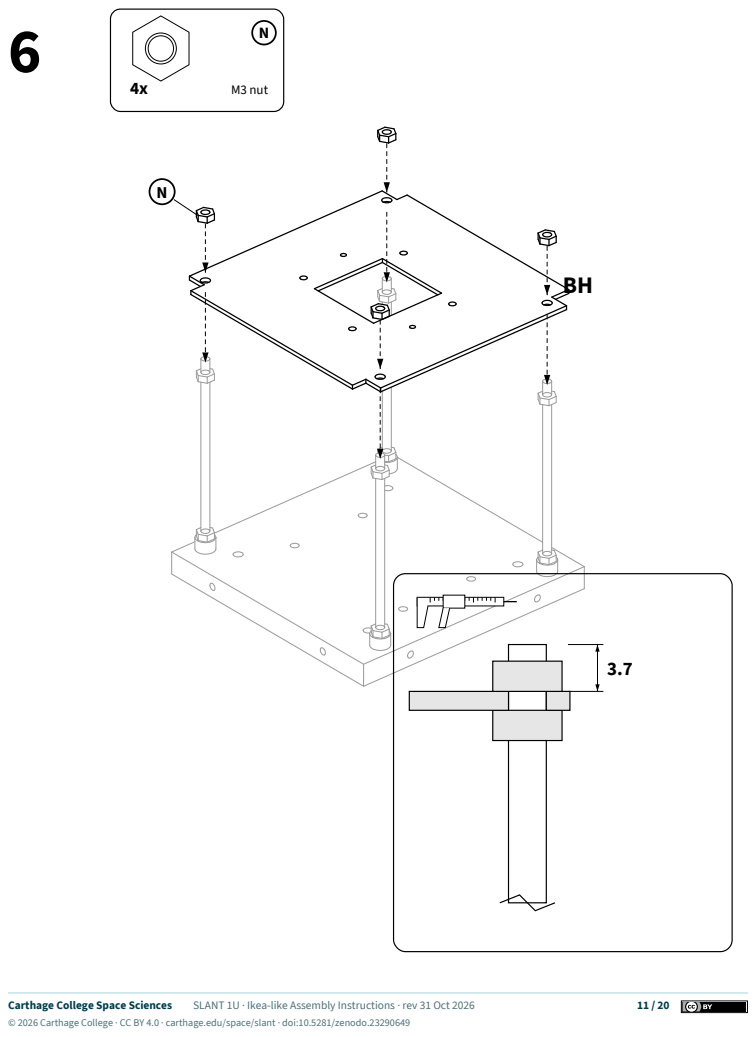
[picture p115: page 11]
M3 nut

7

H09

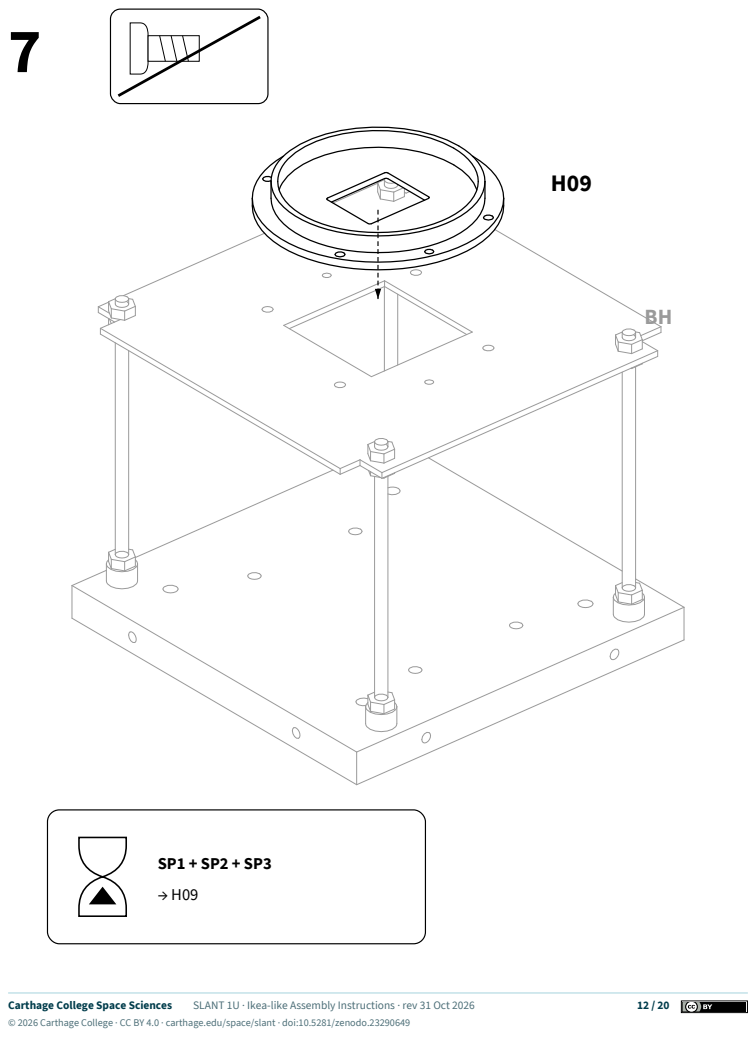
[picture p116: page 12]

8

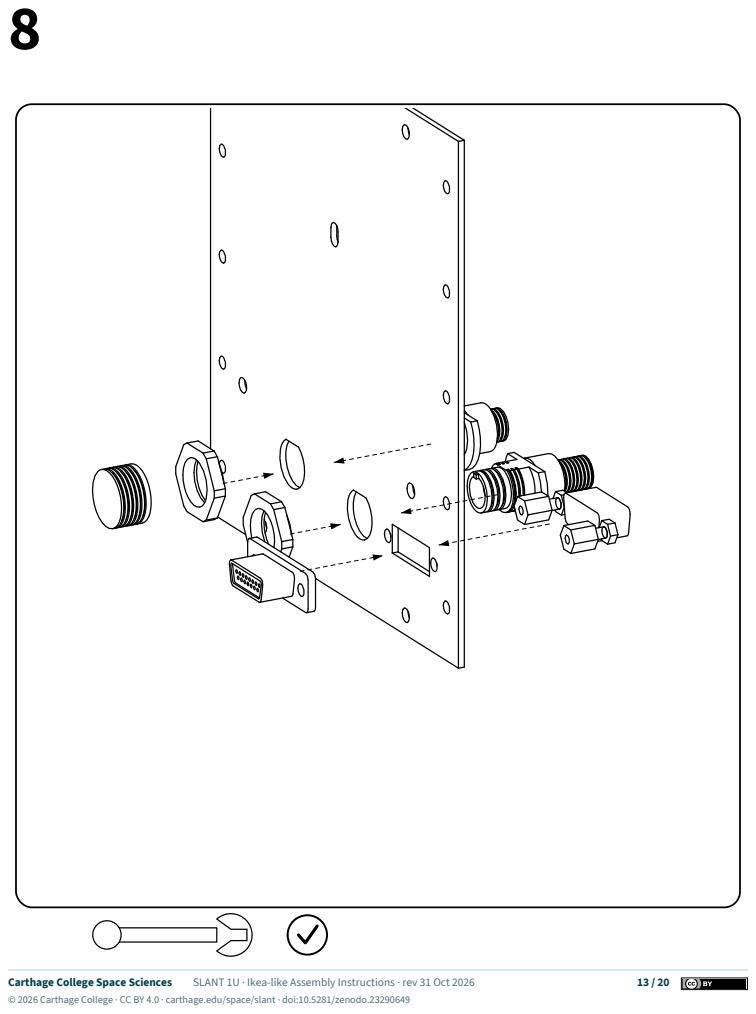
[picture p117: page 13]

9
S

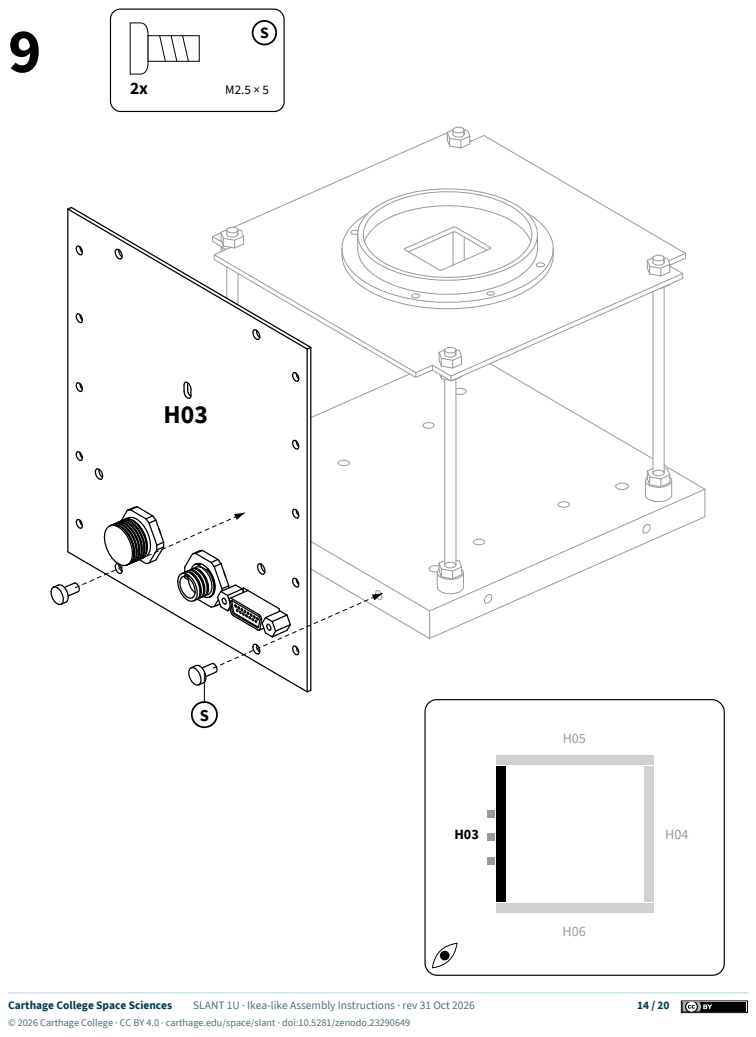
[picture p118: page 14]

10
S

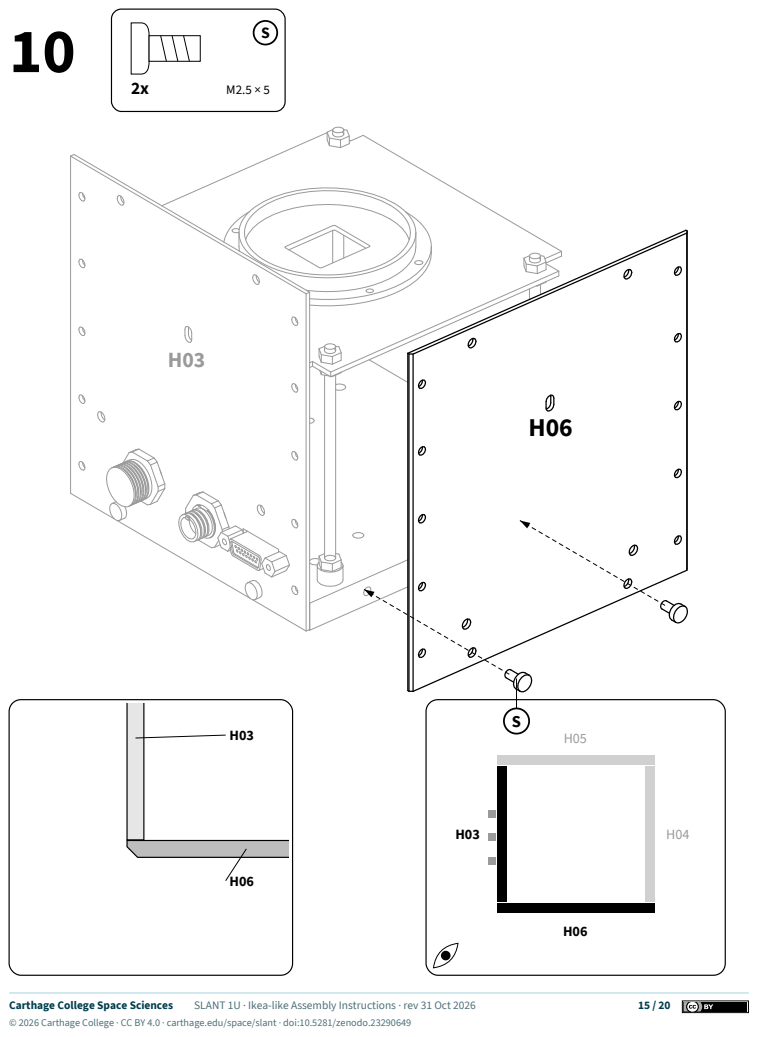
[picture p119: page 15]

11
S

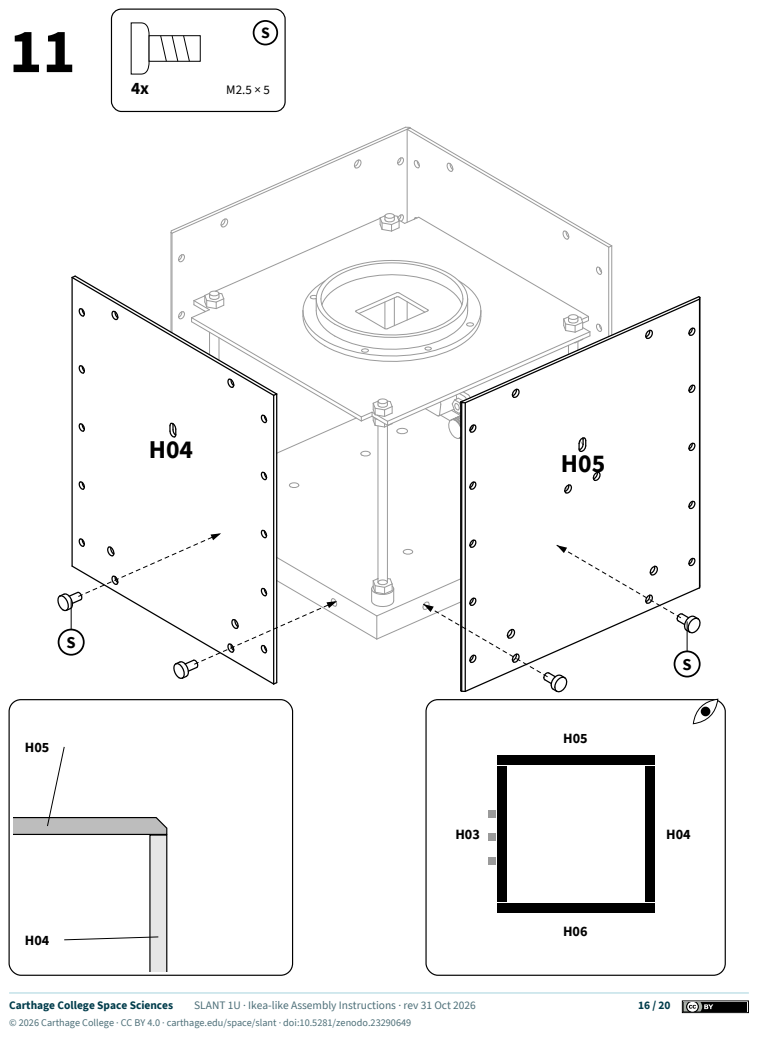
[picture p120: page 16]

12
S

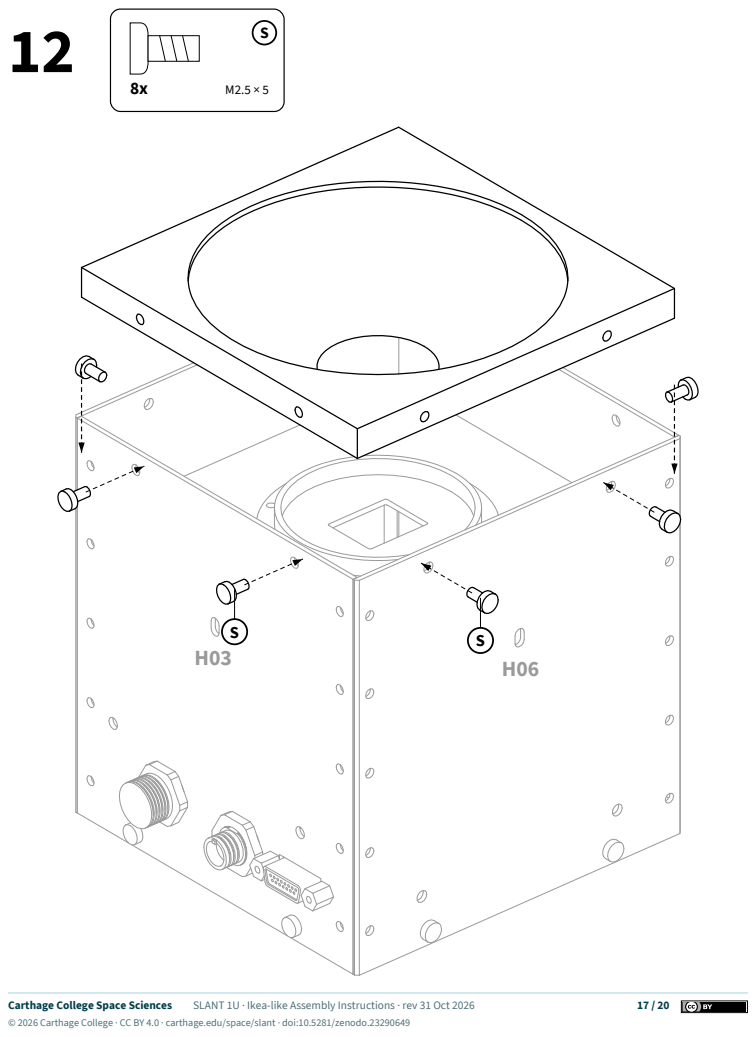
[picture p121: page 17]

13
T

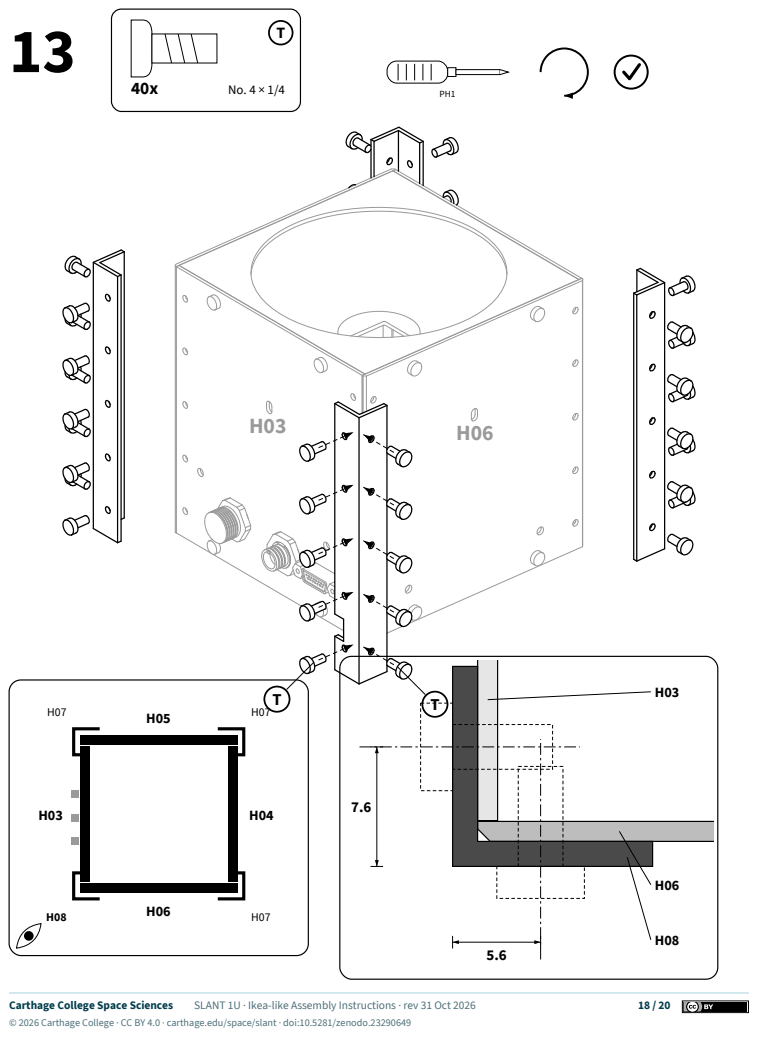
[picture p122: page 18]

14

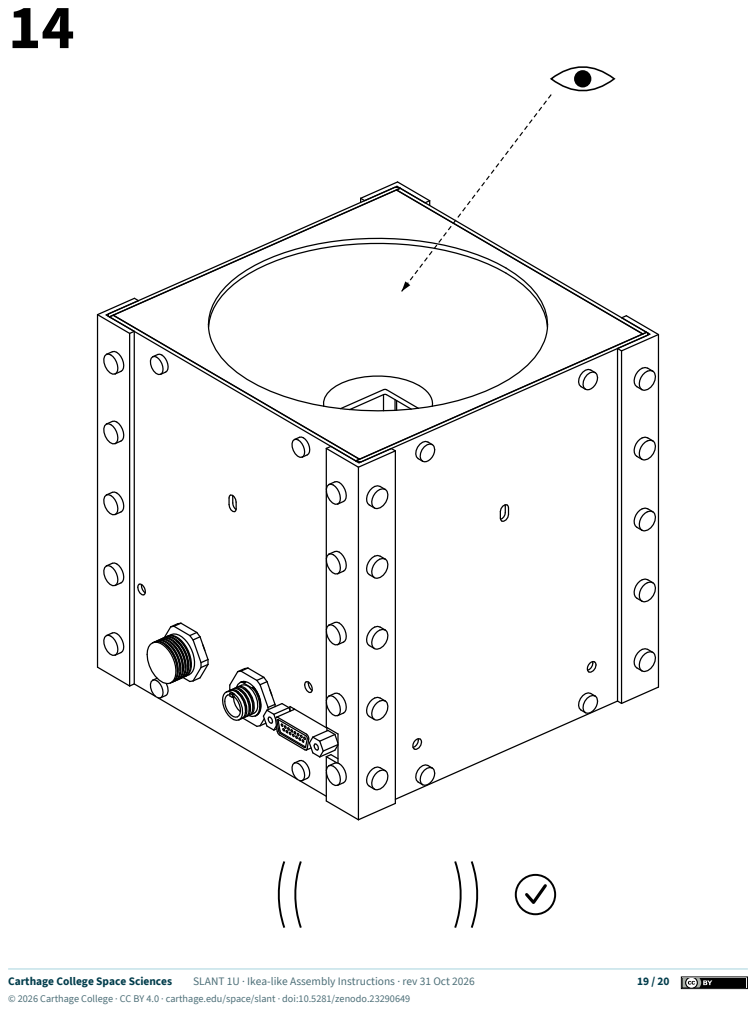
[picture p123: page 19]

## BH 1:1 · 1.5 mm

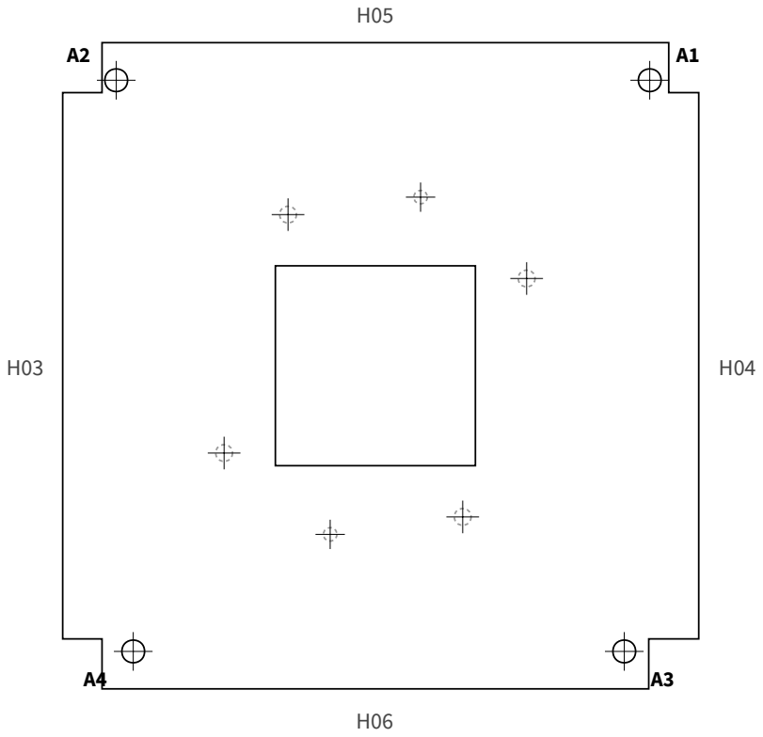
[picture p124: figure]

Ø3.4 4x | 30 × 30 | Ø2.5 4x | Ø2.0 2x
0 | 50 mm

100 %

Files: SLANT-bulkhead-standin-2026-10-29 (.dxf for cutting; .stl and .3mf for printing; .step)

20 / 20
