carthage-space-sciences/slant/files/M03/SLANT-Modeling-Chain-2026-10-01.pdf

# How the performance in Figure 2 was computed

## 1 Truth atmosphere

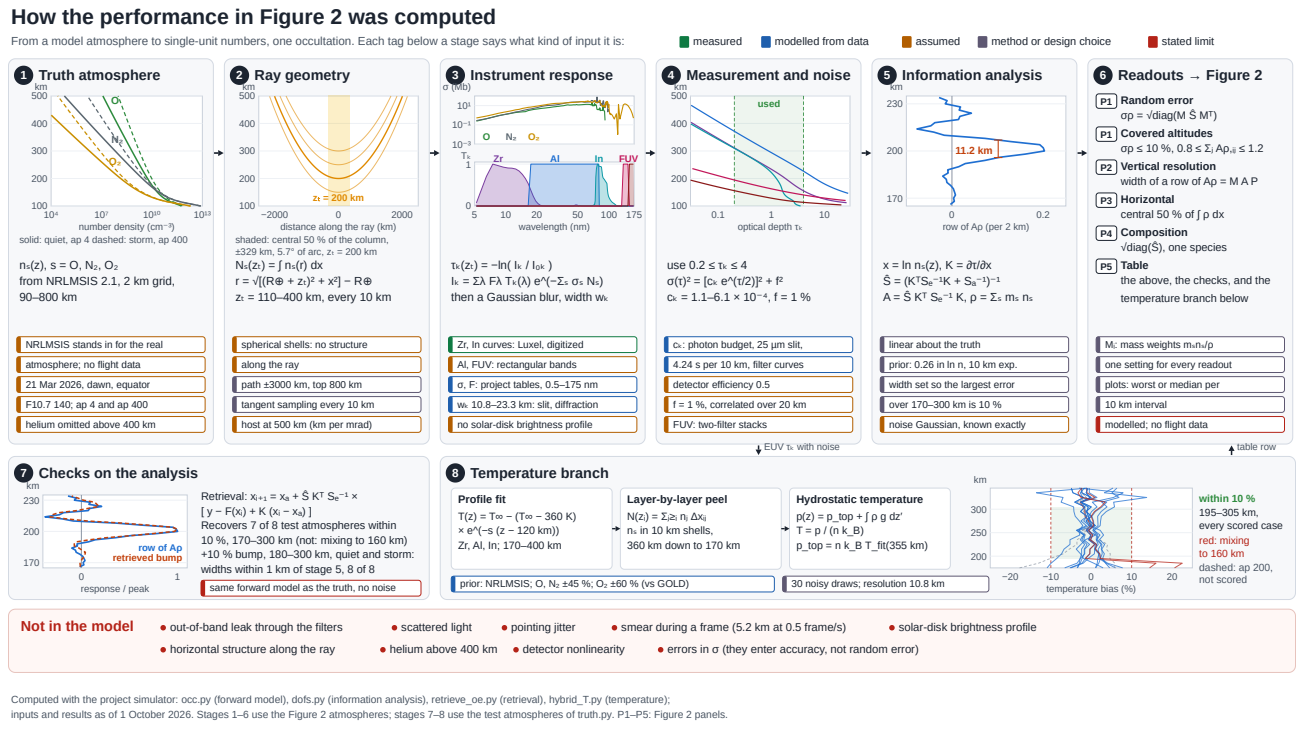
[picture p125: page 1]
From a model atmosphere to single-unit numbers, one occultation. Each tag below a stage says what kind of input it is:; measured; modelled from data; assumed; method or design choice; stated limit; 2 Ray geometry; 3 Instrument response; wavelength (nm); FUV; 4 Measurement and noise; used; use 0.2 ≤ τₖ ≤ 4 σ(τ)² = [cₖ e^(τ/2)]² + f² cₖ = 1.1–6.1 × 10⁻⁴, f = 1 %; 5 Information analysis; 6 Readouts → Figure 2; response / peak; 8 Temperature branch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

P1 Random error
σρ = √diag(M Ŝ Mᵀ)
P1 Covered altitudes
P2 Vertical resolution
width of a row of Aρ = M A P
P3 Horizontal
central 50 % of ∫ ρ dx
P4 Composition
√diag(Ŝ), one species

distance along the ray (km)

optical depth τₖ

row of Aρ (per 2 km)

number density (cm⁻³)

solid: quiet, ap 4 dashed: storm, ap 400
from NRLMSIS 2.1, 2 km grid,

shaded: central 50 % of the column,
±329 km, 5.7° of arc, zₜ = 200 km
zₜ = 110–400 km, every 10 km

τₖ(zₜ) = −ln( Iₖ / I₀ₖ )
then a Gaussian blur, width wₖ

Ŝ = (KᵀSₑ⁻¹K + Sₐ⁻¹)⁻¹

P5 Table
the above, the checks, and the
temperature branch below

cₖ: photon budget, 25 µm slit,
4.24 s per 10 km, filter curves
detector efficiency 0.5
f = 1 %, correlated over 20 km
FUV: two-filter stacks

Mᵢ: mass weights mₛnₛ/ρ
one setting for every readout
plots: worst or median per
10 km interval
modelled; no flight data

NRLMSIS stands in for the real
atmosphere; no flight data
21 Mar 2026, dawn, equator
F10.7 140; ap 4 and ap 400
helium omitted above 400 km

spherical shells: no structure
along the ray
path ±3000 km, top 800 km
tangent sampling every 10 km
host at 500 km (km per mrad)

Zr, In curves: Luxel, digitized
Al, FUV: rectangular bands
σ, F: project tables, 0.5–175 nm
wₖ 10.8–23.3 km: slit, diffraction
no solar-disk brightness profile

linear about the truth
prior: 0.26 in ln n, 10 km exp.
width set so the largest error
over 170–300 km is 10 %
noise Gaussian, known exactly

7 Checks on the analysis

Retrieval: xᵢ₊₁ = xₐ + Ŝ Kᵀ Sₑ⁻¹ ×
Recovers 7 of 8 test atmospheres within
10 %, 170–300 km (not: mixing to 160 km)
+10 % bump, 180–300 km, quiet and storm:
widths within 1 km of stage 5, 8 of 8
same forward model as the truth, no noise

within 10 %
every scored case
red: mixing
dashed: ap 200,

Profile fit

Layer-by-layer peel
N(zᵢ) = Σⱼ≥ᵢ nⱼ Δxᵢⱼ
nₛ in 10 km shells,
360 km down to 170 km

row of Aρ
retrieved bump

Computed with the project simulator: occ.py (forward model), dofs.py (information analysis), retrieve_oe.py (retrieval), hybrid_T.py (temperature);
inputs and results as of 1 October 2026. Stages 1–6 use the Figure 2 atmospheres; stages 7–8 use the test atmospheres of truth.py. P1–P5: Figure 2 panels.
