carthage-space-sciences/slant/(commit log)

2026-11-05 Publish the SLANT evidence site, build of 4 November 2026
    Replaces the holding page with the evidence site: index.html, files/,
    prev/ and manifest.json (SHA-256 of all 94 published files).
    Claude-Session: https://claude.ai/code/session_01SJD84dpe5AoHhL6Hs15XQR
    [SLANT-Bench-A5-Optical-Depth-2026-10-18.csv, SLANT-Carrier-BOM-2026-10-31.csv, SLANT-H01.step, SLANT-H02.step, SLANT-H03.step, SLANT-H04.step, SLANT-H05.step, SLANT-H06.step]
2026-11-05 Withdraw the carrier-board files from the evidence site
    Removes the schematic, board layout, bill of materials, block diagram,
    design record, KiCad project and board-fit drawing. Manifest now lists 74 files.
    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
    [SLANT-Carrier-BOM-2026-10-31.csv]
